ajisrawi/polarization-crpa/hardware/antenna/array_plate/render_bottom.png

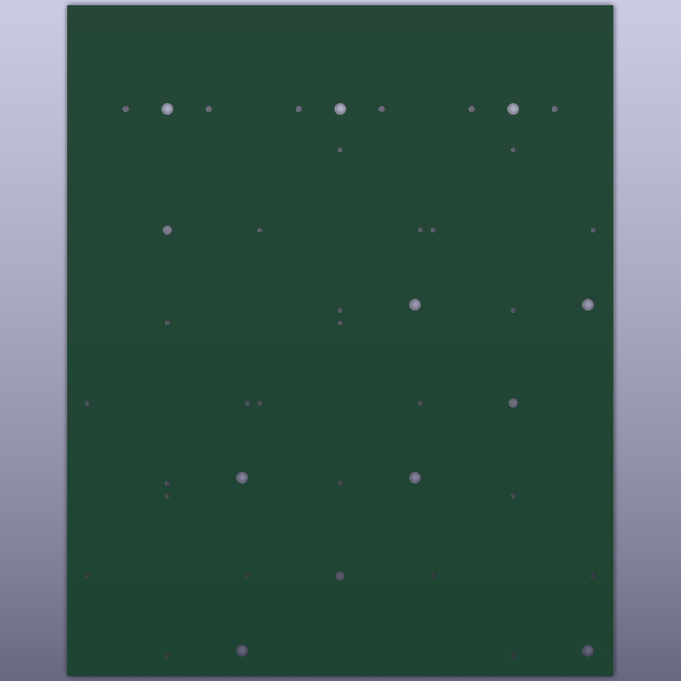
hardware/antenna/array_plate/render_bottom.png
