ajisrawi/polarization-crpa/hardware/antenna/array_plate/render_top.png

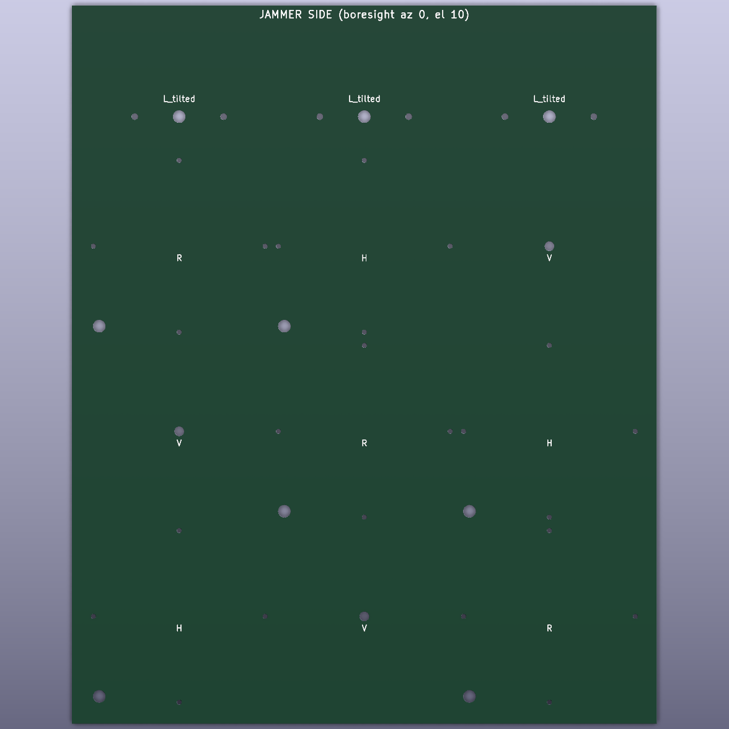
hardware/antenna/array_plate/render_top.png
