ajisrawi/polarization-crpa/hardware/antenna/feed_circular/render_bottom.png

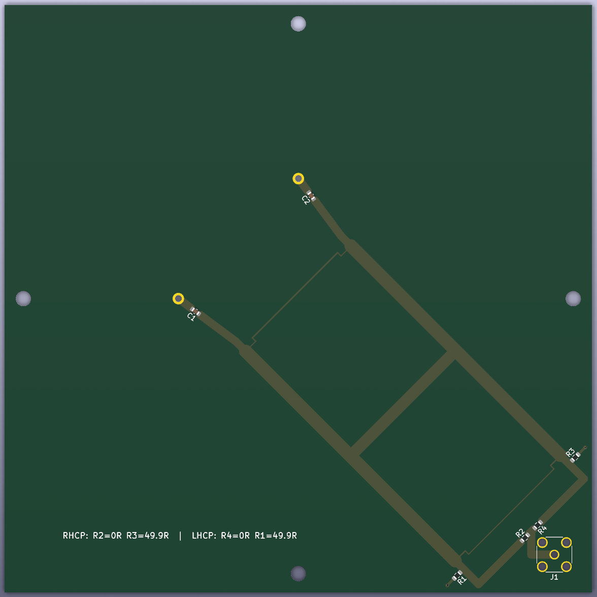
hardware/antenna/feed_circular/render_bottom.png
