ajisrawi/polarization-crpa/hardware/antenna/feed_circular/render_top.png

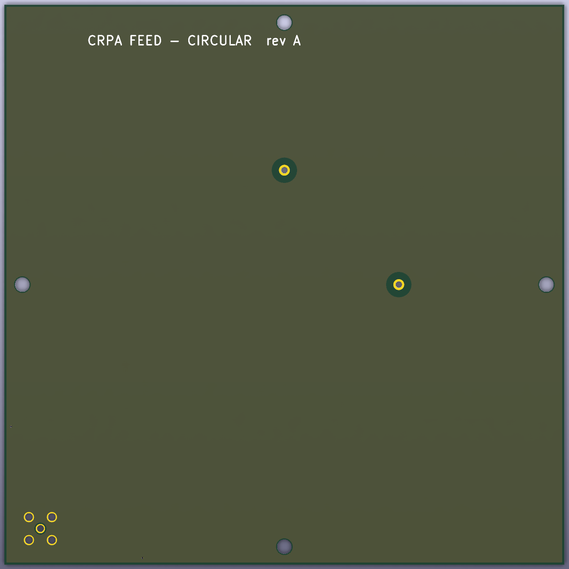
hardware/antenna/feed_circular/render_top.png
