ajisrawi/polarization-crpa/hardware/antenna/feed_linear_000/render_bottom.png

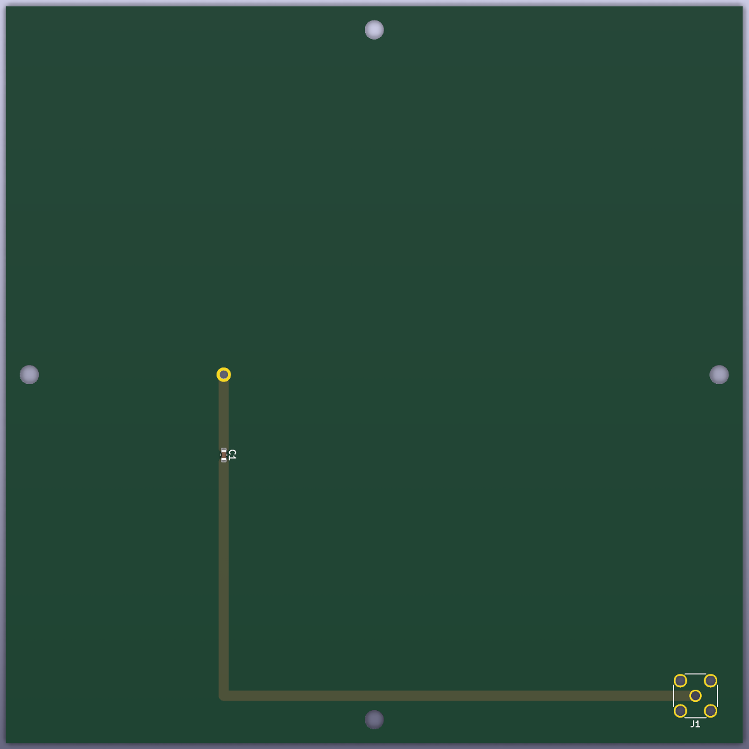
hardware/antenna/feed_linear_000/render_bottom.png
