ajisrawi/polarization-crpa/hardware/antenna/feed_linear_060/render_bottom.png

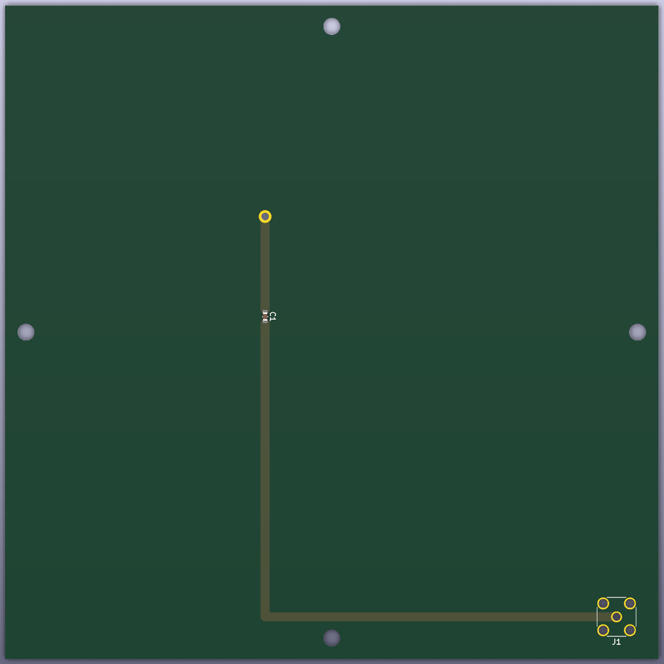
hardware/antenna/feed_linear_060/render_bottom.png
