ajisrawi/polarization-crpa/hardware/antenna/feed_linear_120/render_bottom.png

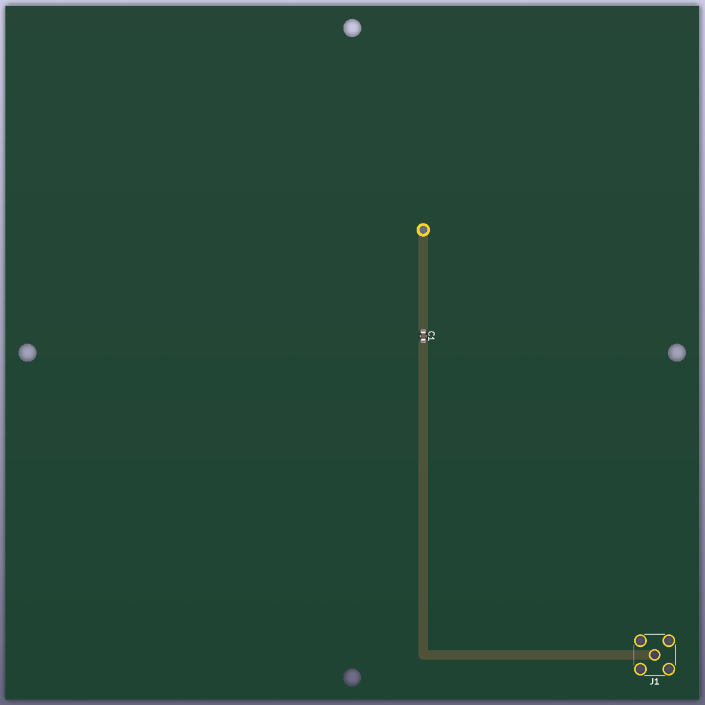
hardware/antenna/feed_linear_120/render_bottom.png
