ajisrawi/polarization-crpa/hardware/antenna/hybrid_response.png

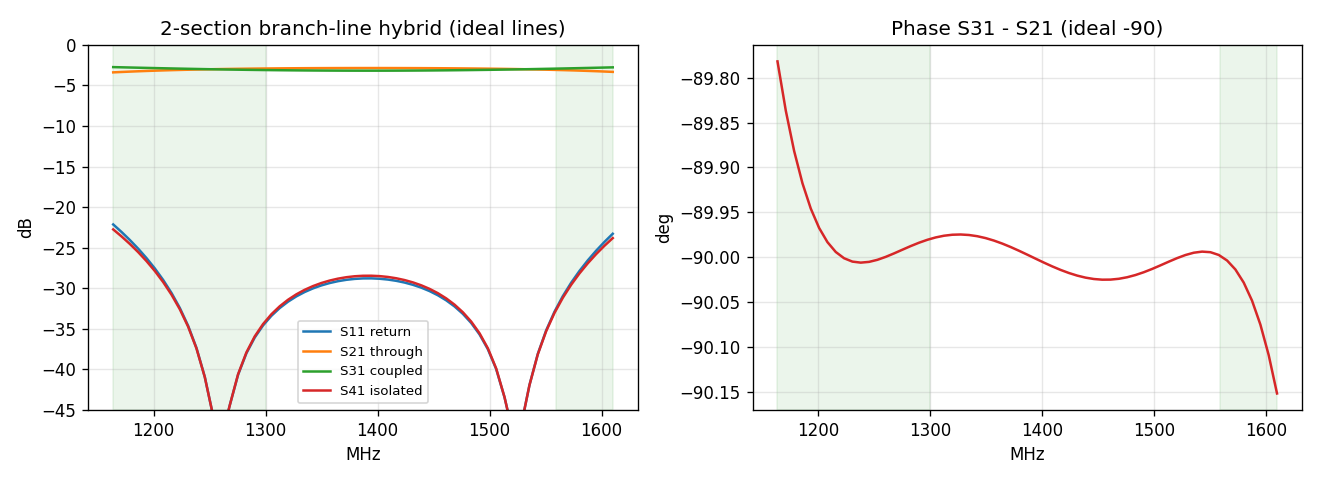
hardware/antenna/hybrid_response.png
