ajisrawi/polarization-crpa/hardware/antenna/patch_lower/render_bottom.png

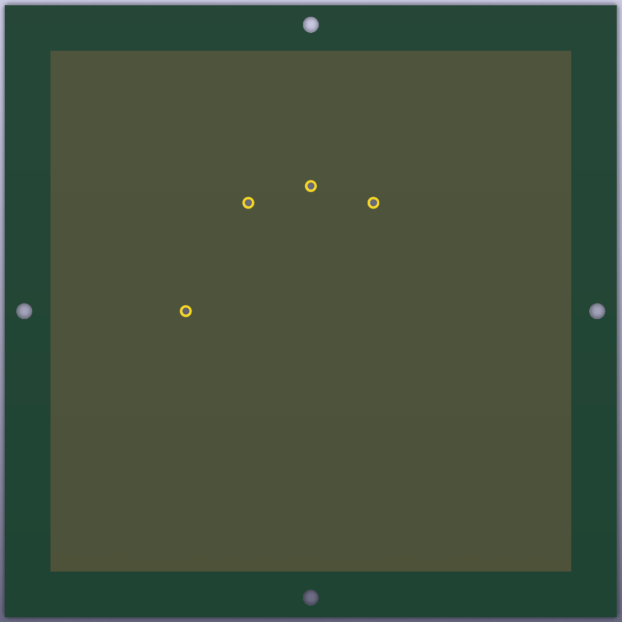
hardware/antenna/patch_lower/render_bottom.png
