ajisrawi/polarization-crpa/hardware/antenna/patch_lower/render_top.png

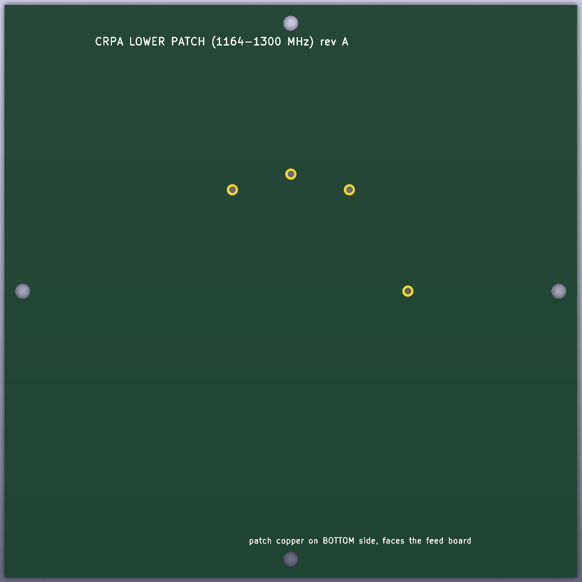
hardware/antenna/patch_lower/render_top.png
