ajisrawi/polarization-crpa/hardware/antenna/patch_upper/render_bottom.png

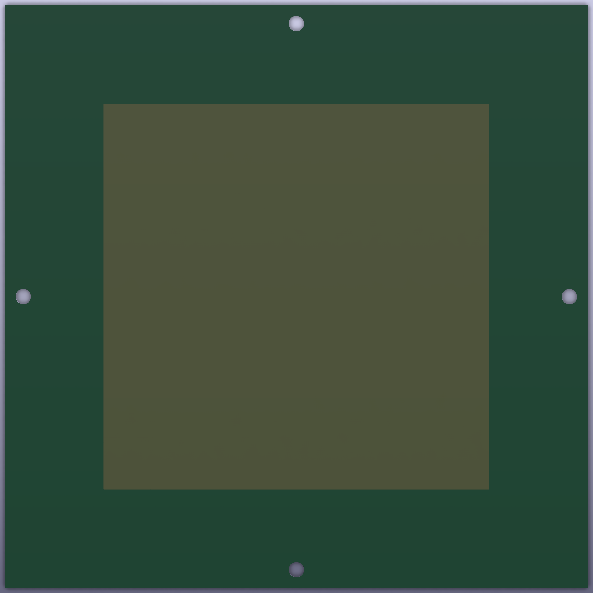
hardware/antenna/patch_upper/render_bottom.png
