ajisrawi/polarization-crpa/hardware/antenna/render3d/array_iso.png

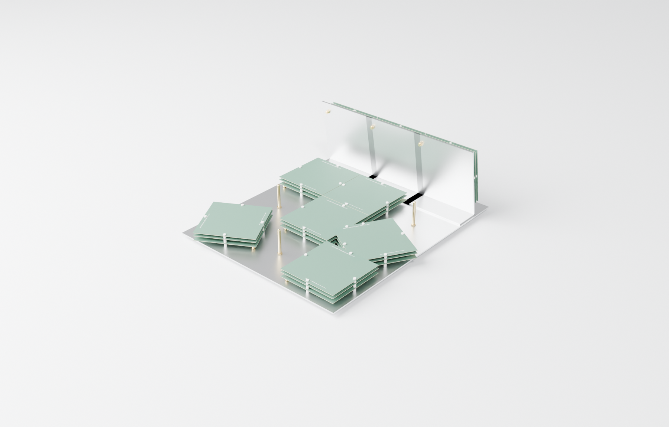
hardware/antenna/render3d/array_iso.png
