ajisrawi/polarization-crpa/hardware/antenna/render3d/array_jammer_side.png

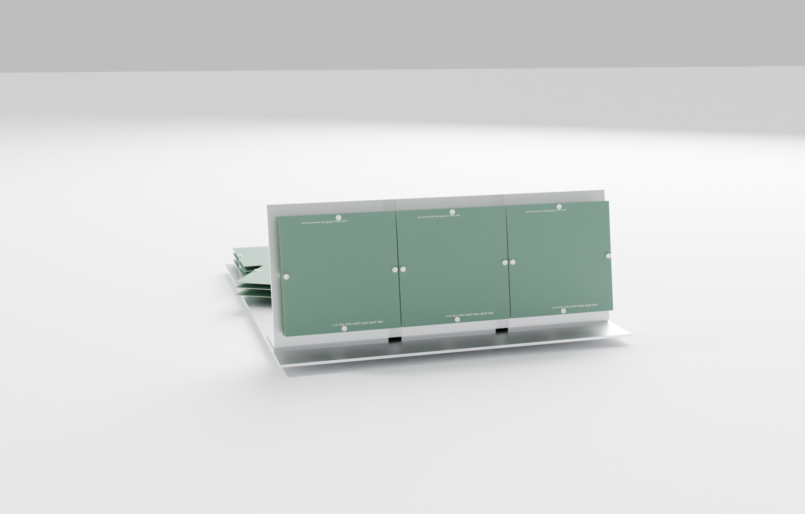
hardware/antenna/render3d/array_jammer_side.png
