ajisrawi/polarization-crpa/hardware/antenna/render3d/array_top.png

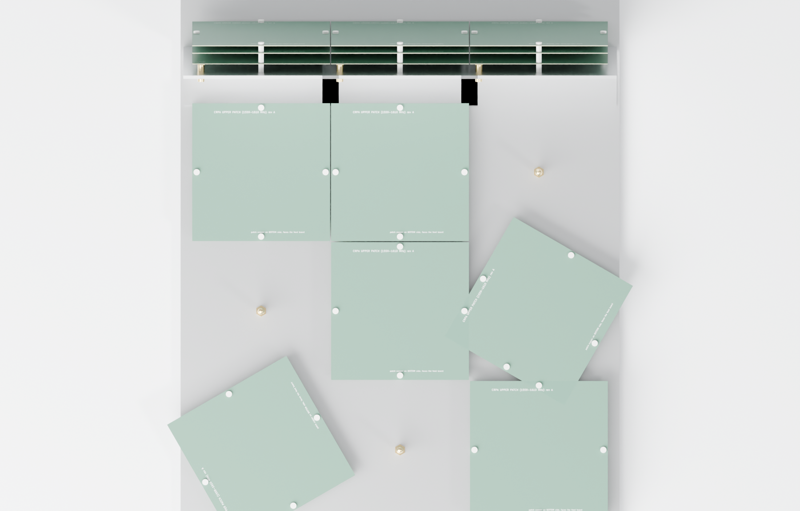
hardware/antenna/render3d/array_top.png
