ajisrawi/polarization-crpa/hardware/antenna_tmm/feed_circular/render_bottom.png

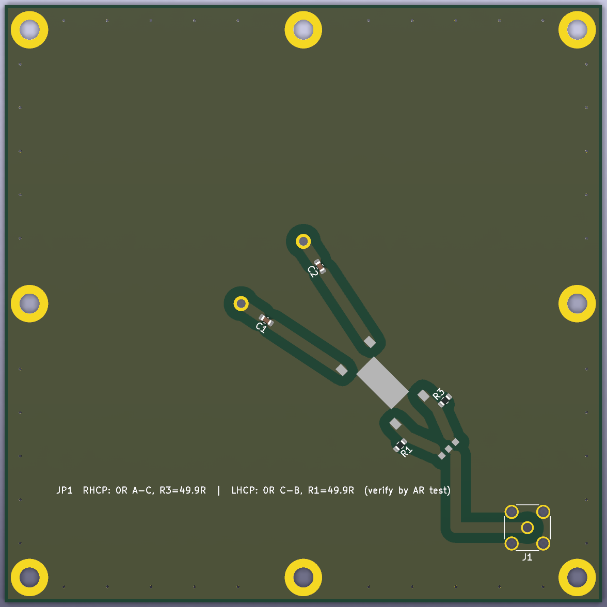
hardware/antenna_tmm/feed_circular/render_bottom.png
