ajisrawi/polarization-crpa/hardware/antenna_tmm/feed_circular/render_top.png

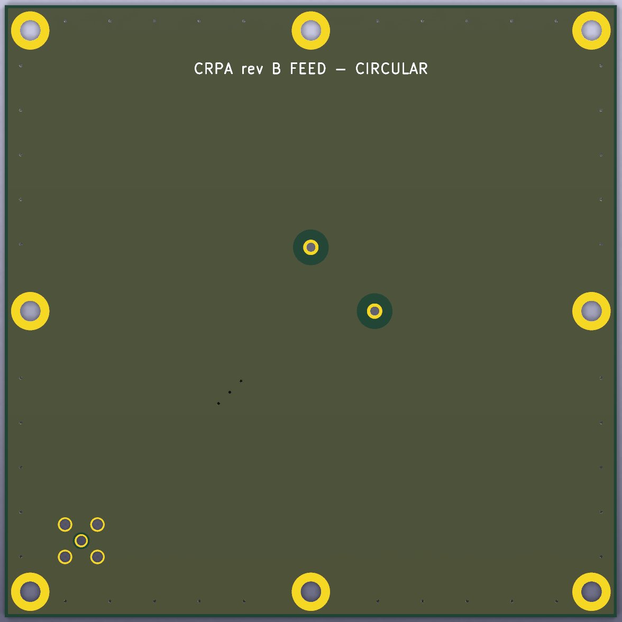
hardware/antenna_tmm/feed_circular/render_top.png
