ajisrawi/polarization-crpa/hardware/antenna_tmm/feed_linear_000/render_bottom.png

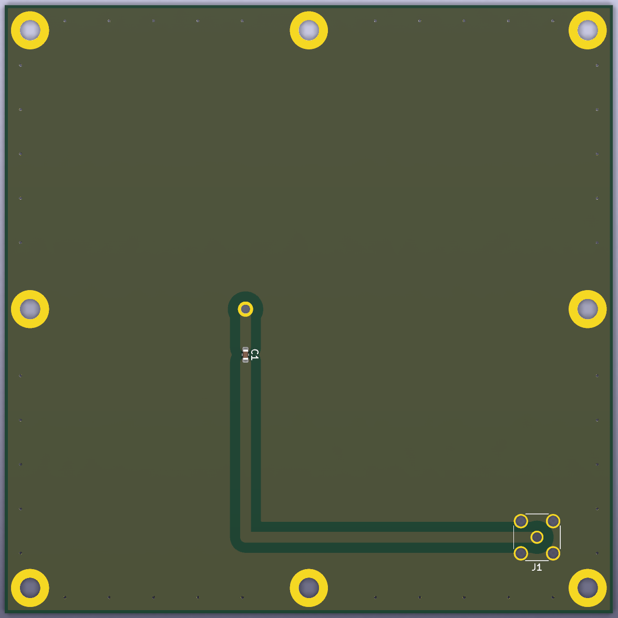
hardware/antenna_tmm/feed_linear_000/render_bottom.png
