ajisrawi/polarization-crpa/hardware/antenna_tmm/feed_linear_060/render_bottom.png

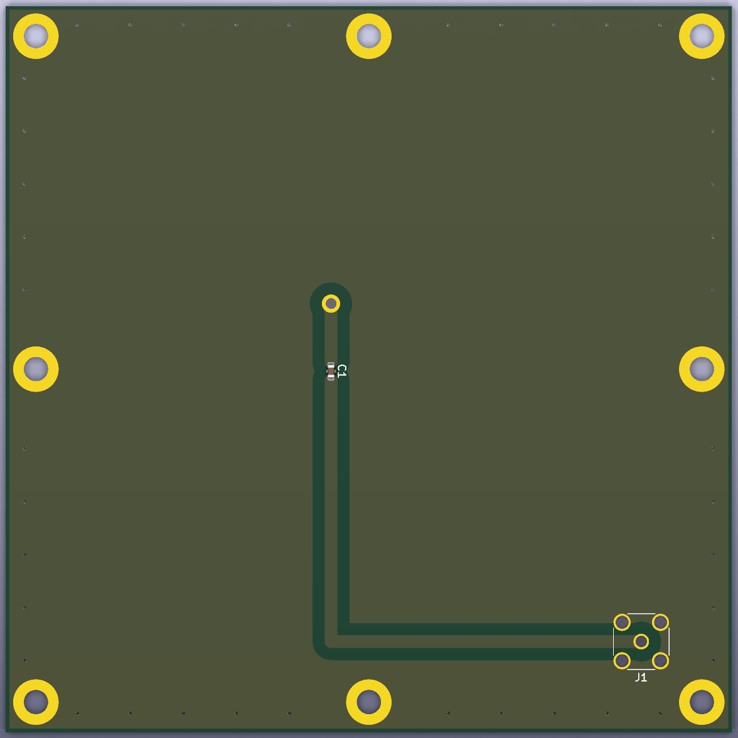
hardware/antenna_tmm/feed_linear_060/render_bottom.png
