ajisrawi/polarization-crpa/hardware/antenna_tmm/render3d/array_iso.png

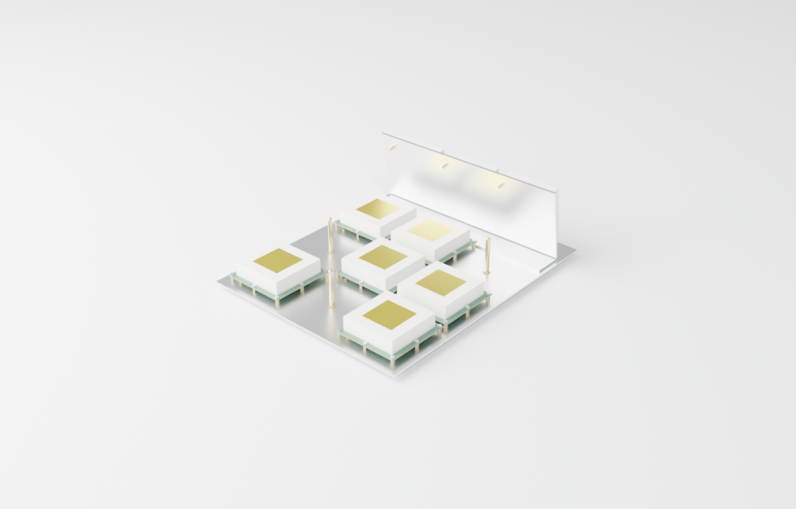
hardware/antenna_tmm/render3d/array_iso.png
