ajisrawi/polarization-crpa/hardware/antenna_tmm/render3d/array_jammer_side.png

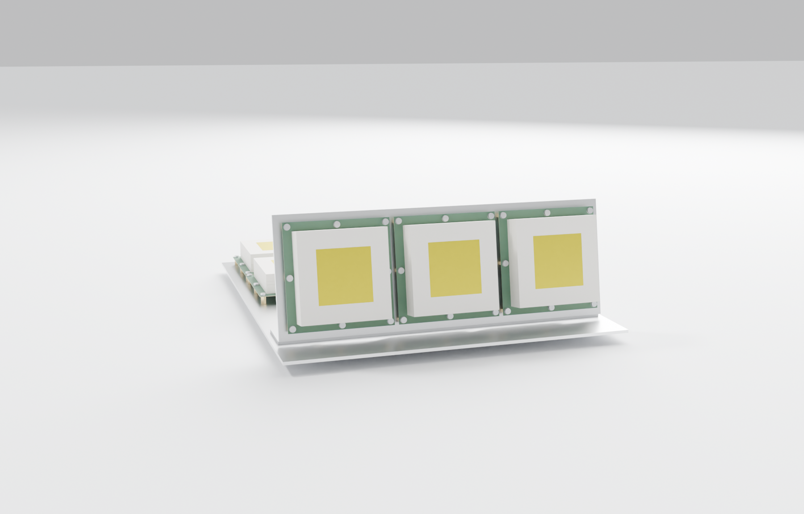
hardware/antenna_tmm/render3d/array_jammer_side.png
