ajisrawi/polarization-crpa/hardware/antenna_tmm/render3d/array_top.png

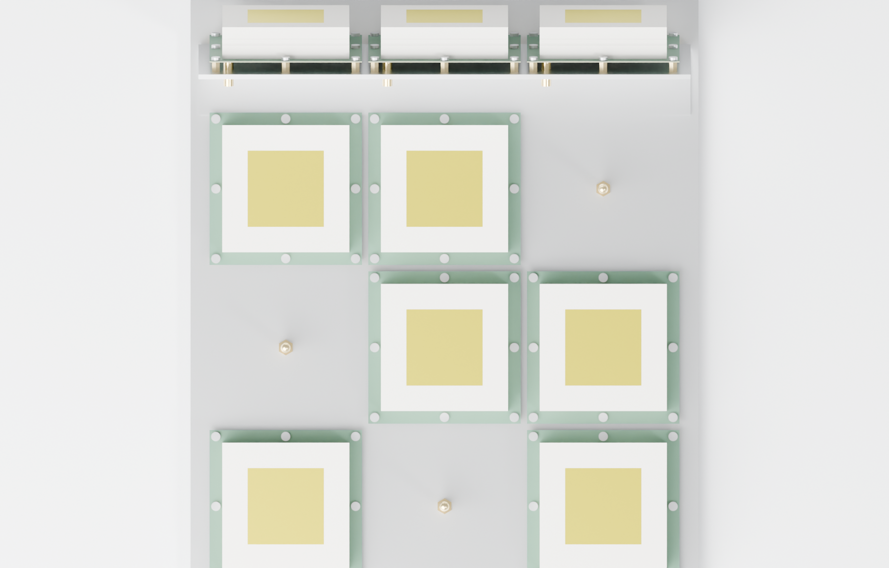
hardware/antenna_tmm/render3d/array_top.png
