ajisrawi/polarization-crpa/hardware/antenna_tmm/render3d/element_exploded.png

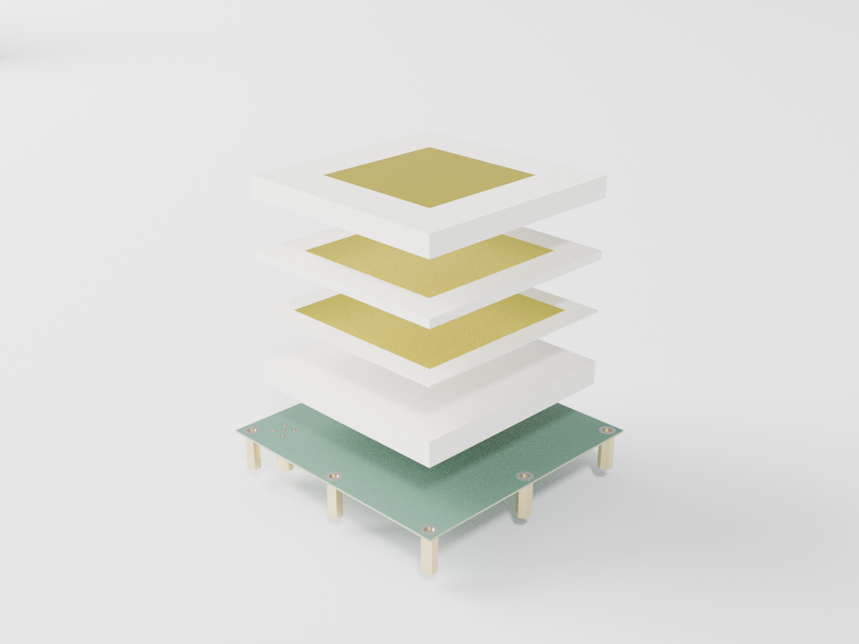
hardware/antenna_tmm/render3d/element_exploded.png
