ajisrawi/polarization-crpa/hardware/antenna_tmm/slab_A1_circ/render_bottom.png

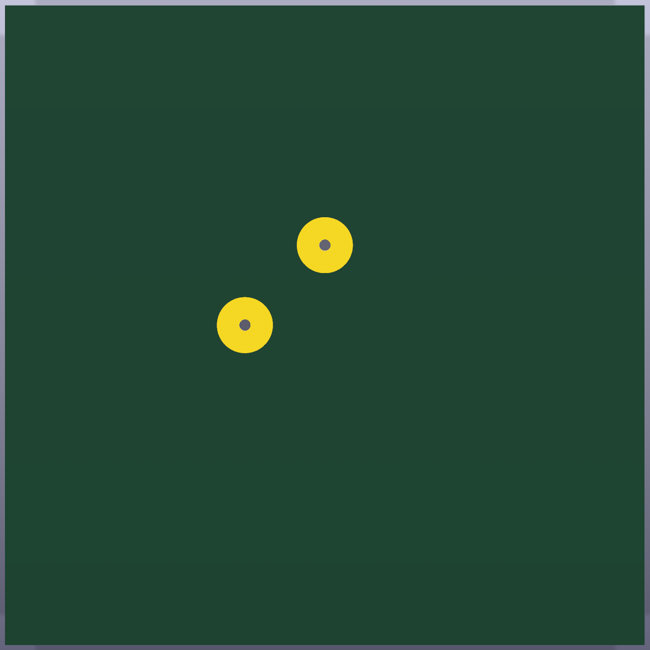
hardware/antenna_tmm/slab_A1_circ/render_bottom.png
