ajisrawi/polarization-crpa/hardware/antenna_tmm/slab_A1_circ/render_top.png

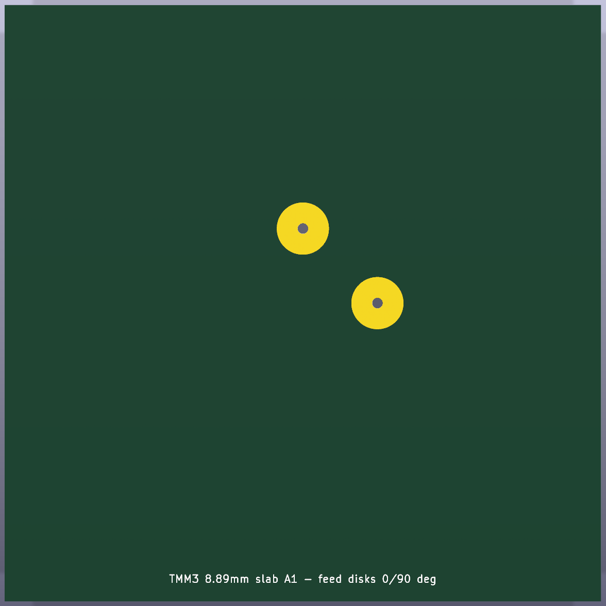
hardware/antenna_tmm/slab_A1_circ/render_top.png
