ajisrawi/polarization-crpa/hardware/antenna_tmm/slab_A1_lin120/render_top.png

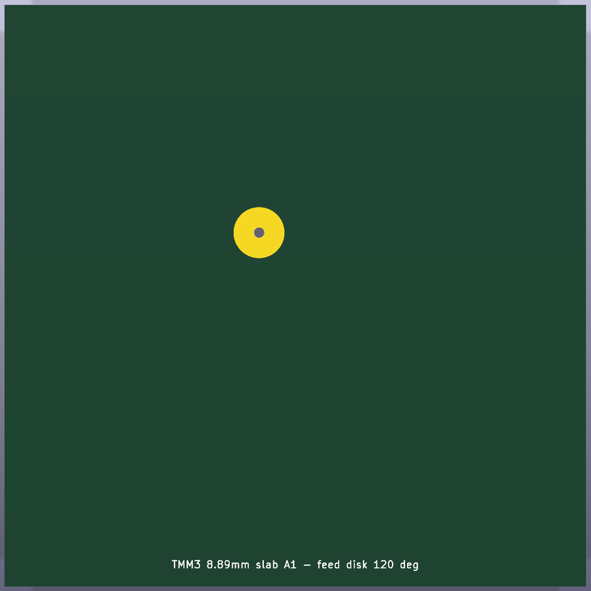
hardware/antenna_tmm/slab_A1_lin120/render_top.png
