ajisrawi/polarization-crpa/hardware/antenna_tmm/slab_A2/render_top.png

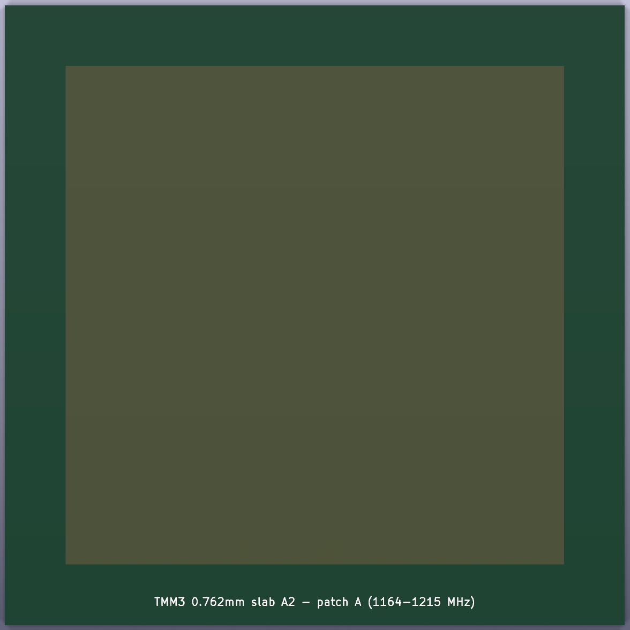
hardware/antenna_tmm/slab_A2/render_top.png
