ajisrawi/polarization-crpa/hardware/antenna_tmm/slab_B/render_top.png

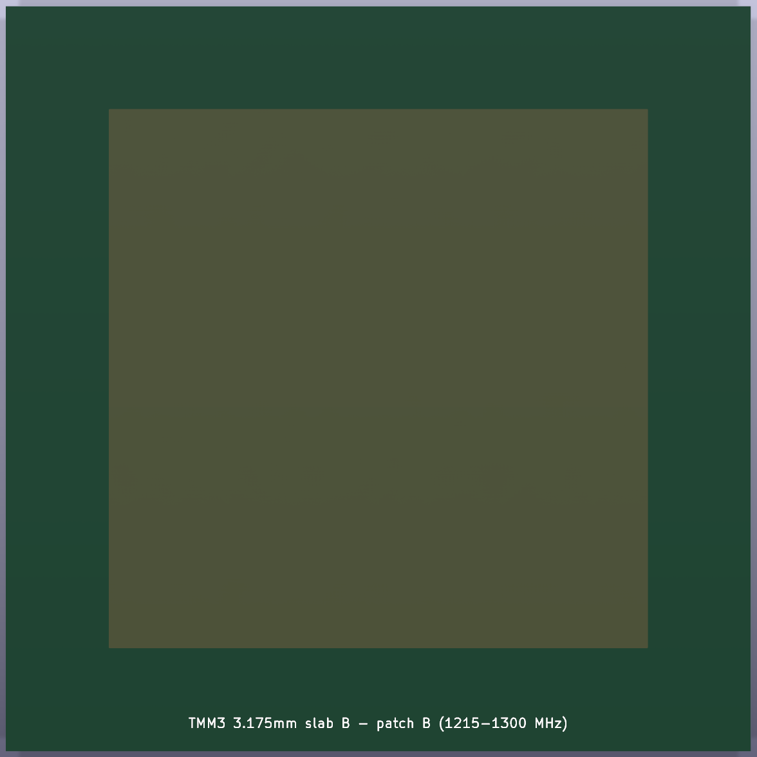
hardware/antenna_tmm/slab_B/render_top.png
