ajisrawi/polarization-crpa/hardware/antenna_tmm/slab_C/render_top.png

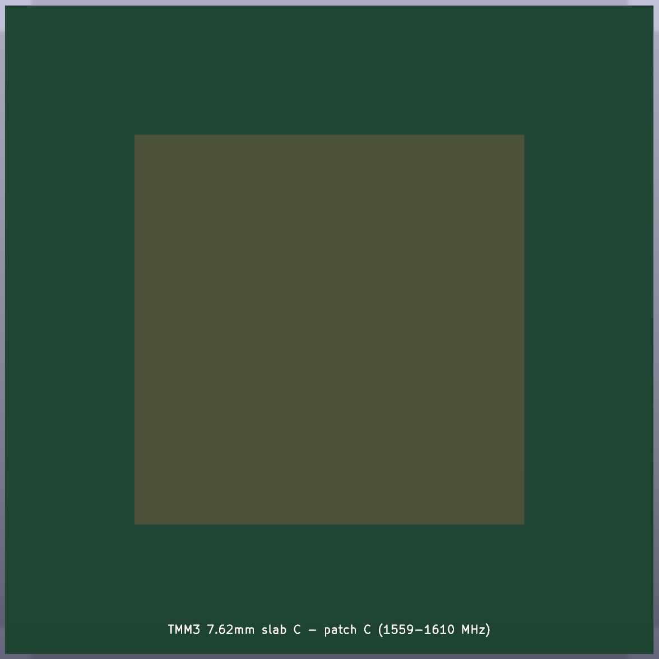
hardware/antenna_tmm/slab_C/render_top.png
