ajisrawi/polarization-crpa/hardware/dsp_gnss/dsp_gnss_preview.png

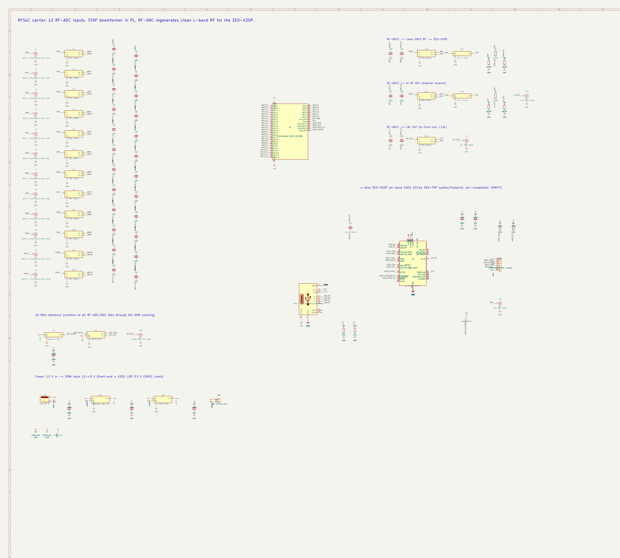
hardware/dsp_gnss/dsp_gnss_preview.png
