ajisrawi/polarization-crpa/hardware/rf_frontend/rf_frontend_preview.png

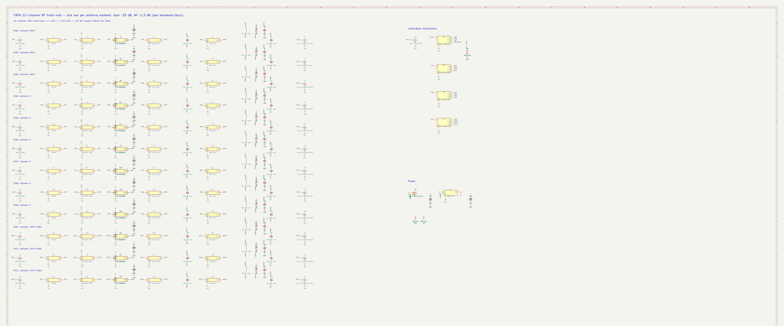
hardware/rf_frontend/rf_frontend_preview.png
