ajisrawi/polarization-crpa/hardware/antenna/array_plate/array_plate.dxf

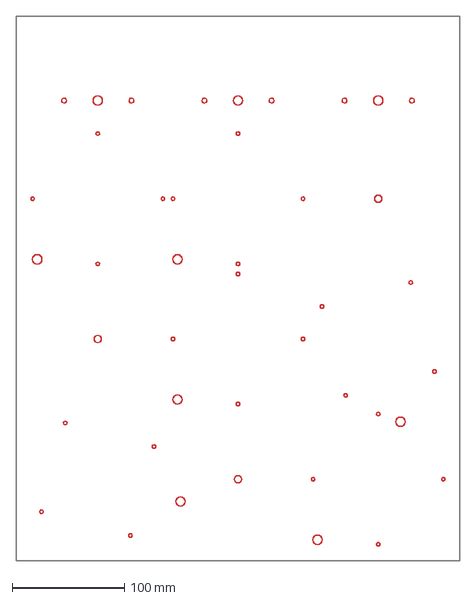
[picture p33: CAD file, 2026-10-11]
hardware/antenna/array_plate/array_plate.dxf
395.0 x 485.0 mm
