ajisrawi/polarization-crpa/hardware/antenna_tmm/array_plate/array_plate.dxf

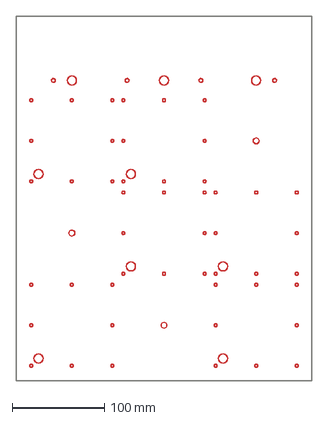
[picture p34: CAD file, 2026-10-11]
hardware/antenna_tmm/array_plate/array_plate.dxf
320.0 x 395.0 mm
