ajisrawi/polarization-crpa/hardware/em/results/air4_c3.png

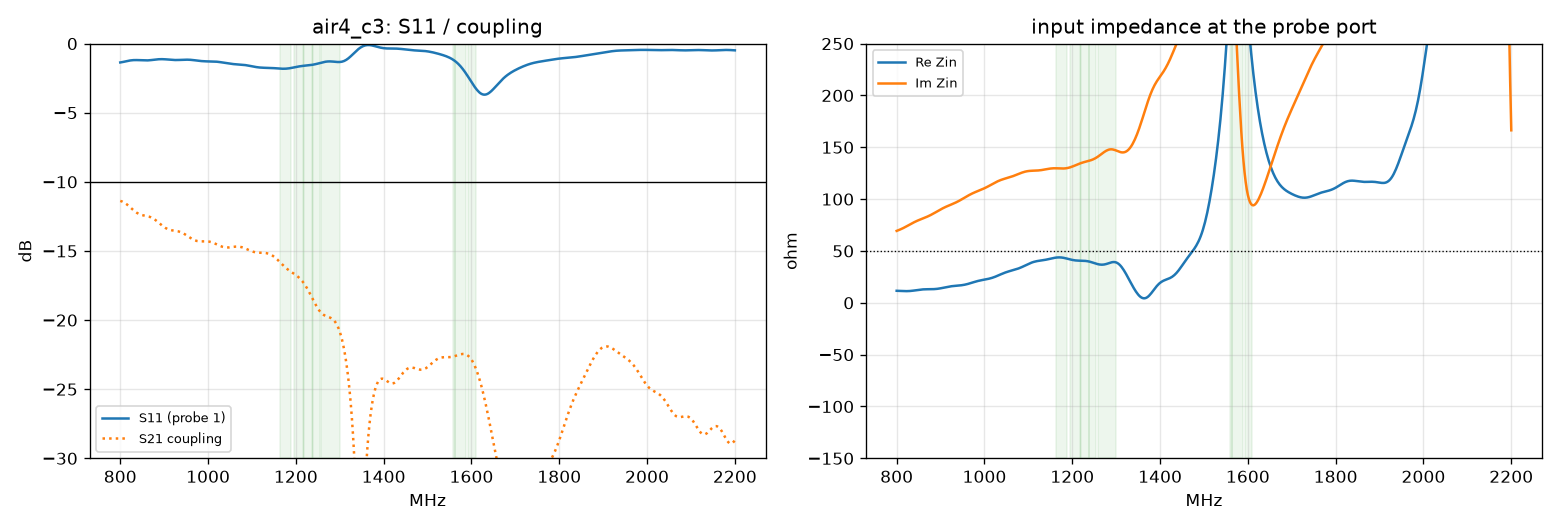
hardware/em/results/air4_c3.png
