ajisrawi/polarization-crpa/hardware/em/results/air4_c4.png

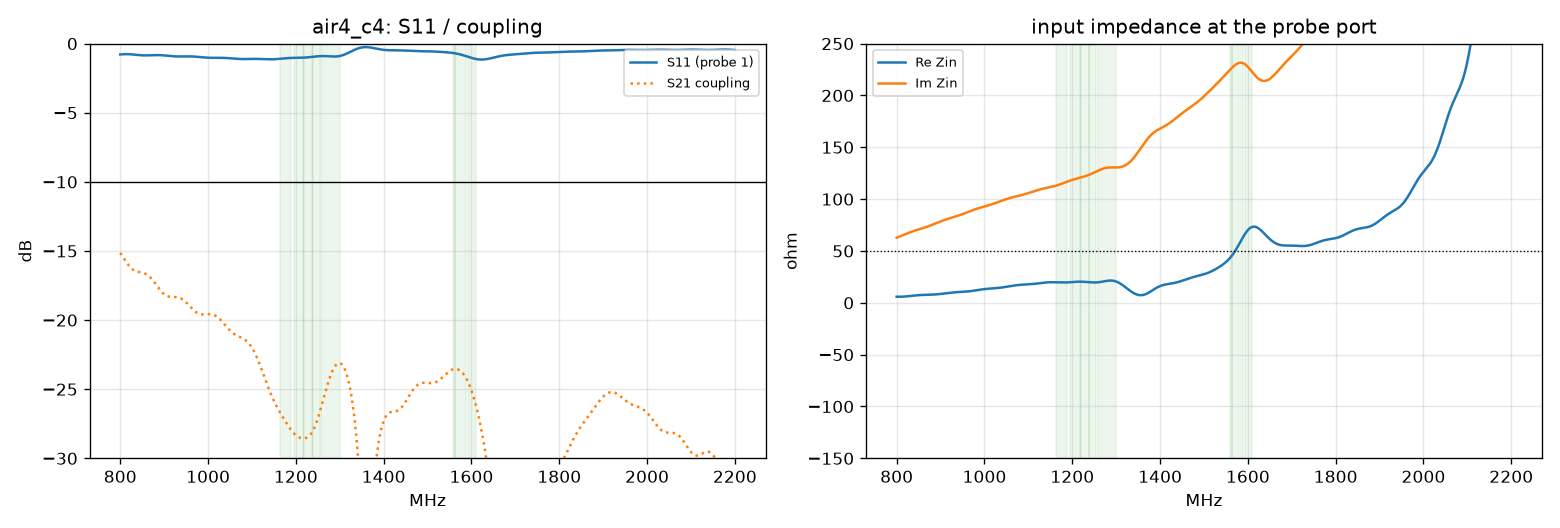
hardware/em/results/air4_c4.png
