ajisrawi/polarization-crpa/hardware/em/results/air4_c5.png

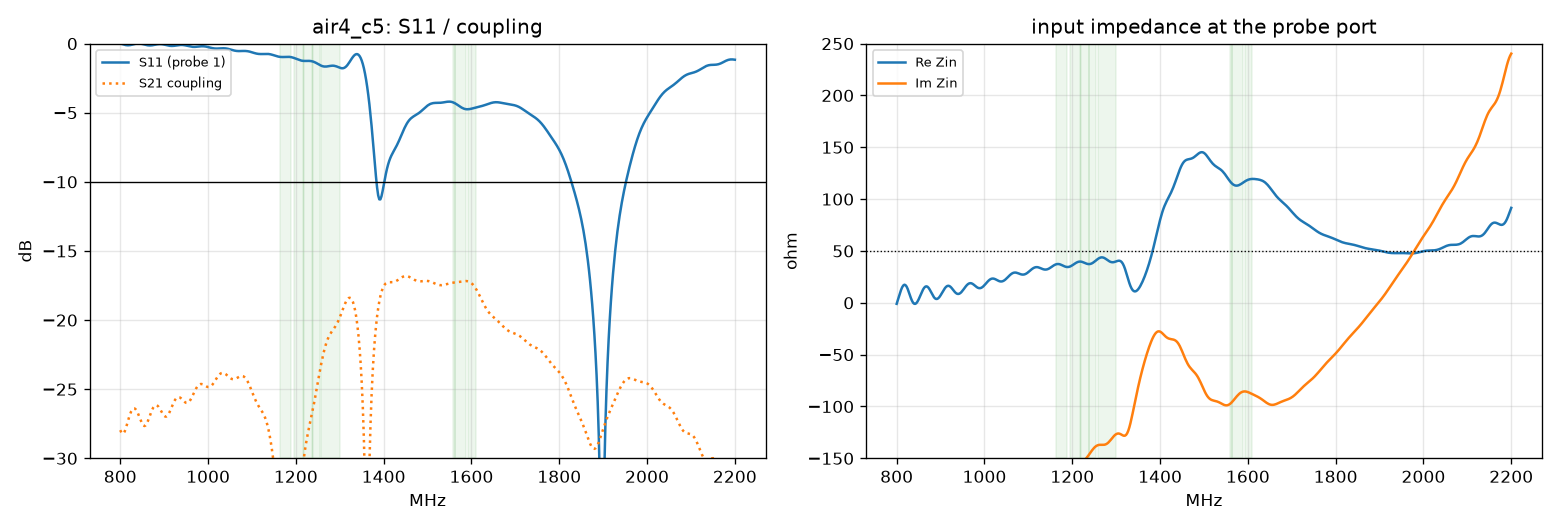
hardware/em/results/air4_c5.png
