ajisrawi/polarization-crpa/hardware/em/results/air4_c5_full.png

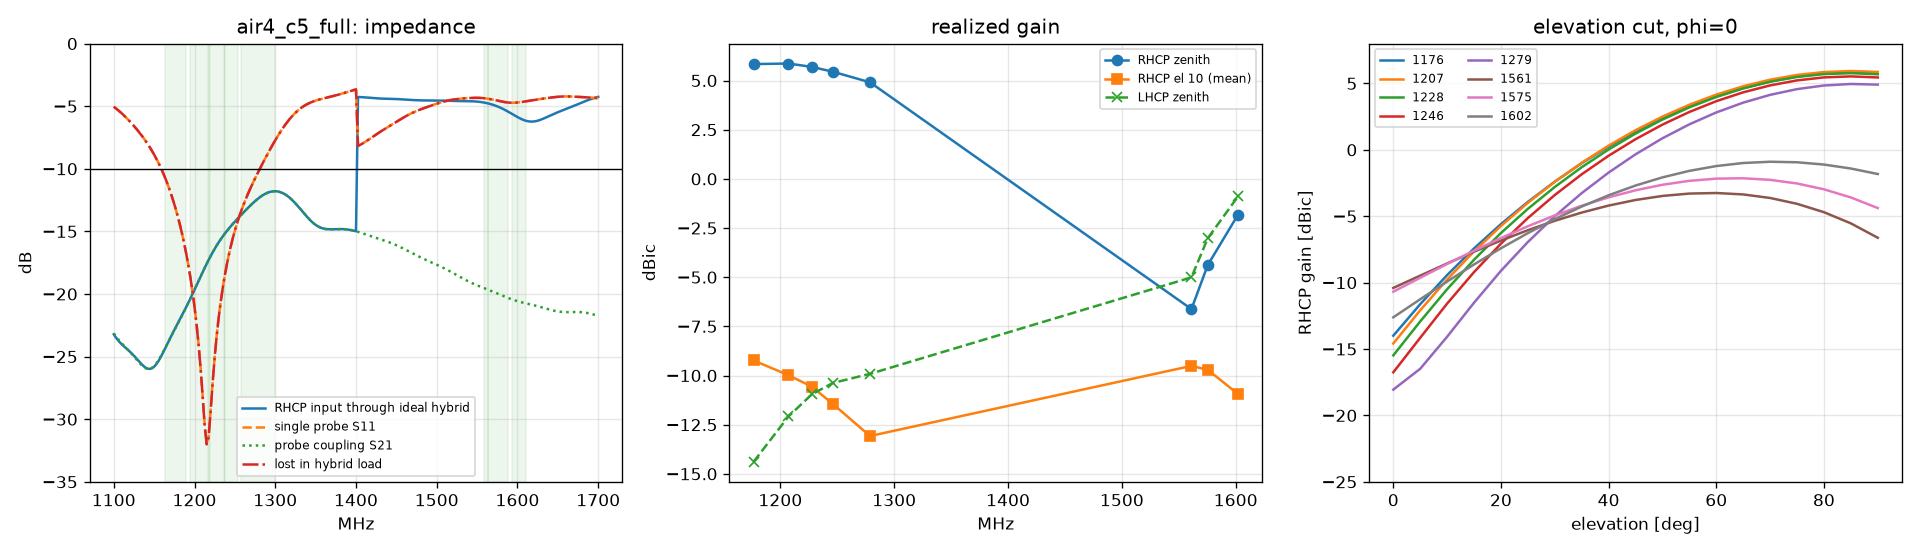
hardware/em/results/air4_c5_full.png
