ajisrawi/polarization-crpa/hardware/em/results/air4_c6.png

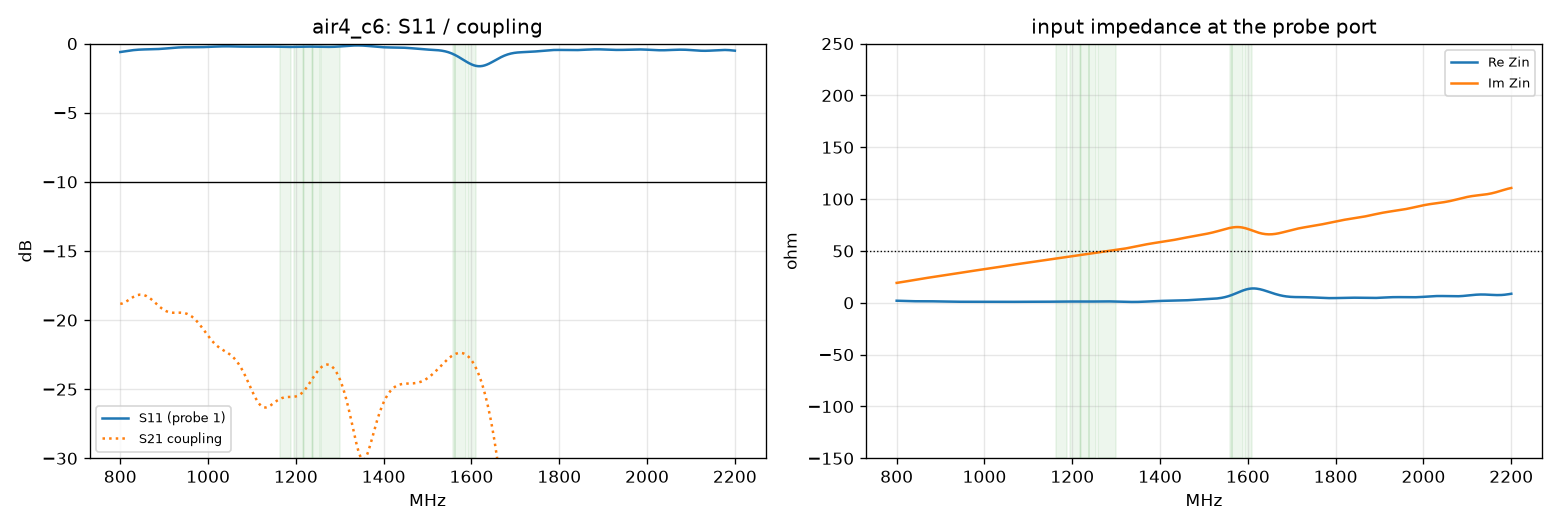
hardware/em/results/air4_c6.png
