ajisrawi/polarization-crpa/hardware/em/results/air4_c9_full.png

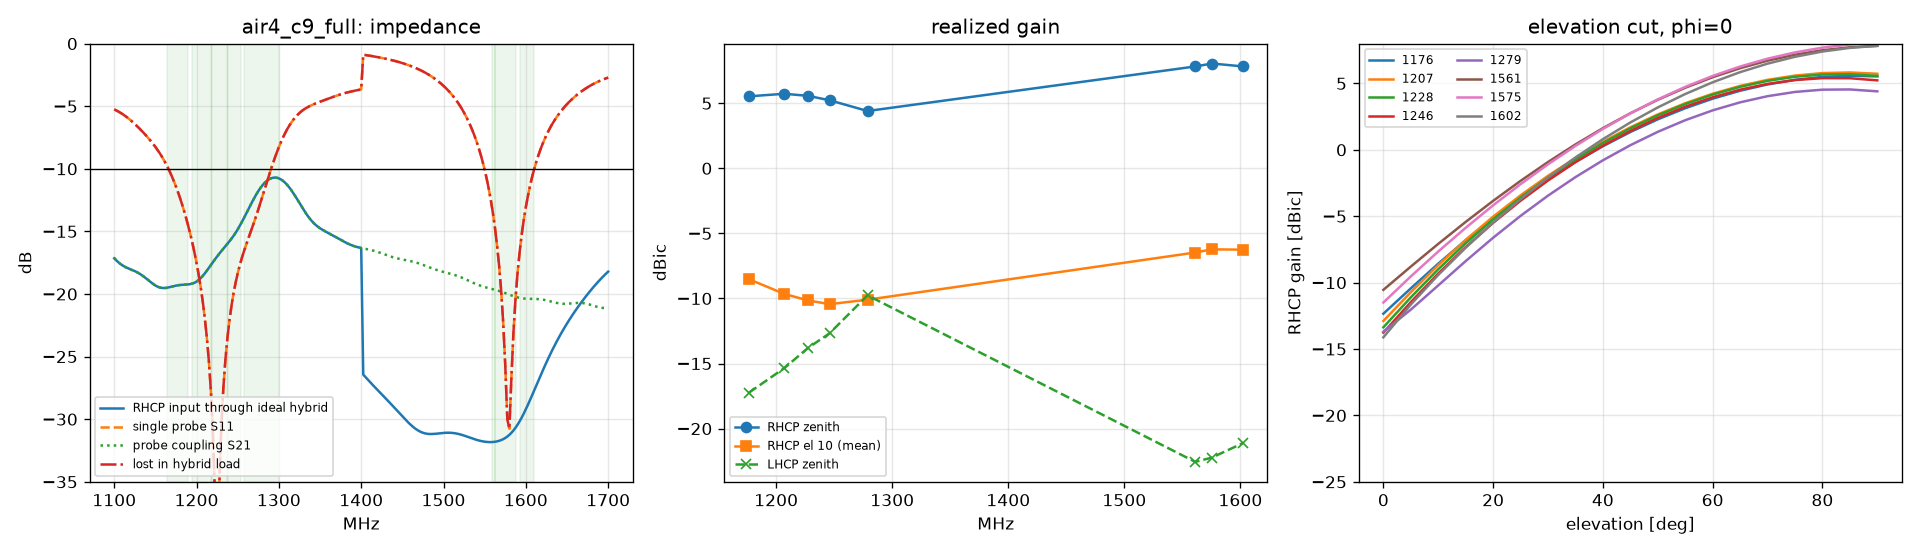
hardware/em/results/air4_c9_full.png
