ajisrawi/polarization-crpa/hardware/em/results/air4_c9_full_feed_network.png

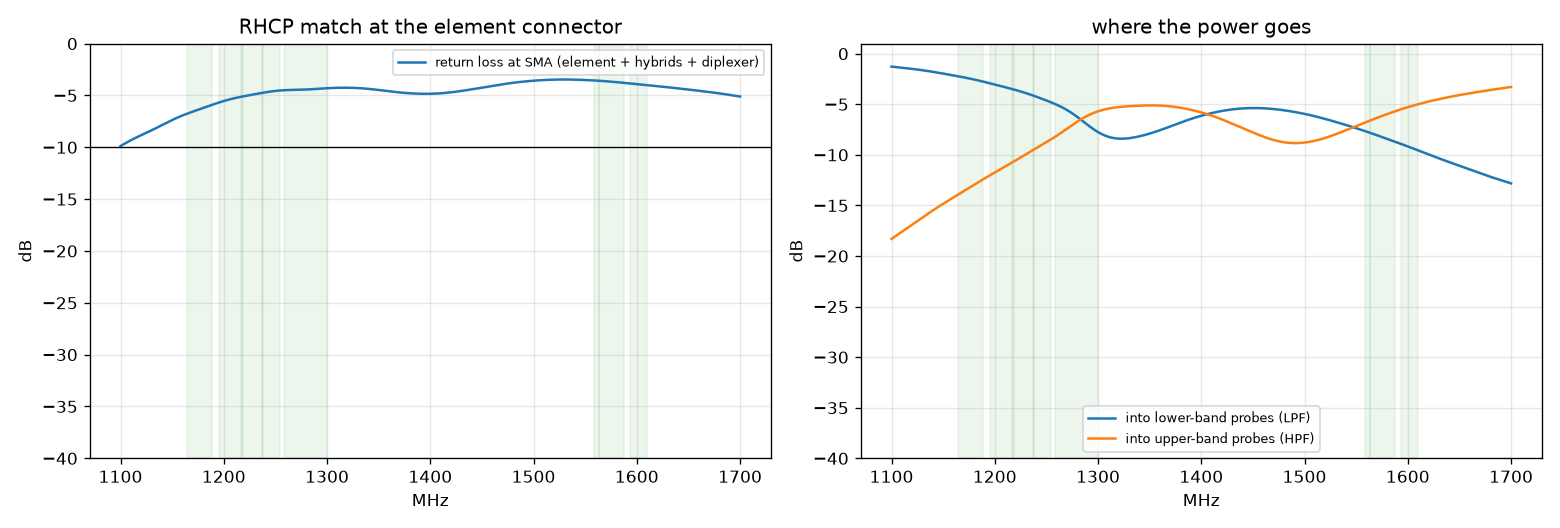
hardware/em/results/air4_c9_full_feed_network.png
