ajisrawi/polarization-crpa/hardware/em/results/baseline.png

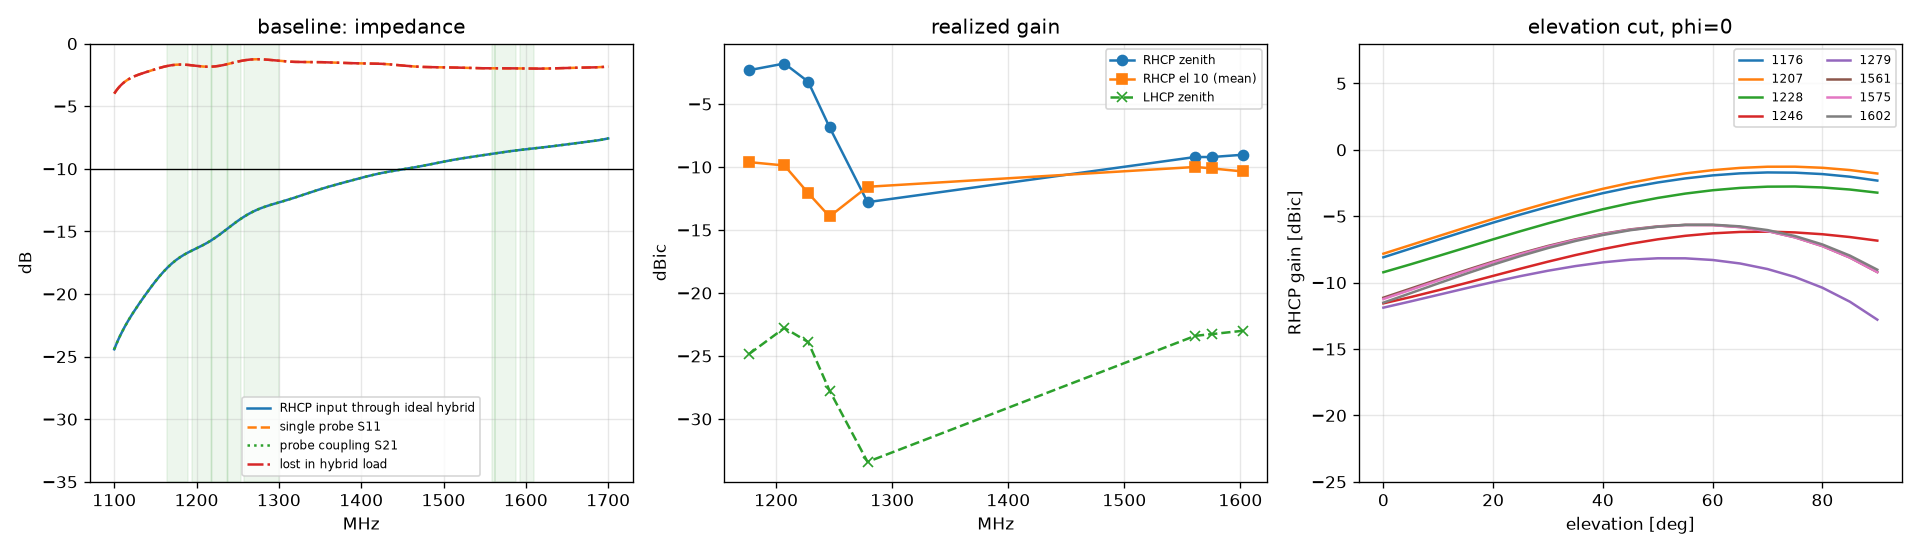
hardware/em/results/baseline.png
