ajisrawi/polarization-crpa/results/exp1_tilt_sweep.png

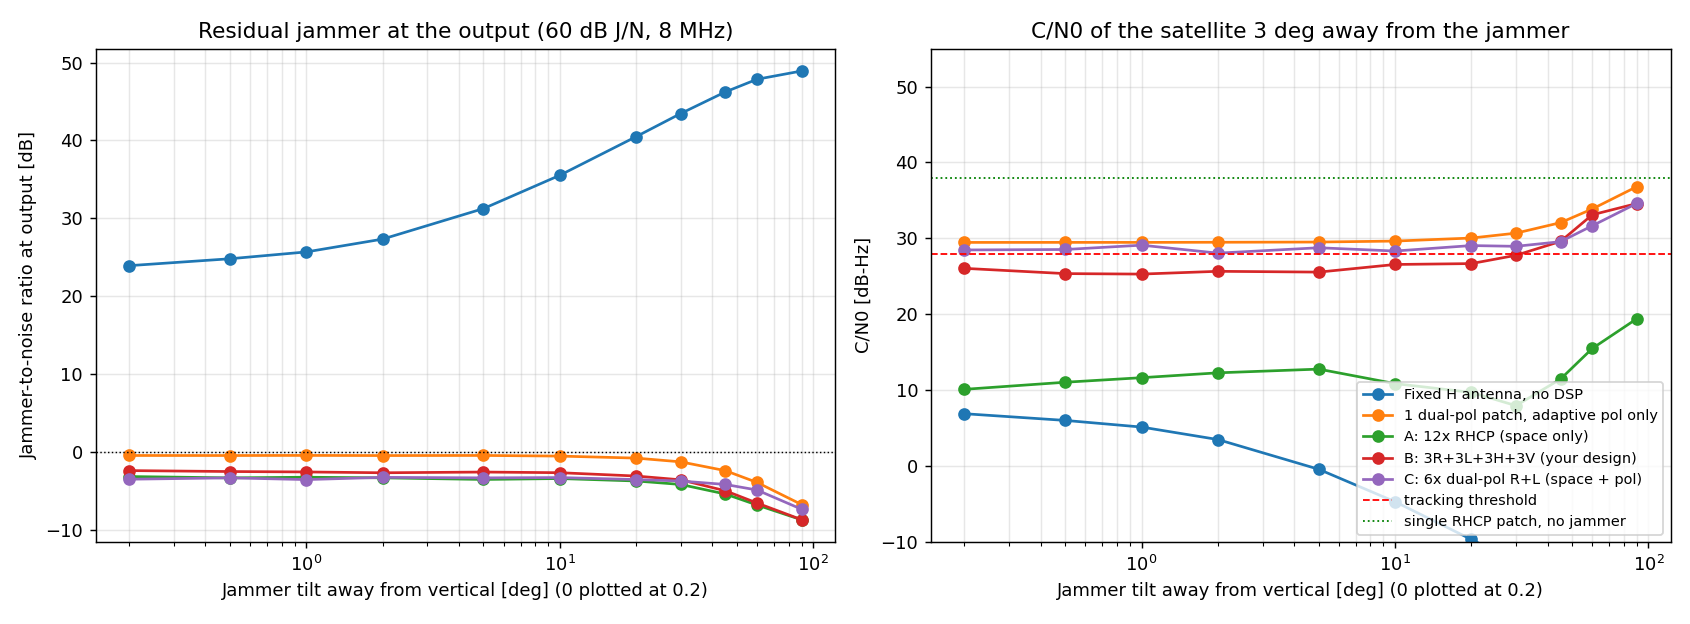
results/exp1_tilt_sweep.png
