ajisrawi/polarization-crpa/results/exp2_cn0_per_satellite.png

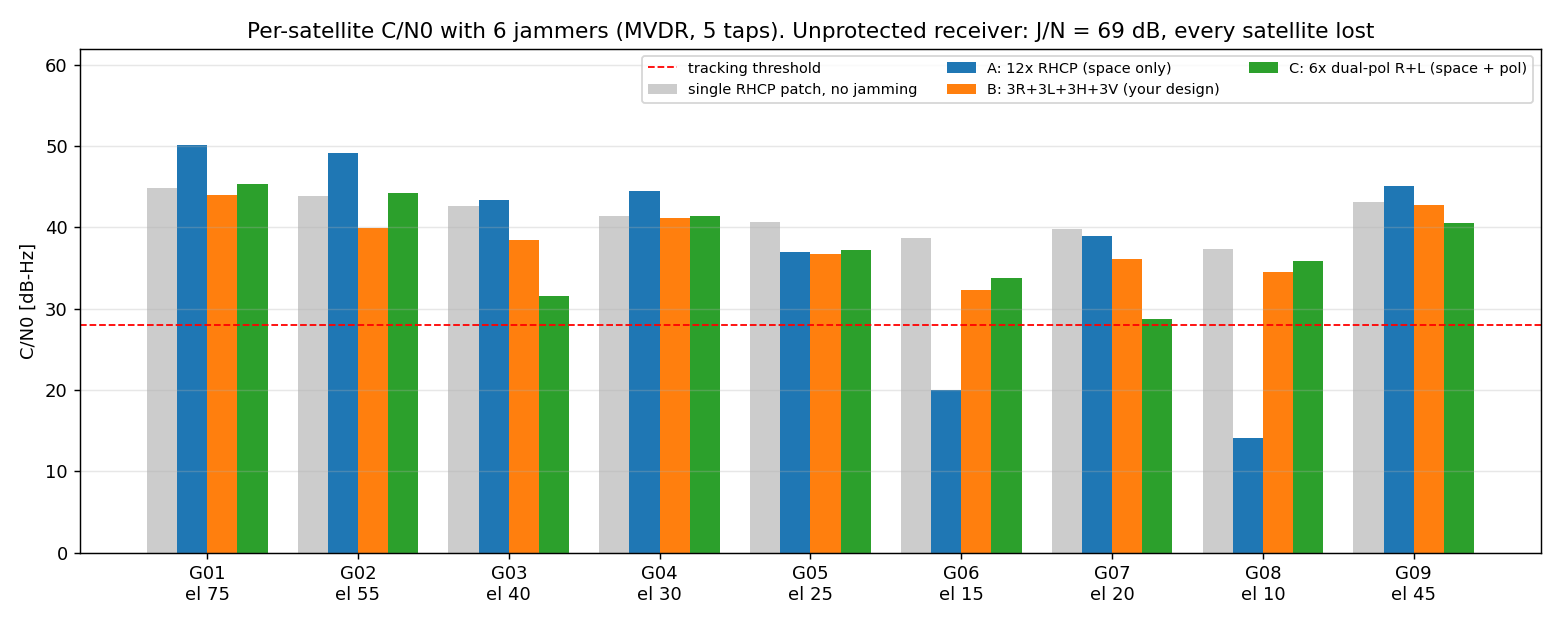
results/exp2_cn0_per_satellite.png
