ajisrawi/polarization-crpa/results/exp2_sky_maps.png

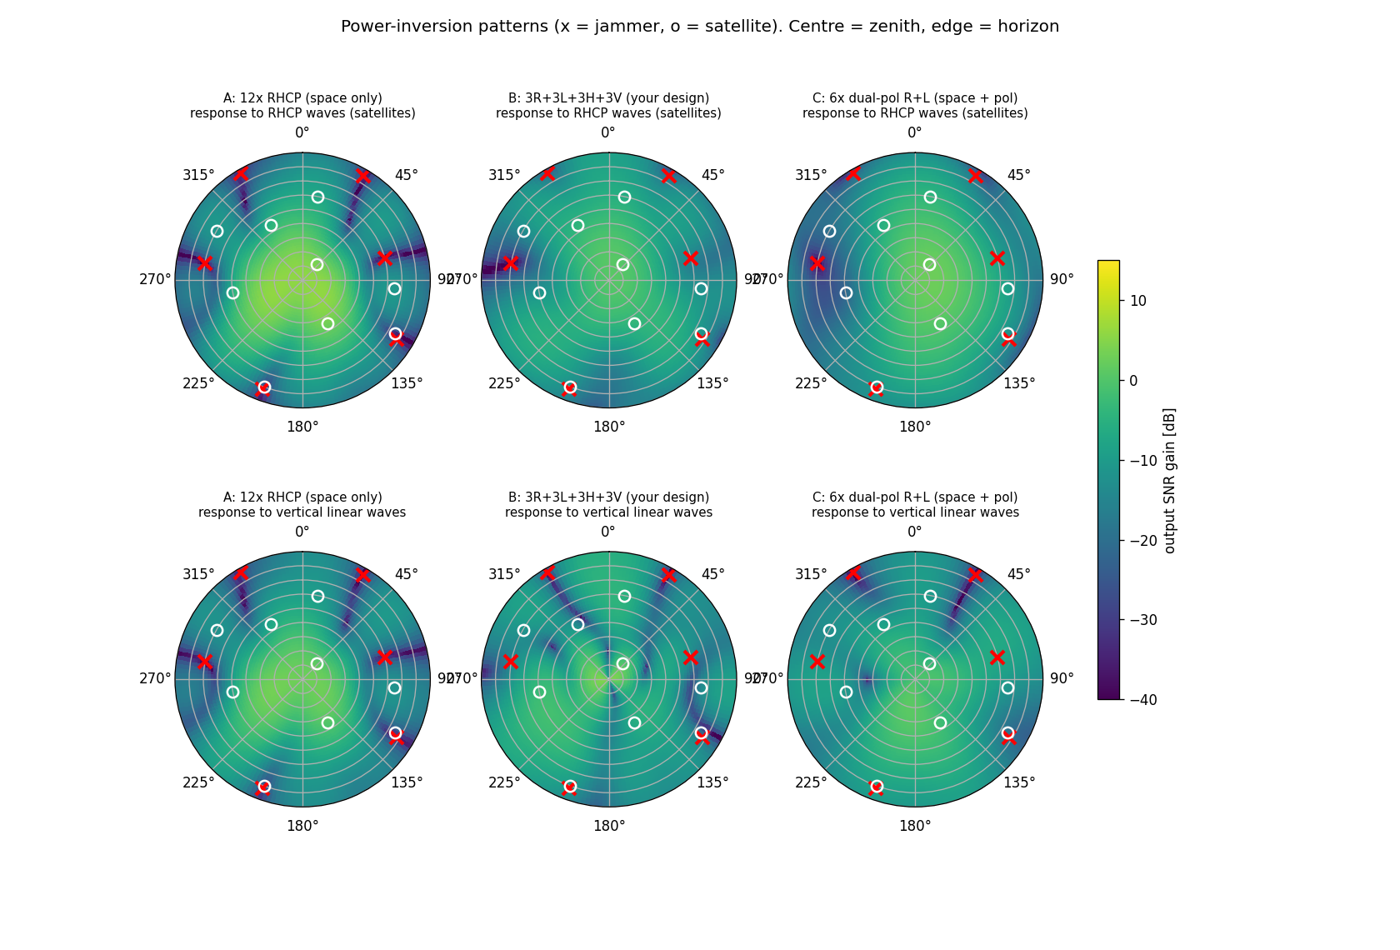
results/exp2_sky_maps.png
