ajisrawi/polarization-crpa/results/exp3_jammer_count.png

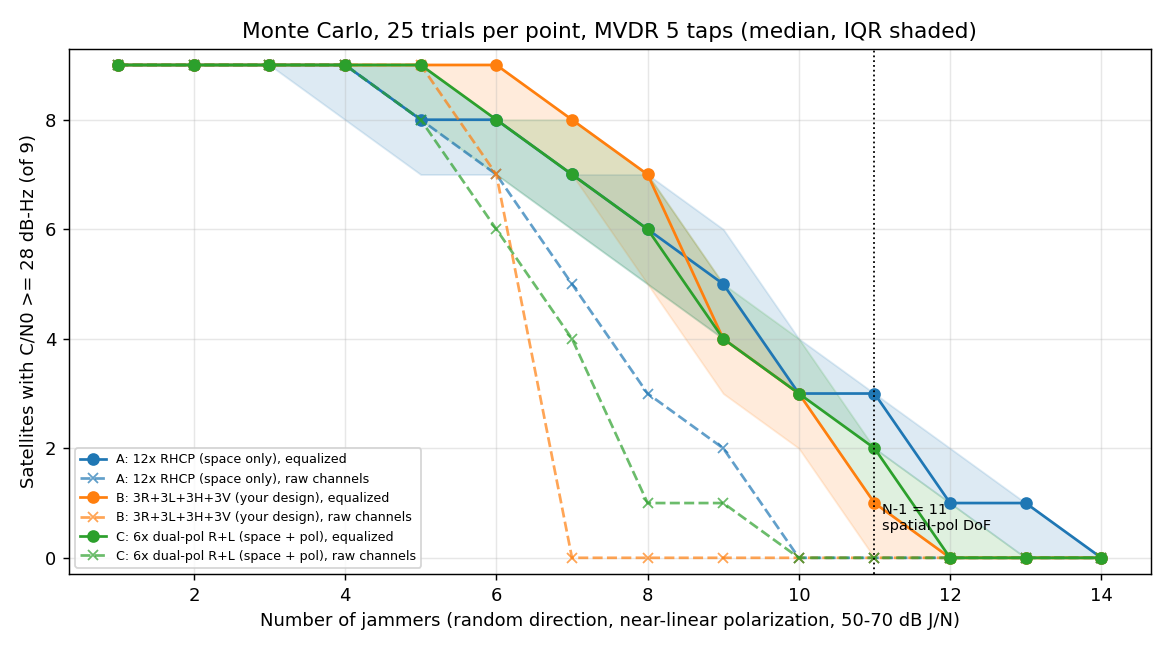
results/exp3_jammer_count.png
