ajisrawi/polarization-crpa/results/rhcp_jammer_power_sweep.png

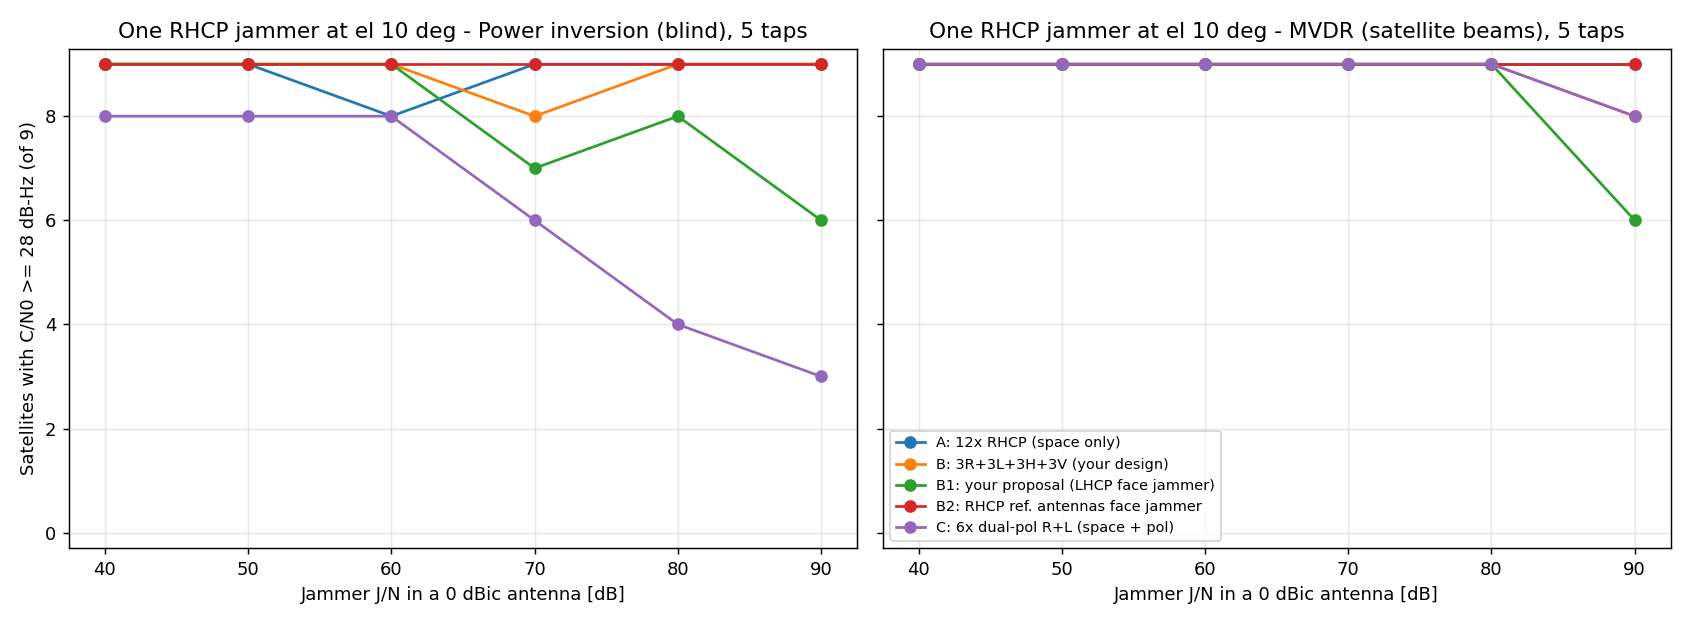
results/rhcp_jammer_power_sweep.png
