ajisrawi/polarization-crpa/hardware/dsp_gnss/dsp_gnss.pdf

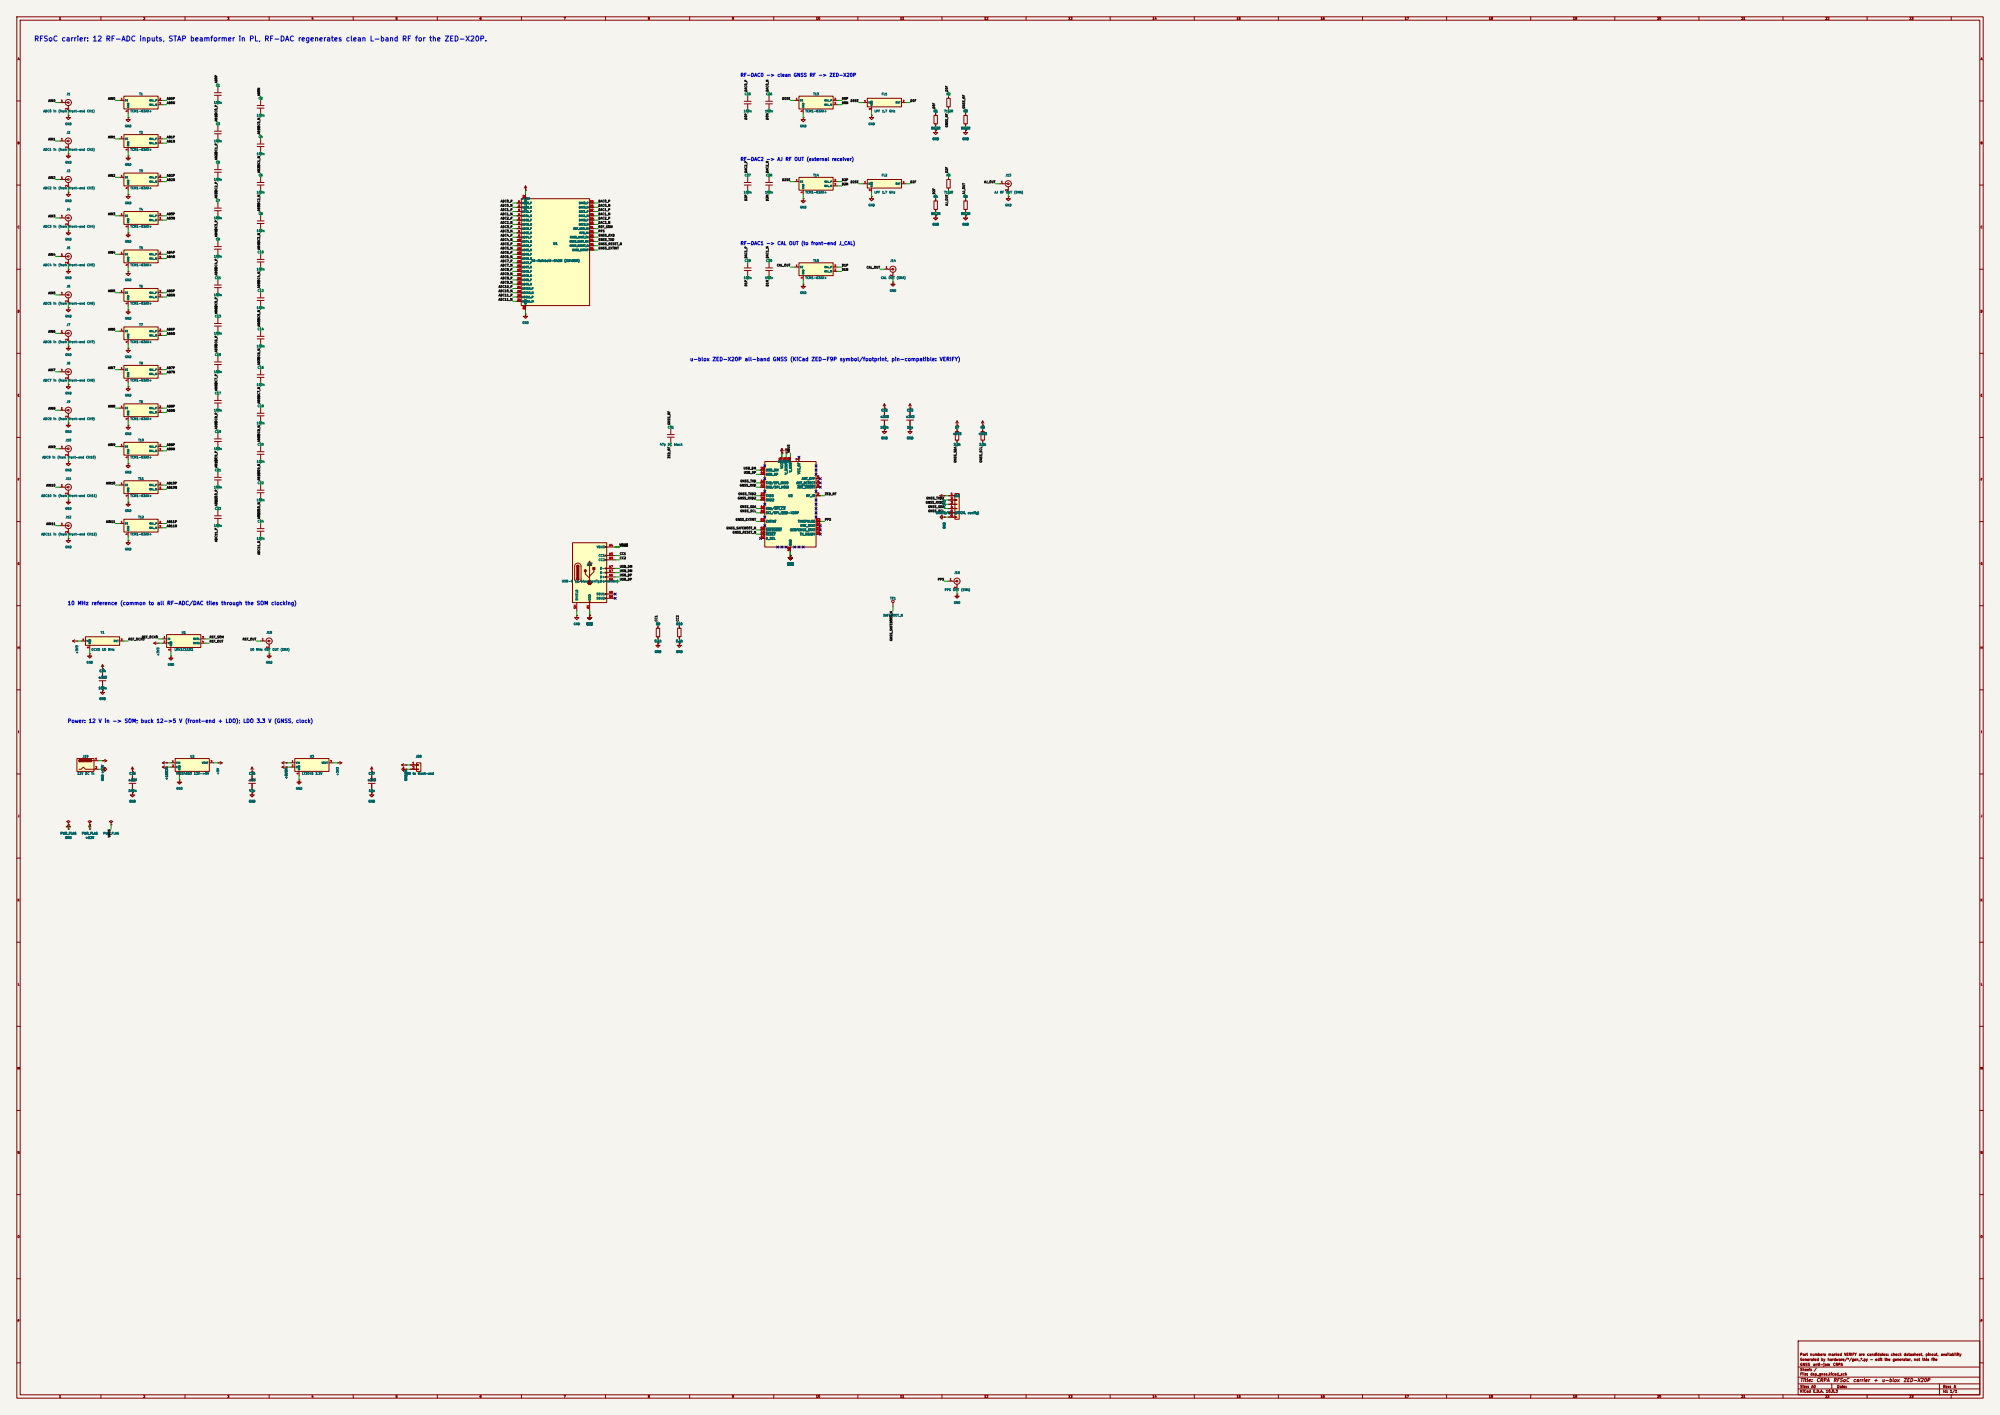
[picture p48: page 1]

RFSoC carrier: 12 RF-ADC inputs, STAP beamformer in PL, RF-DAC regenerates clean L-band RF for the ZED-X20P.

RF-DAC0 -> clean GNSS RF -> ZED-X20P

RF-DAC2 -> AJ RF OUT (external receiver)

AJ RF OUT (SMA) GND

J14 CAL OUT (SMA) GND

u-blox ZED-X20P all-band GNSS (KiCad ZED-F9P symbol/footprint, pin-compatible: VERIFY)

J16 PPS OUT (SMA) GND

10 MHz reference (common to all RF-ADC/DAC tiles through the SOM clocking)

Power: 12 V in -> SOM; buck 12->5 V (front-end + LDO); LDO 3.3 V (GNSS, clock)

J20 +5V to front-end +5V GND

Part numbers marked VERIFY are candidates: check datasheet, pinout, availability
Generated by hardware/*/gen_*.py - edit the generator, not this file
GNSS anti-jam CRPA
Sheet: /
File: dsp_gnss.kicad_sch
Title: CRPA RFSoC carrier + u-blox ZED-X20P

Size: A0 | Rev: A
KiCad E.D.A. 10.0.3 | Id: 1/1
