ajisrawi/polarization-crpa/hardware/rf_frontend/rf_frontend.pdf

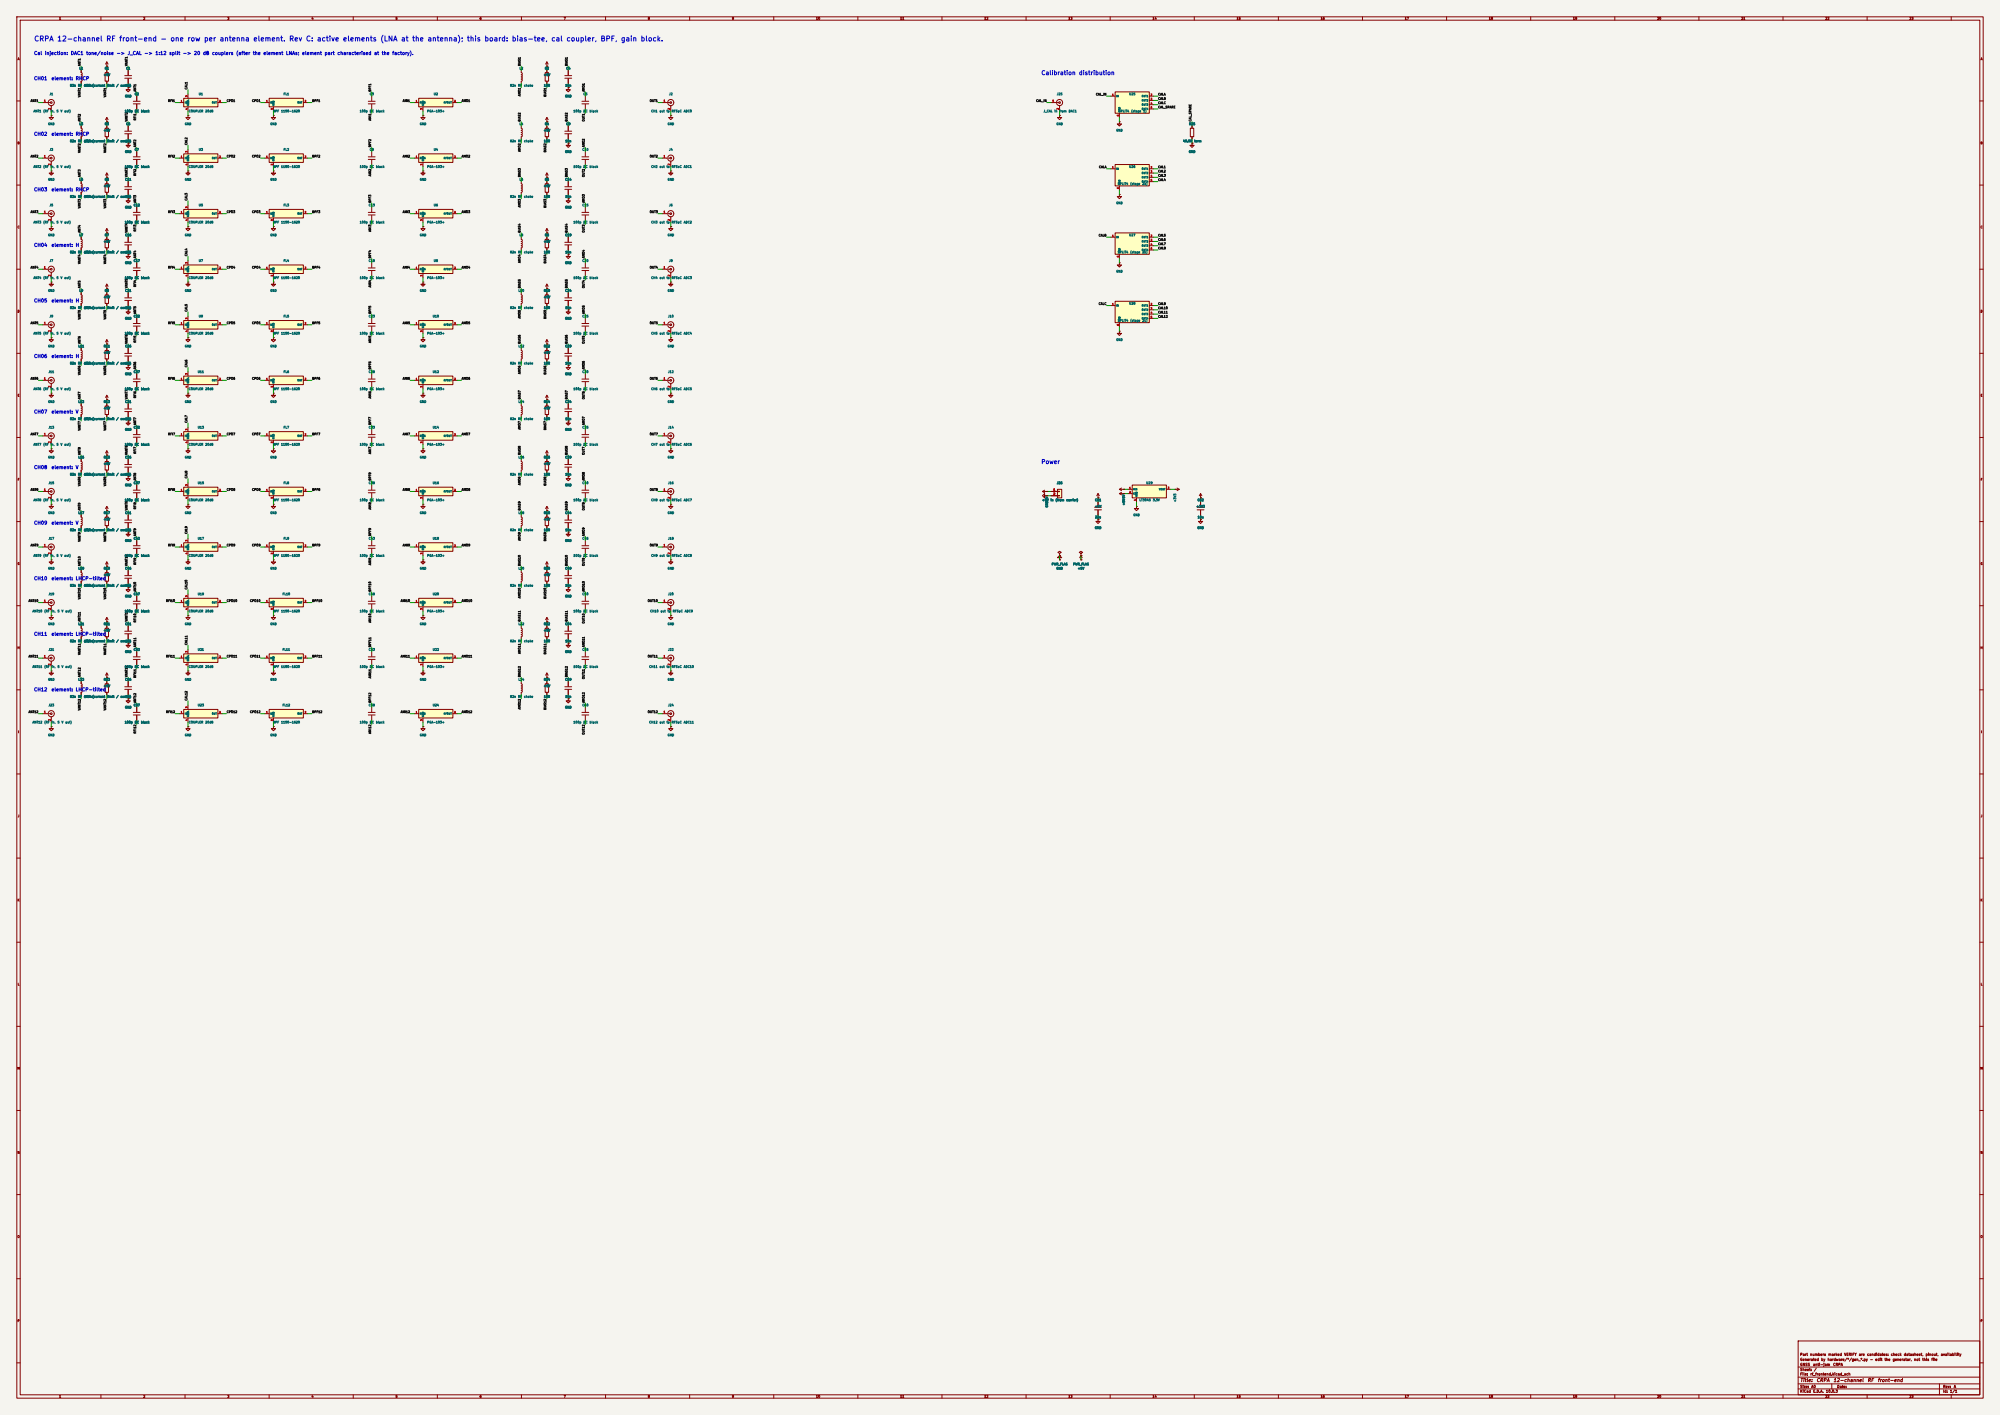
[picture p49: page 1]

CRPA 12-channel RF front-end - one row per antenna element. Rev C: active elements (LNA at the antenna); this board: bias-tee, cal coupler, BPF, gain block.

Cal injection: DAC1 tone/noise -> J_CAL -> 1:12 split -> 20 dB couplers (after the element LNAs; element part characterised at the factory).

Part numbers marked VERIFY are candidates: check datasheet, pinout, availability
Generated by hardware/*/gen_*.py - edit the generator, not this file
GNSS anti-jam CRPA
Sheet: /
File: rf_frontend.kicad_sch
Title: CRPA 12-channel RF front-end

Size: A0 | Rev: A
KiCad E.D.A. 10.0.3 | Id: 1/1
