ajisrawi/polarization-crpa/hardware/antenna/feed_linear_120/feed_linear_120.kicad_pcb

## KiCad design hardware/antenna/feed_linear_120/feed_linear_120.kicad_pcb (2026-10-11)

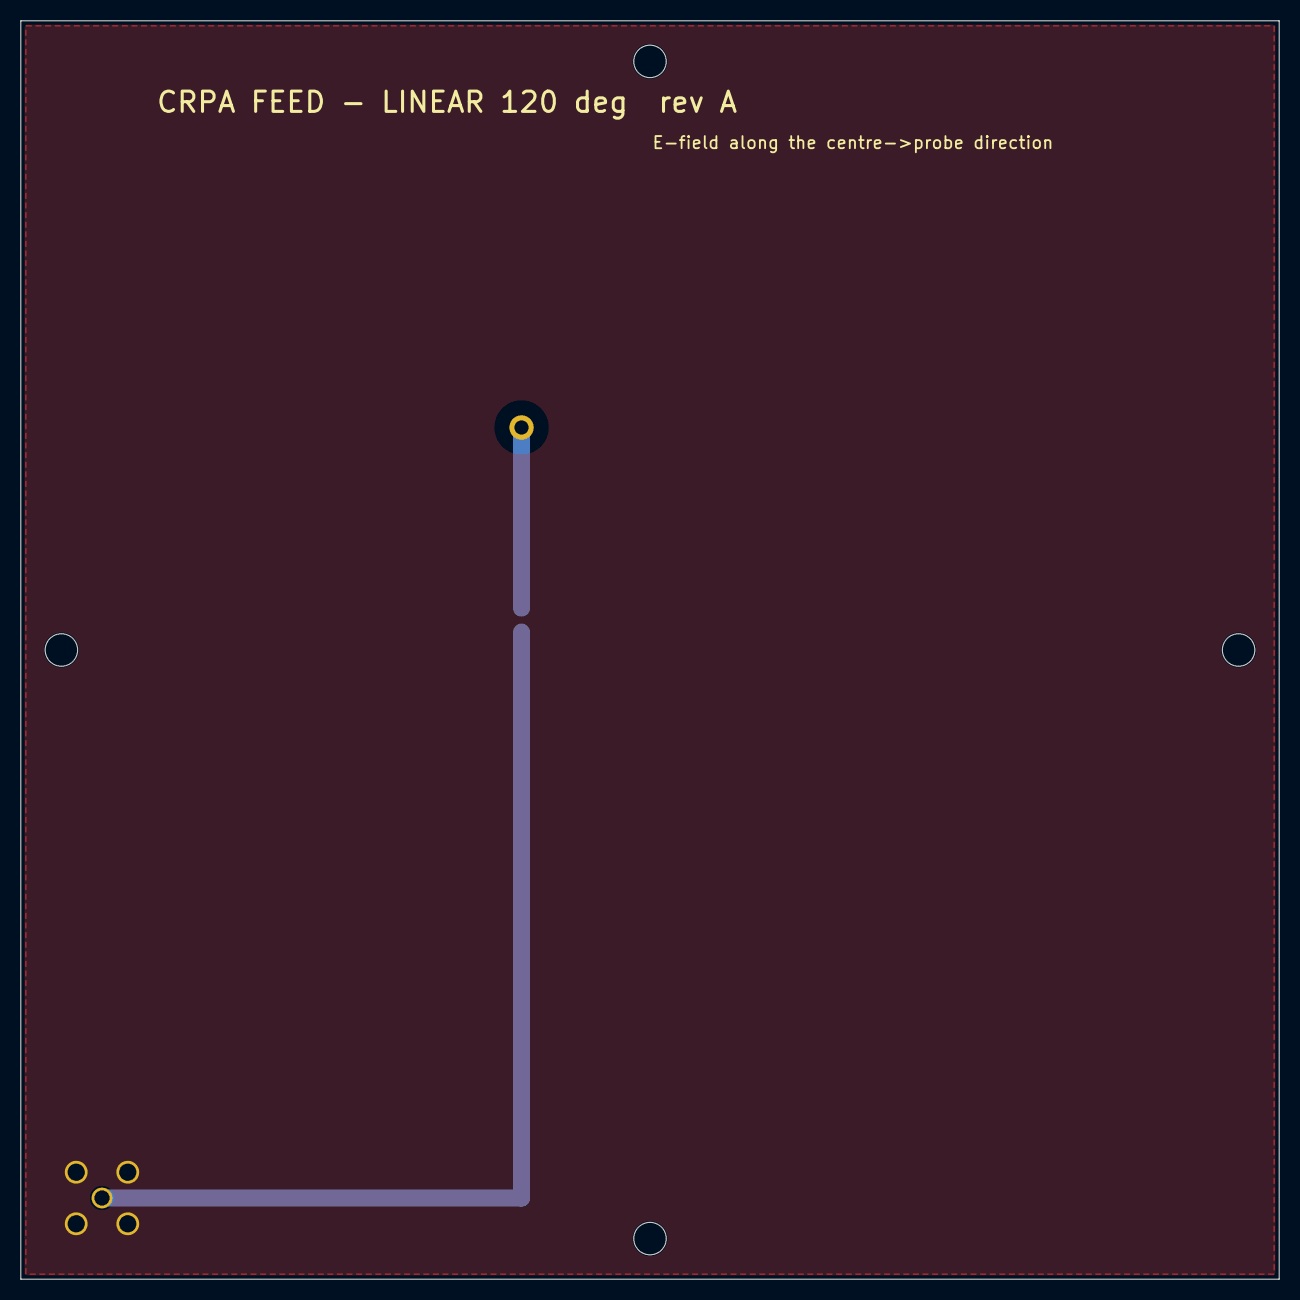
[picture p50: board feed_linear_120.kicad_pcb from above]

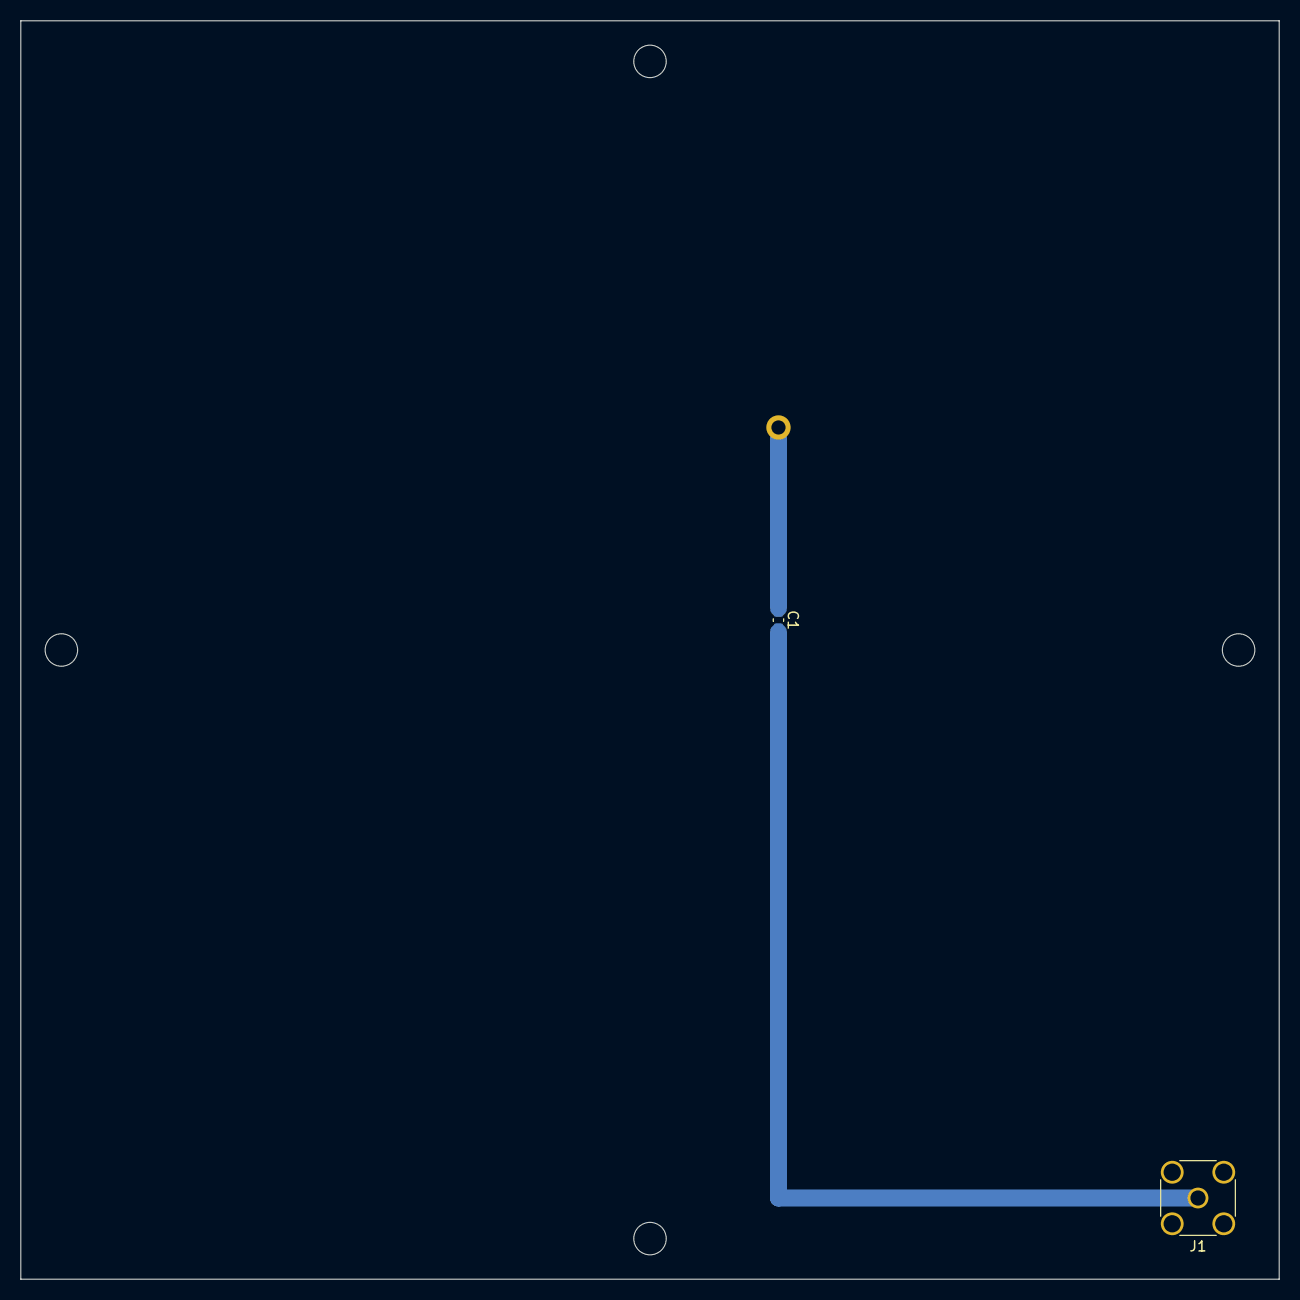
[picture p51: board feed_linear_120.kicad_pcb from below]

Board: 2 copper layers, 124.0 x 124.0 mm, 7 parts (2 on the bottom side), 2 nets.

Parts:
C1: 0R / ~2.2pF probe tune; C_0603_1608Metric
H1, H2, H3, H4: M3 nylon standoff; MountingHole_3.2mm_M3
J1: SMA vertical (Amphenol 132134); SMA_Amphenol_132134_Vertical
P1: probe

Connections:
PROBE: C1.1, P1.1
RF_OUT: C1.2, J1.1
