ajisrawi/polarization-crpa/hardware/antenna/feed_circular/feed_circular.kicad_pcb

## KiCad design hardware/antenna/feed_circular/feed_circular.kicad_pcb (2026-10-11)

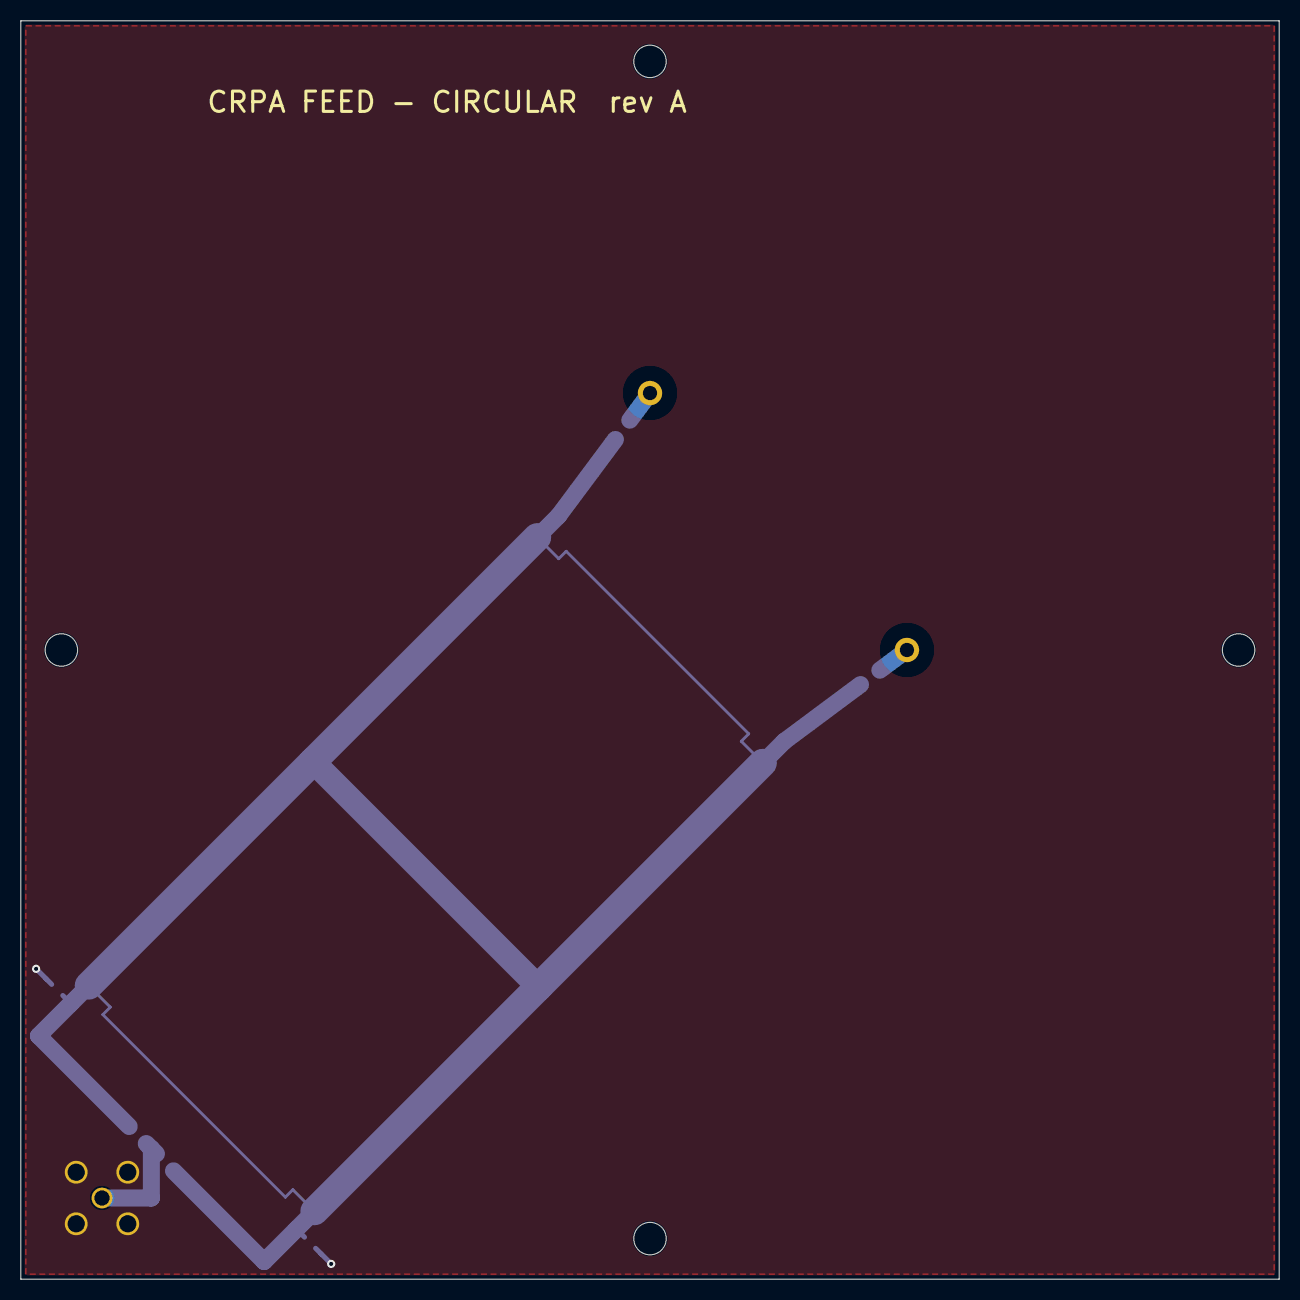
[picture p52: board hardware/antenna/feed_circular/feed_circular.kicad_pcb from above]

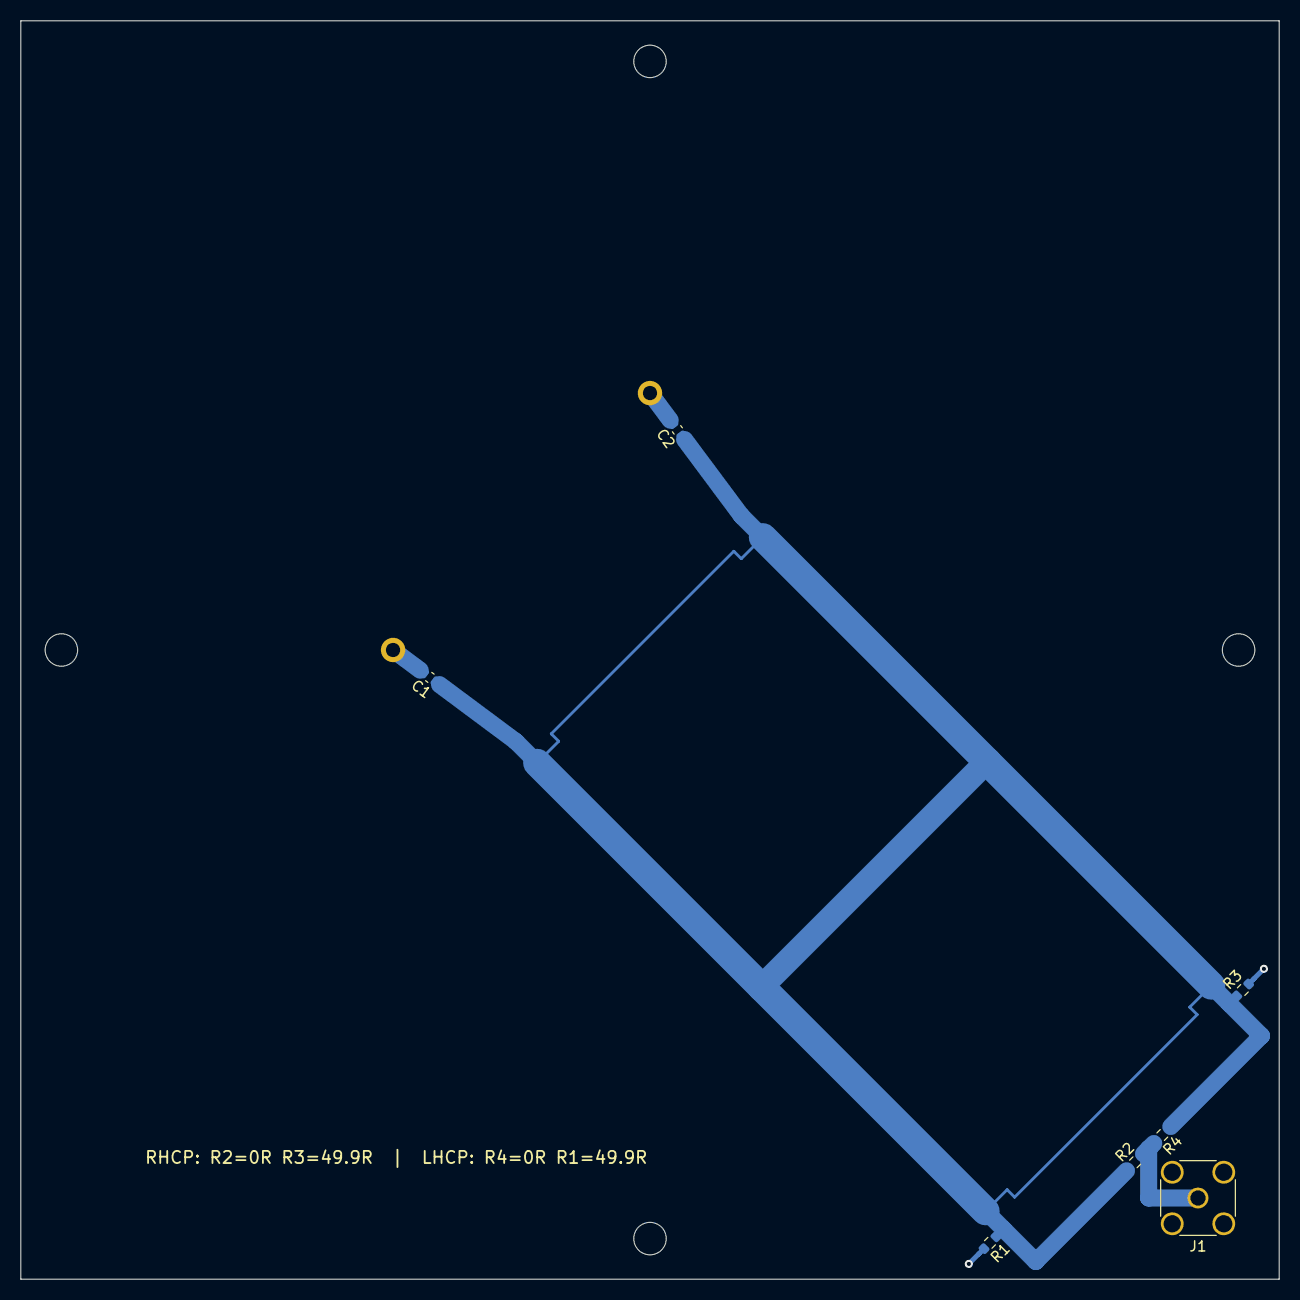
[picture p53: board hardware/antenna/feed_circular/feed_circular.kicad_pcb from below]

Board: 2 copper layers, 124.0 x 124.0 mm, 13 parts (7 on the bottom side), 5 nets.

Parts:
C1, C2: 0R / ~2.2pF probe tune; C_0603_1608Metric
H1, H2, H3, H4: M3 nylon standoff; MountingHole_3.2mm_M3
J1: SMA vertical (Amphenol 132134); SMA_Amphenol_132134_Vertical
P1, P2: probe
R1: 49.9R if RHCP not used, else DNP; R_0603_1608Metric
R2: 0R for RHCP, else DNP; R_0603_1608Metric
R3: 49.9R if LHCP not used, else DNP; R_0603_1608Metric
R4: 0R for LHCP, else DNP; R_0603_1608Metric

Connections:
GND: J1.2, R1.2, R3.2
HYB_T: C1.1, C2.1, R1.1, R2.1, R3.1, R4.1
PROBE_X: C1.2, P1.1
PROBE_Y: C2.2, P2.1
RF_OUT: J1.1, R2.2, R4.2
