ajisrawi/polarization-crpa/hardware/antenna_tmm/feed_circular/feed_circular.kicad_pcb

## KiCad design hardware/antenna_tmm/feed_circular/feed_circular.kicad_pcb (2026-10-11)

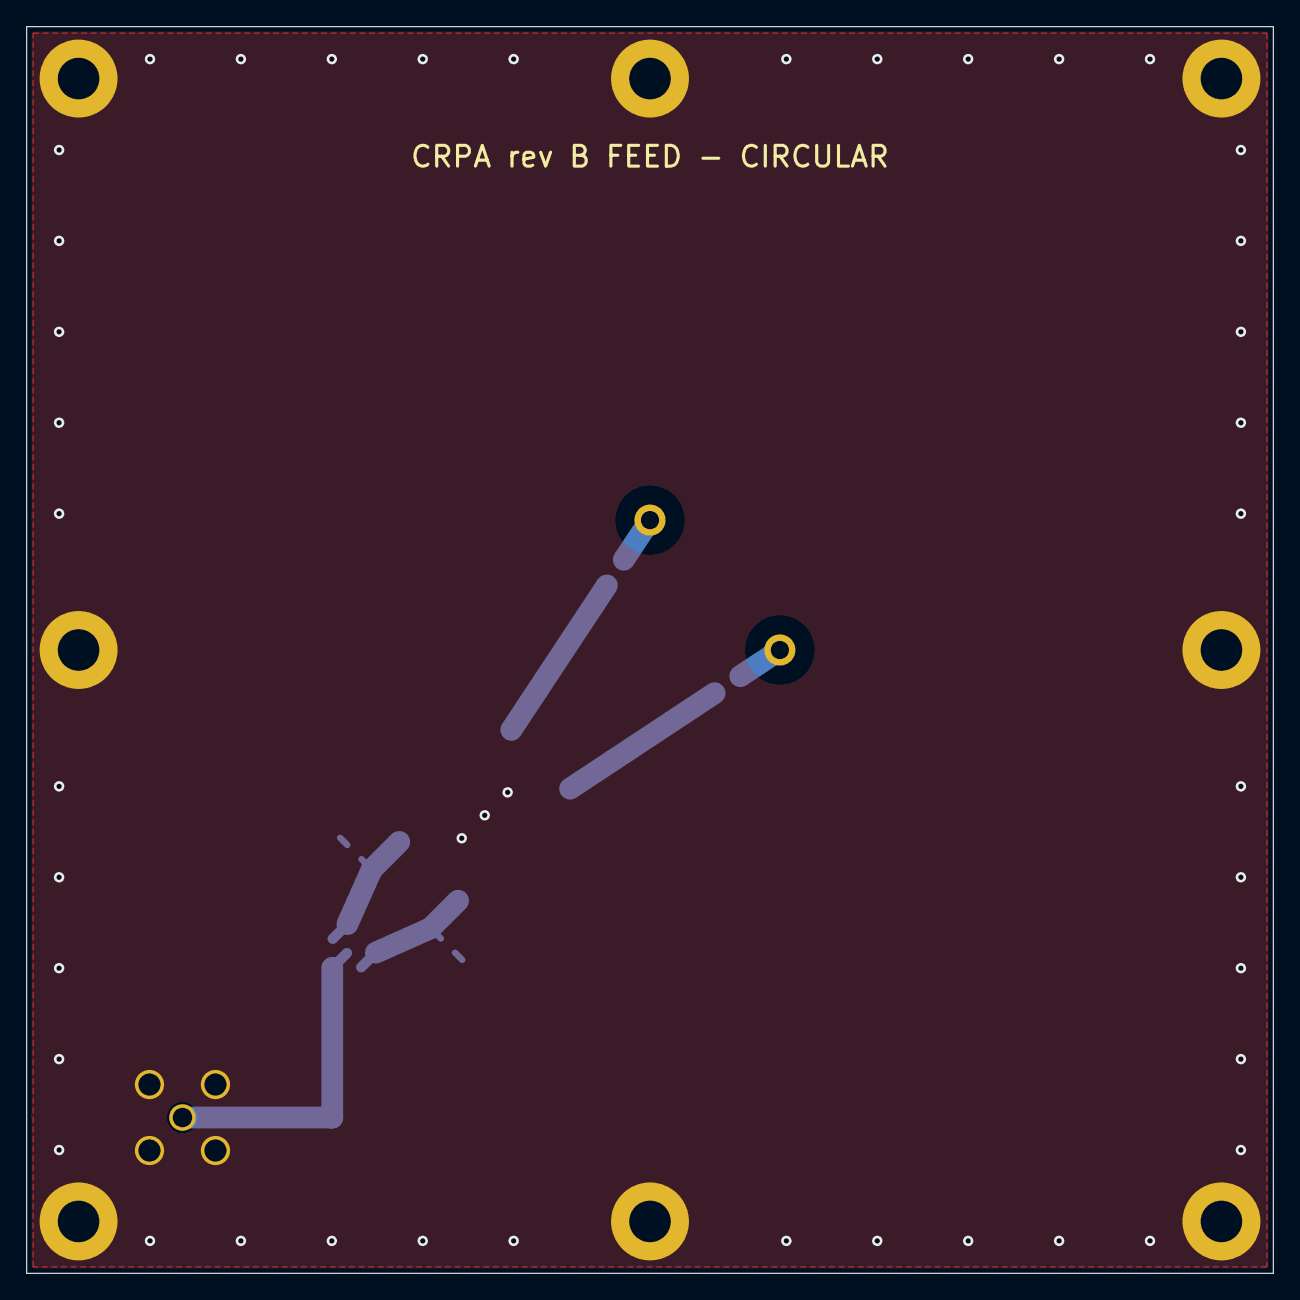
[picture p54: board hardware/antenna_tmm/feed_circular/feed_circular.kicad_pcb from above]

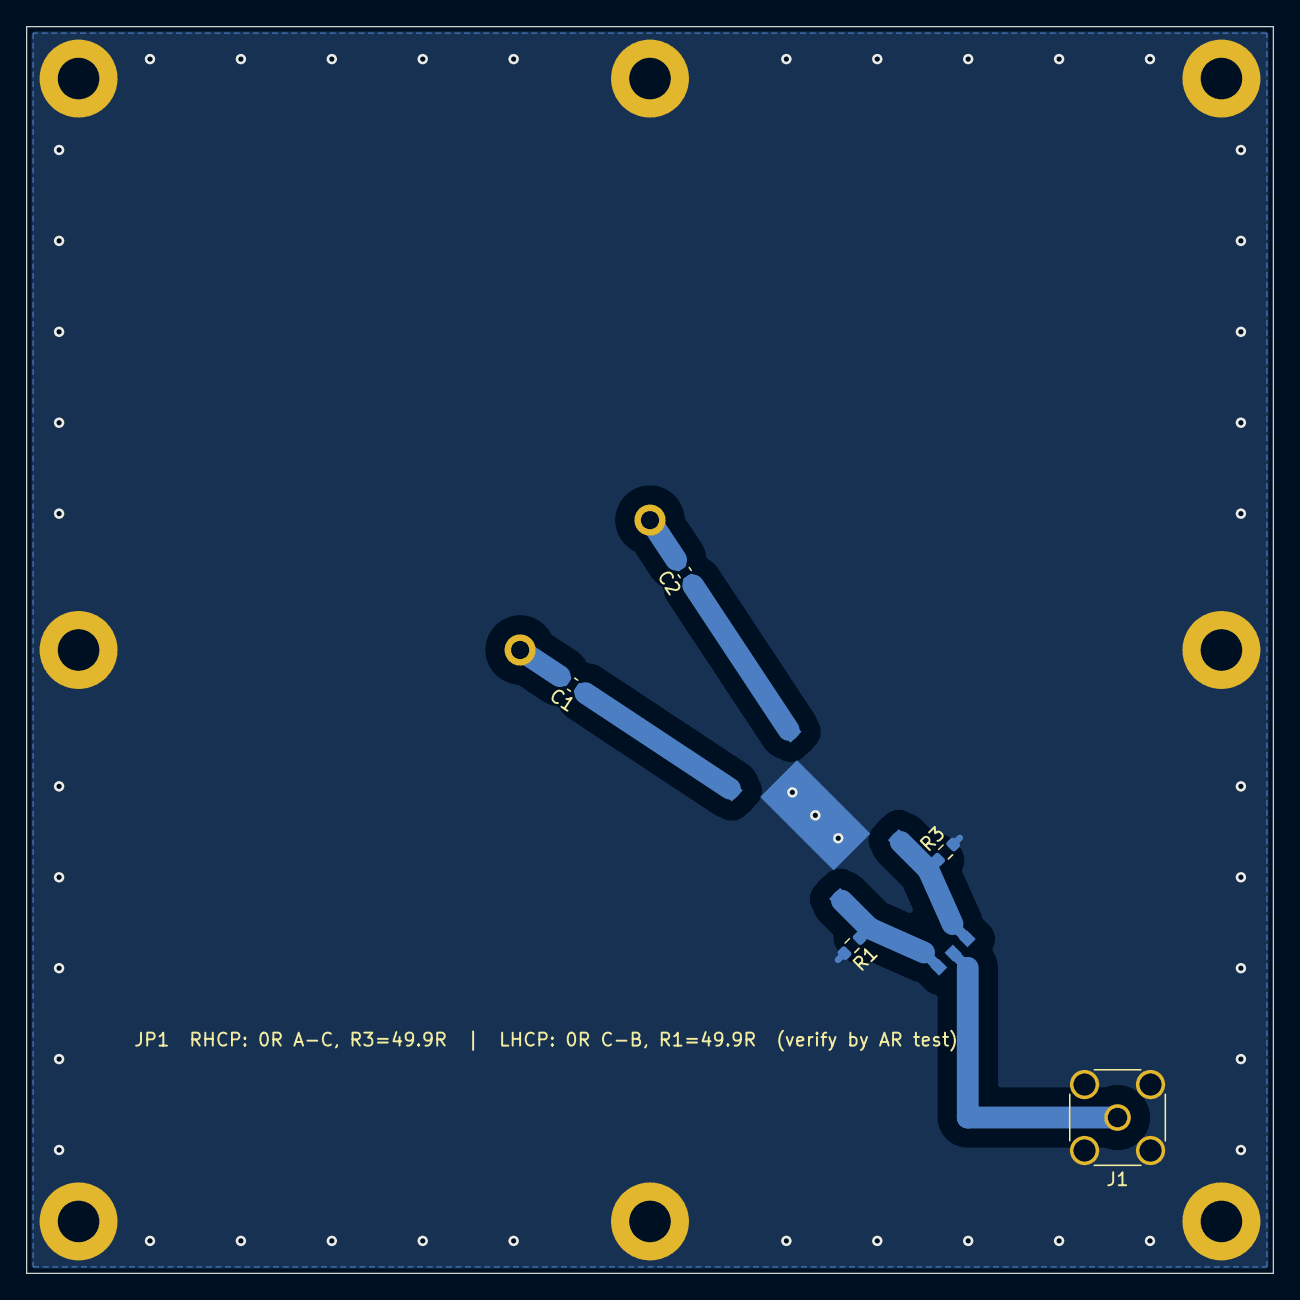
[picture p55: board hardware/antenna_tmm/feed_circular/feed_circular.kicad_pcb from below]

Board: 2 copper layers, 96.0 x 96.0 mm, 17 parts (7 on the bottom side), 8 nets.

Parts:
C1, C2: 0R (disk feed) / tune; C_0603_1608Metric
H1, H2, H3, H4, H5, H6, H7, H8: M3 plated hole for brass standoff to plate
J1: SMA vertical (Amphenol 132134); SMA_Amphenol_132134_Vertical
JP1: polarization select: 0R on A-C or C-B
P1, P2: probe
R1: 49.9R if RHCP not used, else DNP; R_0603_1608Metric
R3: 49.9R if LHCP not used, else DNP; R_0603_1608Metric
U1: Q3XG-1500R 90deg hybrid - LAND PATTERN PLACEHOLDE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

Connections:
GND: H1.1, H2.1, H3.1, H4.1, H5.1, H6.1, H7.1, H8.1, J1.2, R1.2, R3.2, U1.5
HYB1: JP1.B, R1.1, U1.1
HYB2: C1.1, U1.2
HYB3: C2.1, U1.3
HYB4: JP1.A, R3.1, U1.4
PROBE_P1: C1.2, P1.1
PROBE_P2: C2.2, P2.1
RF_OUT: J1.1, JP1.C
