ajisrawi/polarization-crpa/hardware/dsp_gnss/dsp_gnss.kicad_sch

## KiCad design hardware/dsp_gnss/dsp_gnss.kicad_sch (2026-10-11)

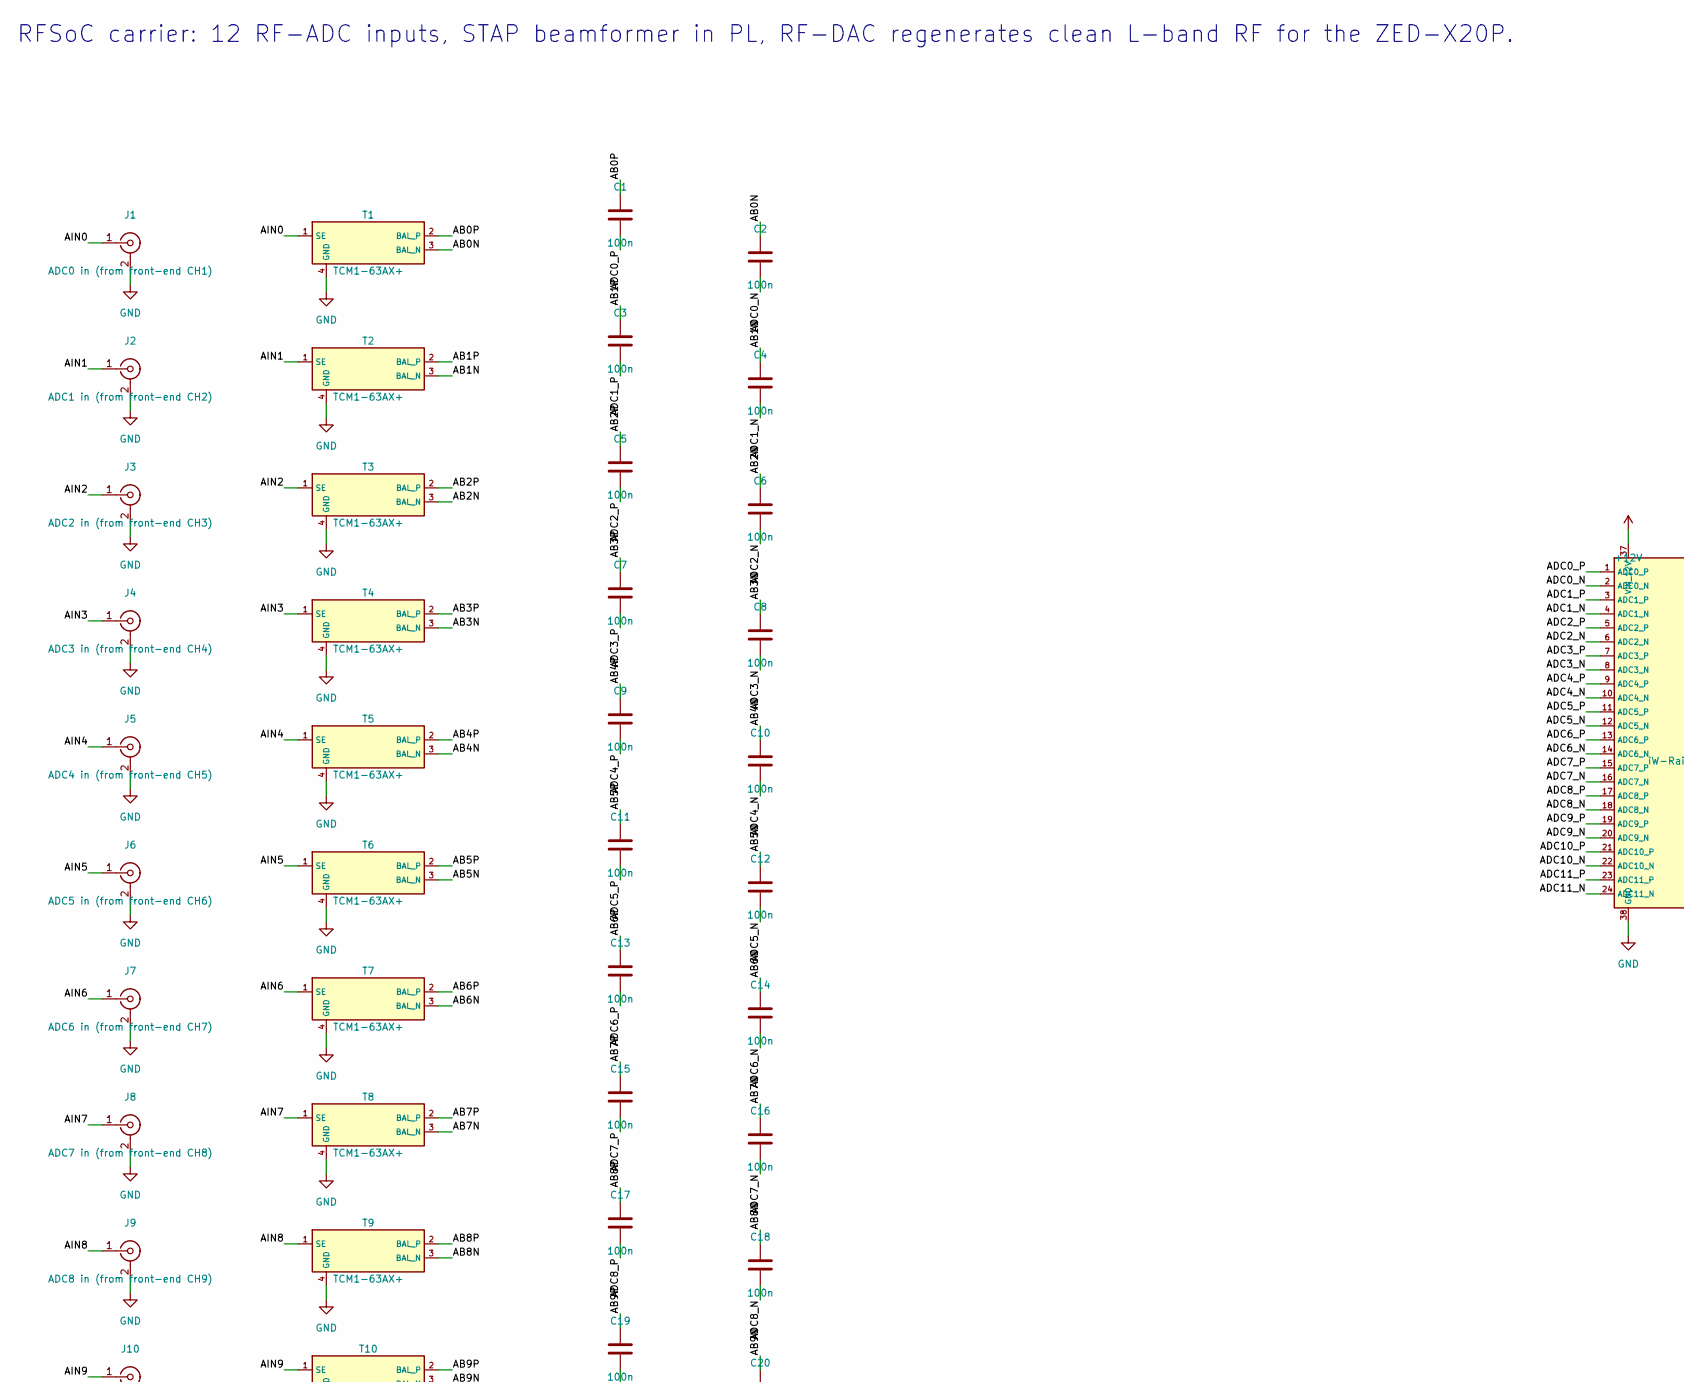
[picture p56: schematic dsp_gnss.kicad_sch, part in row 1, column 1]

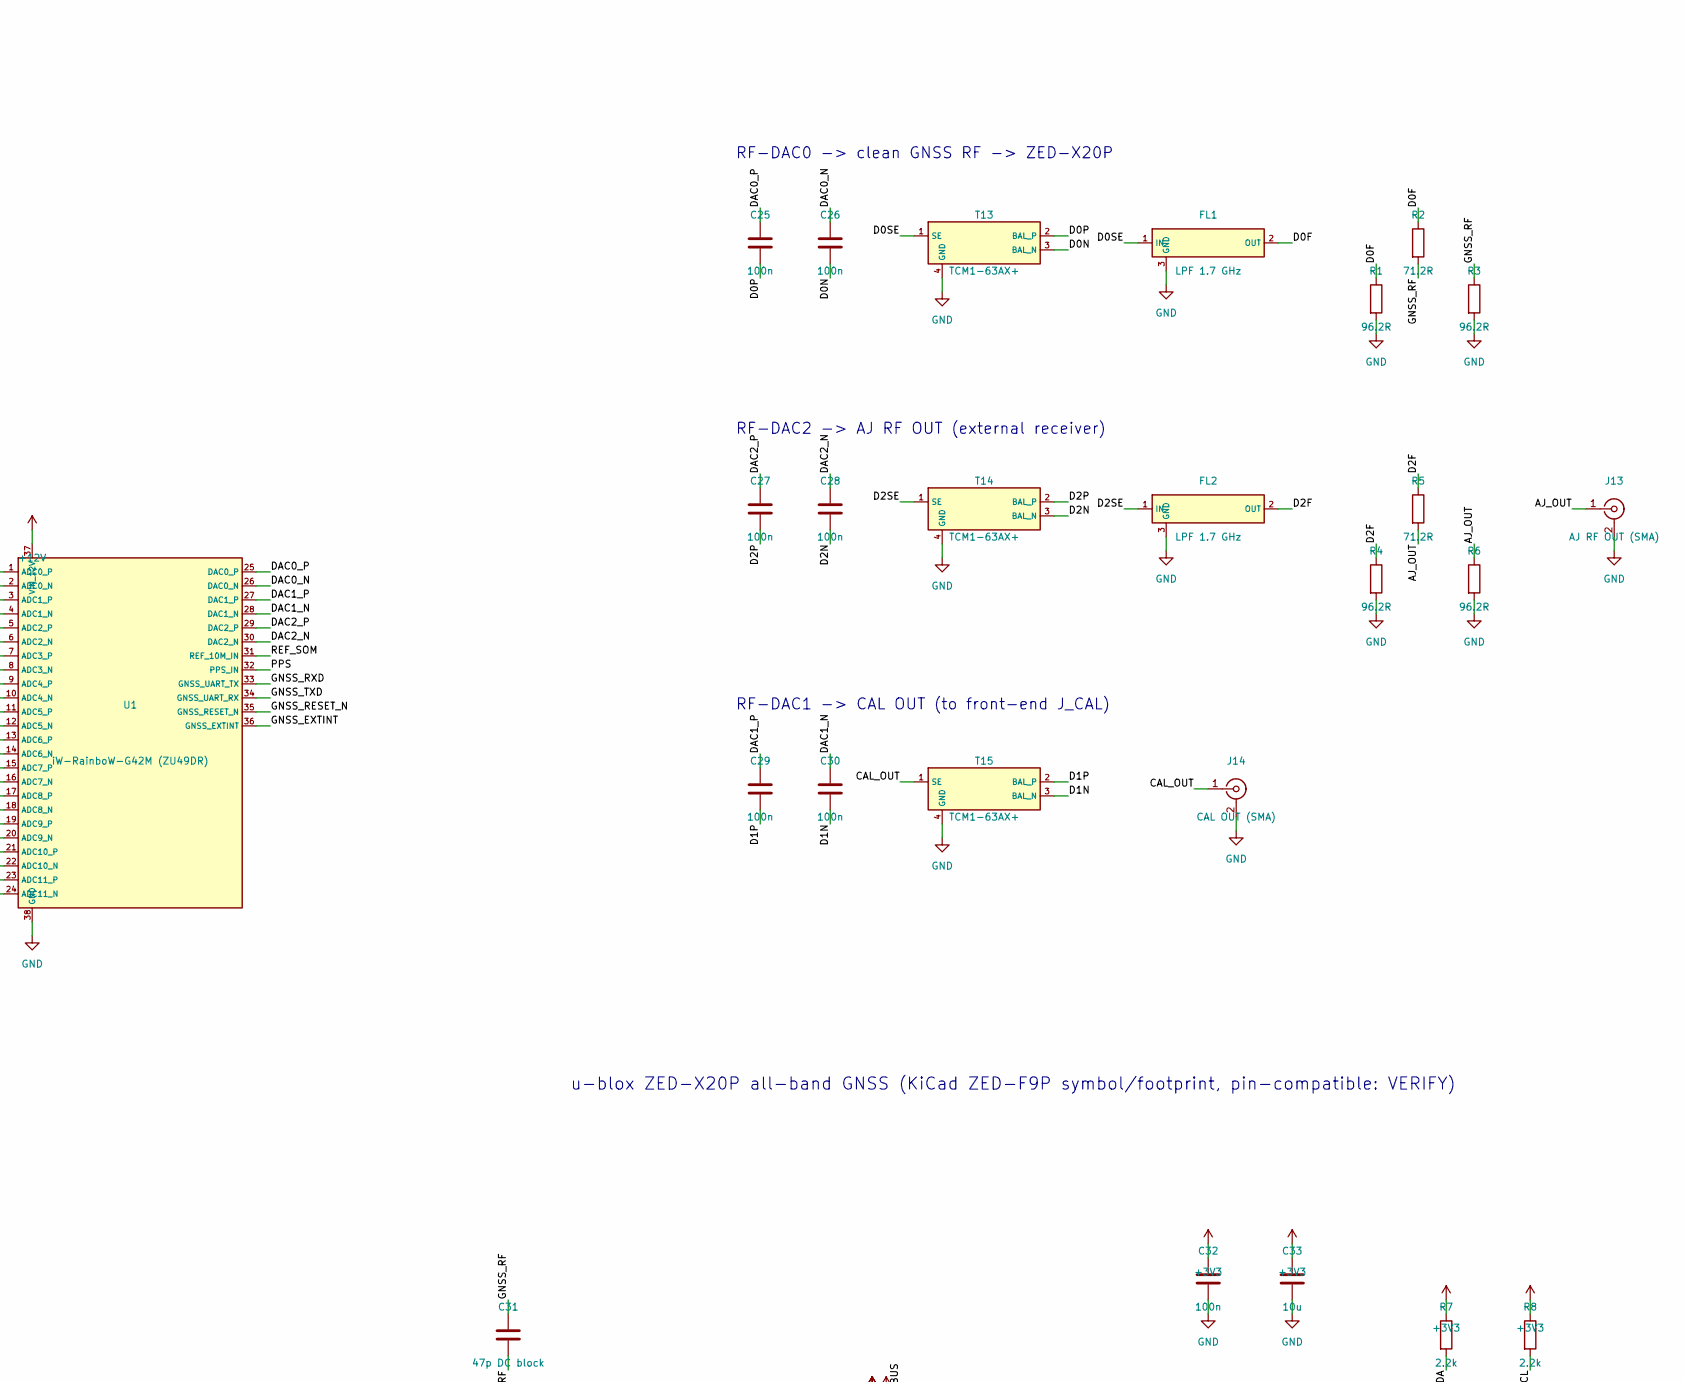
[picture p57: schematic dsp_gnss.kicad_sch, part in row 1, column 2]

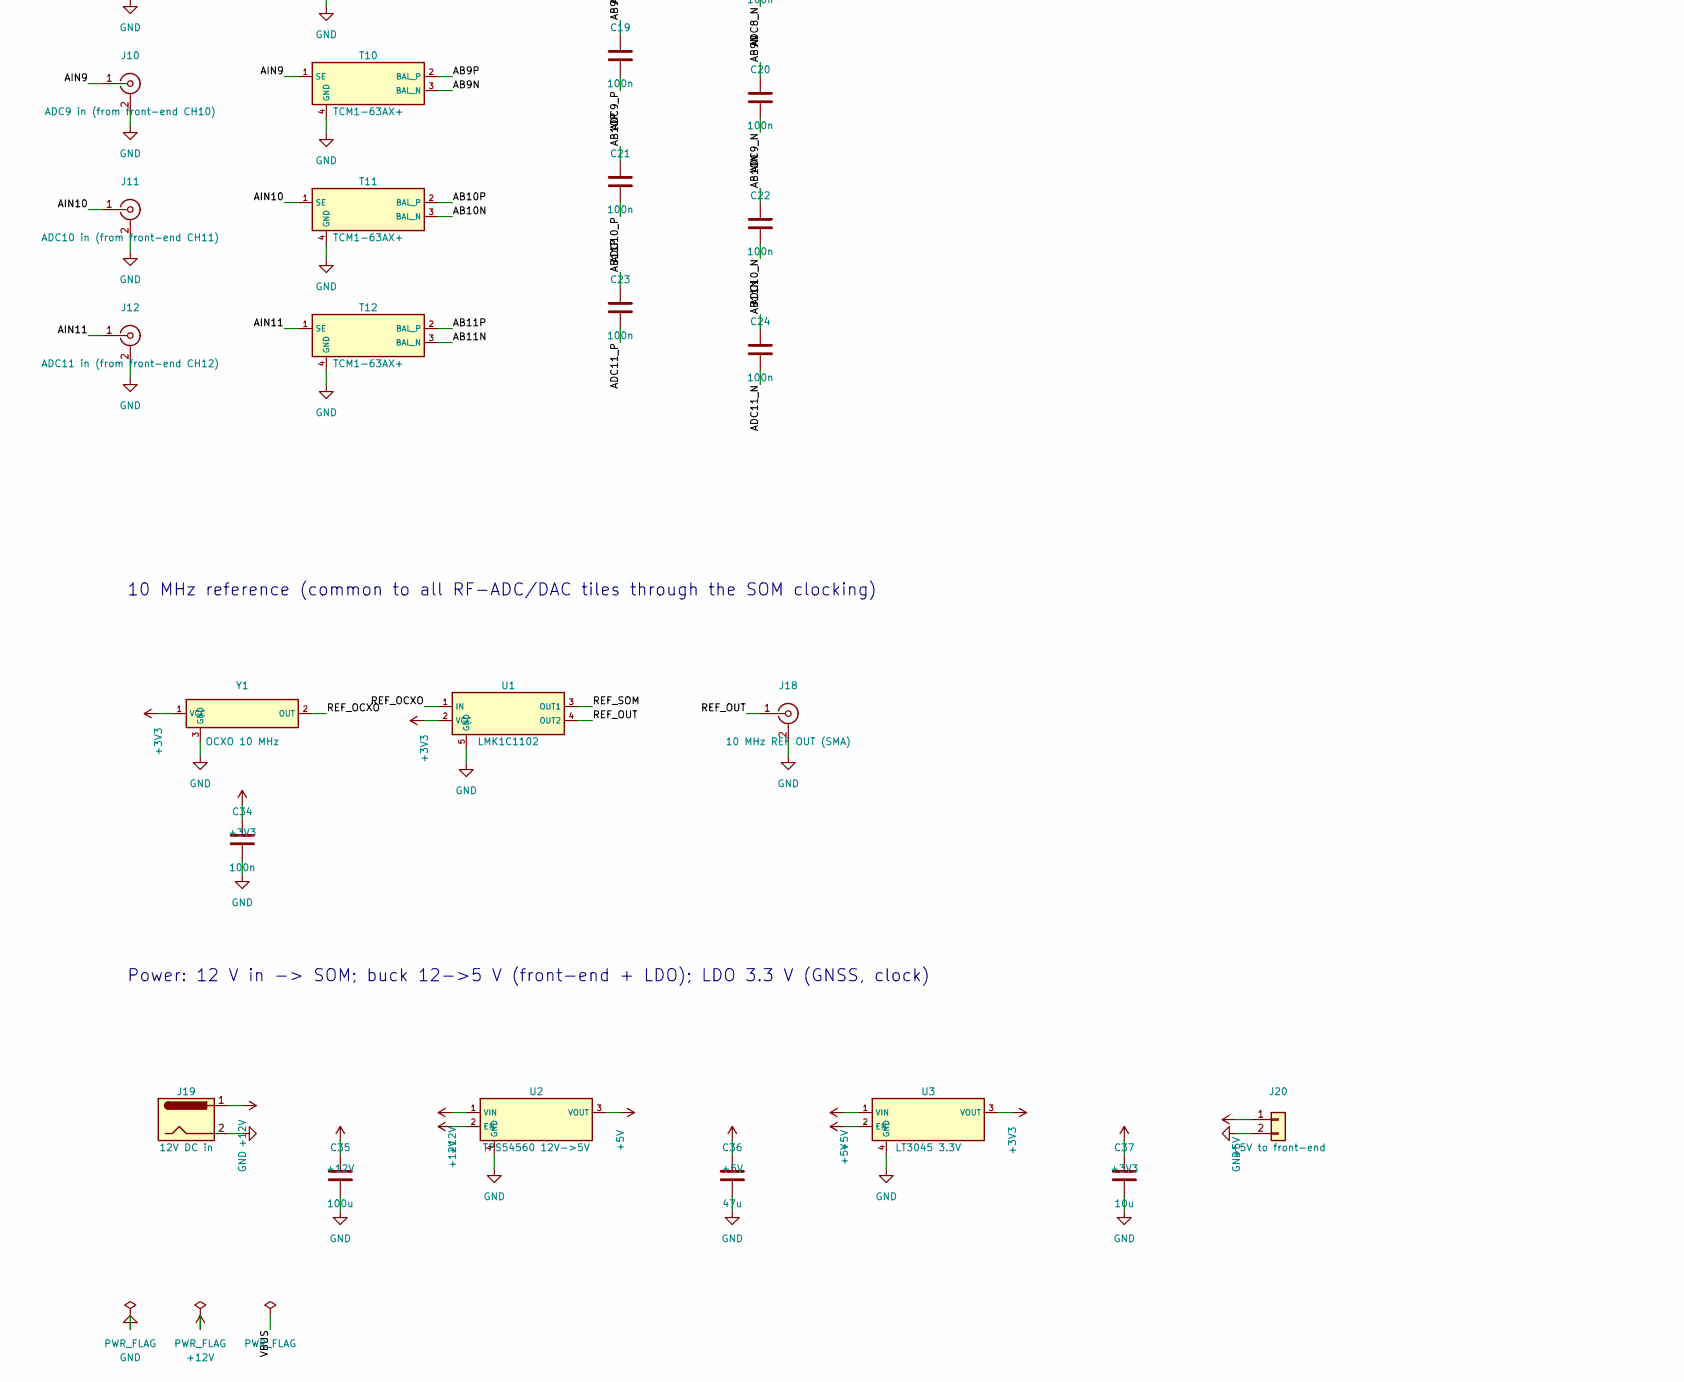
[picture p58: schematic dsp_gnss.kicad_sch, part in row 2, column 1]

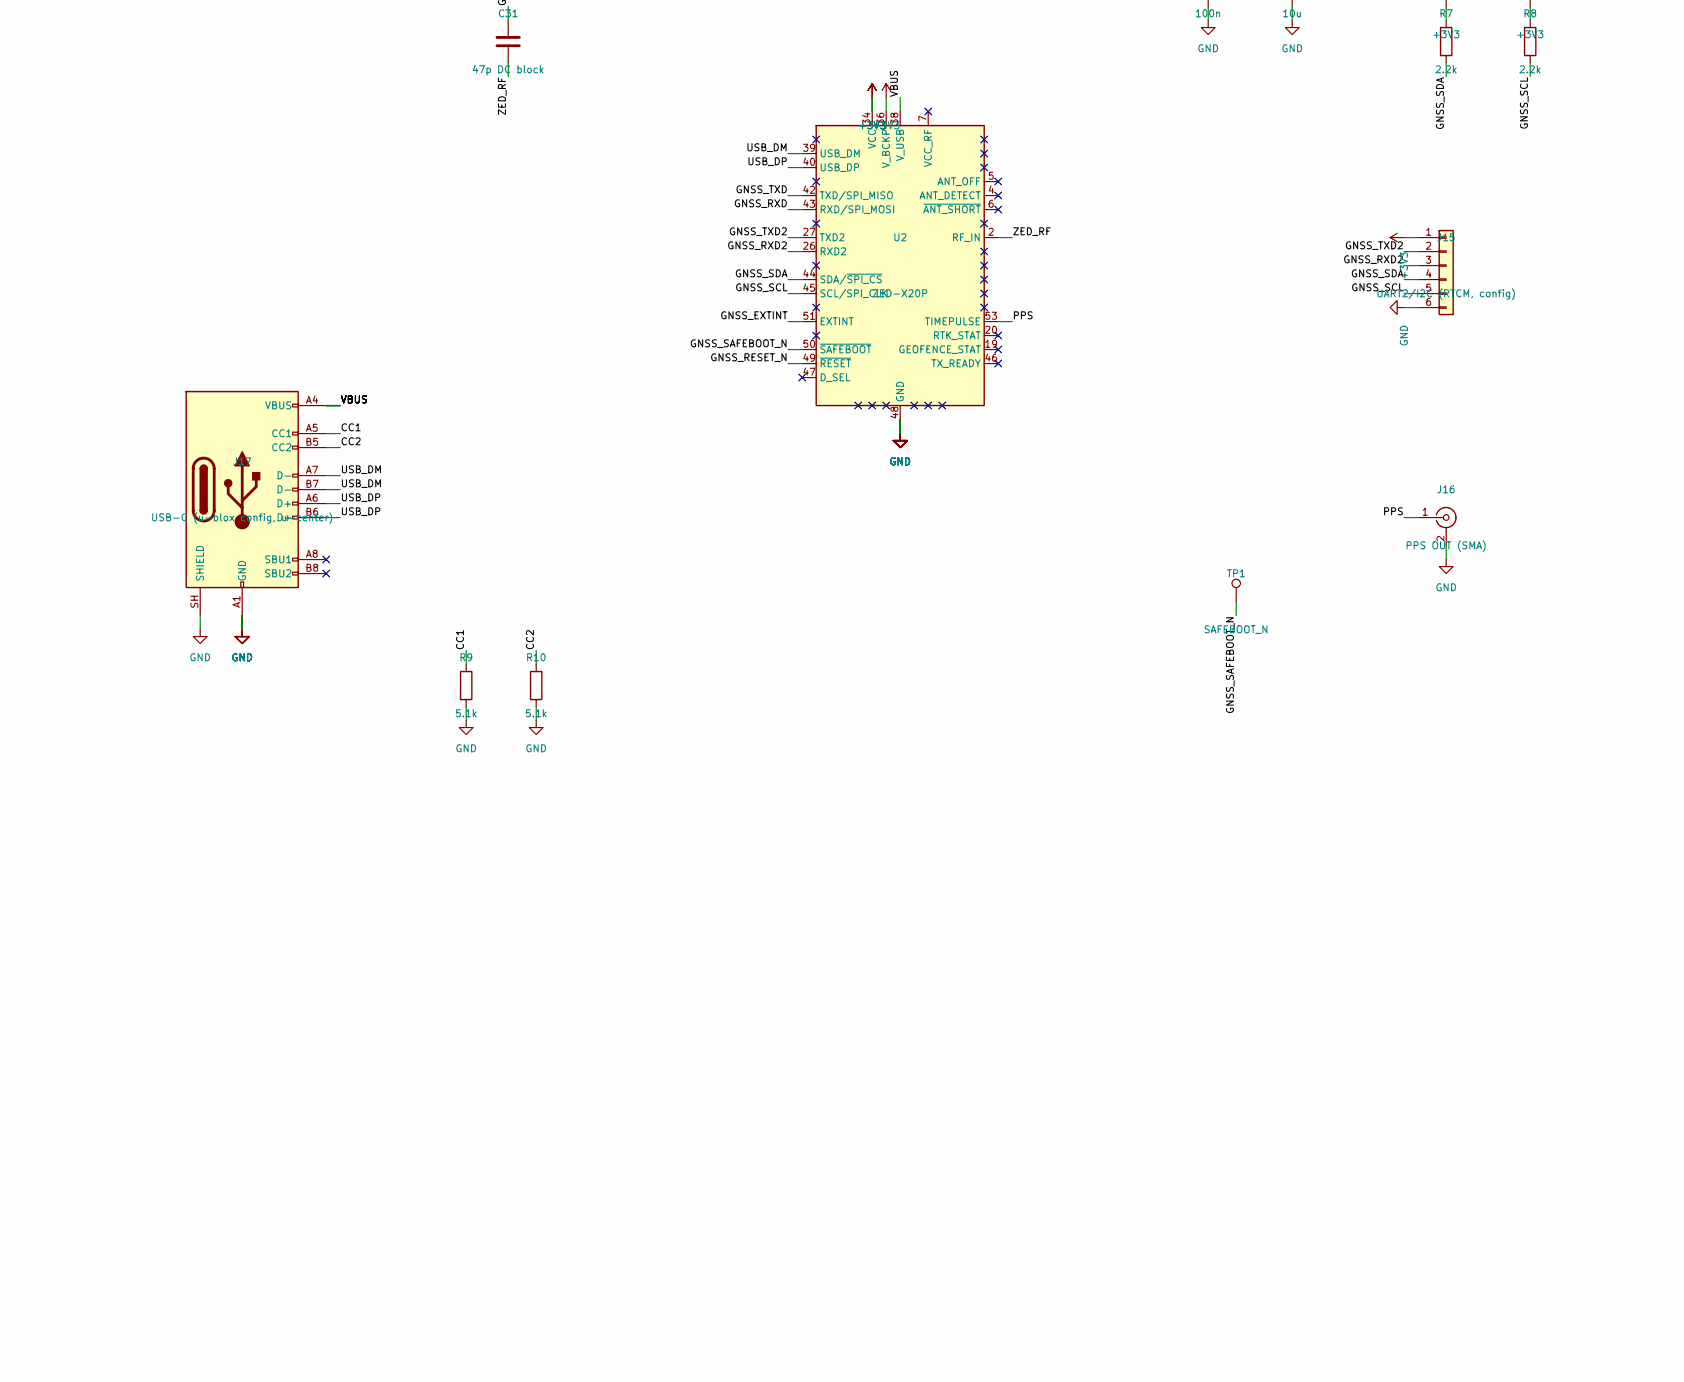
[picture p59: schematic dsp_gnss.kicad_sch, part in row 2, column 2]

Parts:
C1, C2, C3, C4, C5, C6, C7, C8, C9, C10, C11, C12, C13, C14, C15, C16, C17, C18, C19, C20, C21, C22, C23, C24, C25, C26, C27, C28, C29, C30, C32, C34: 100n
C31: 47p DC block
C33, C37: 10u
C35: 100u
C36: 47u
FL1, FL2: LPF 1.7 GHz
J1: ADC0 in (from front-end CH1)
J2: ADC1 in (from front-end CH2)
J3: ADC2 in (from front-end CH3)
J4: ADC3 in (from front-end CH4)
J5: ADC4 in (from front-end CH5)
J6: ADC5 in (from front-end CH6)
J7: ADC6 in (from front-end CH7)
J8: ADC7 in (from front-end CH8)
J9: ADC8 in (from front-end CH9)
J10: ADC9 in (from front-end CH10)
J11: ADC10 in (from front-end CH11)
J12: ADC11 in (from front-end CH12)
J13: AJ RF OUT (SMA)
J14: CAL OUT (SMA)
J15: UART2/I2C (RTCM, config)
J16: PPS OUT (SMA)
J17: USB-C (u-blox config, u-center)
J18: 10 MHz REF OUT (SMA)
J19: 12V DC in
J20: +5V to front-end
R1, R3, R4, R6: 96.2R
R2, R5: 71.2R
R7, R8: 2.2k
R9, R10: 5.1k
T1, T2, T3, T4, T5, T6, T7, T8, T9, T10, T11, T12, T13, T14, T15: TCM1-63AX+
TP1: SAFEBOOT_N
U1: iW-RainboW-G42M (ZU49DR)
U2: ZED-X20P; ublox_ZED
U3: LT3045 3.3V
Y1: OCXO 10 MHz

Connections:
+3V3: C32.1, C33.1, C34.1, C37.1, J15.1, R7.1, R8.1, U1.2 (VCC), U2.33 (VCC), U2.34 (VCC), U2.36 (V_BCKP), U3.3 (VOUT), Y1.1 (VCC)
+5V: C36.1, J20.1, U2.3 (VOUT), U3.1 (VIN), U3.2 (EN)
+12V: C35.1, J19.1, U1.37 (VIN_12V), U2.1 (VIN), U2.2 (EN)
AB0N: C2.1, T1.3 (BAL_N)
AB0P: C1.1, T1.2 (BAL_P)
AB1N: C4.1, T2.3 (BAL_N)
AB1P: C3.1, T2.2 (BAL_P)
AB2N: C6.1, T3.3 (BAL_N)
AB2P: C5.1, T3.2 (BAL_P)
AB3N: C8.1, T4.3 (BAL_N)
AB3P: C7.1, T4.2 (BAL_P)
AB4N: C10.1, T5.3 (BAL_N)
AB4P: C9.1, T5.2 (BAL_P)
AB5N: C12.1, T6.3 (BAL_N)
AB5P: C11.1, T6.2 (BAL_P)
AB6N: C14.1, T7.3 (BAL_N)
AB6P: C13.1, T7.2 (BAL_P)
AB7N: C16.1, T8.3 (BAL_N)
AB7P: C15.1, T8.2 (BAL_P)
AB8N: C18.1, T9.3 (BAL_N)
AB8P: C17.1, T9.2 (BAL_P)
AB9N: C20.1, T10.3 (BAL_N)
AB9P: C19.1, T10.2 (BAL_P)
AB10N: C22.1, T11.3 (BAL_N)
AB10P: C21.1, T11.2 (BAL_P)
AB11N: C24.1, T12.3 (BAL_N)
AB11P: C23.1, T12.2 (BAL_P)
ADC0_N: C2.2, U1.2 (VCC)
ADC0_P: C1.2, U1.1 (IN)
ADC1_N: C4.2, U1.4 (OUT2)
ADC1_P: C3.2, U1.3 (OUT1)
ADC2_N: C6.2, U1.6 (ADC2_N)
ADC2_P: C5.2, U1.5 (GND)
ADC3_N: C8.2, U1.8 (ADC3_N)
ADC3_P: C7.2, U1.7 (ADC3_P)
ADC4_N: C10.2, U1.10 (ADC4_N)
ADC4_P: C9.2, U1.9 (ADC4_P)
ADC5_N: C12.2, U1.12 (ADC5_N)
ADC5_P: C11.2, U1.11 (ADC5_P)
ADC6_N: C14.2, U1.14 (ADC6_N)
ADC6_P: C13.2, U1.13 (ADC6_P)
ADC7_N: C16.2, U1.16 (ADC7_N)
ADC7_P: C15.2, U1.15 (ADC7_P)
ADC8_N: C18.2, U1.18 (ADC8_N)
ADC8_P: C17.2, U1.17 (ADC8_P)
ADC9_N: C20.2, U1.20 (ADC9_N)
ADC9_P: C19.2, U1.19 (ADC9_P)
ADC10_N: C22.2, U1.22 (ADC10_N)
ADC10_P: C21.2, U1.21 (ADC10_P)
ADC11_N: C24.2, U1.24 (ADC11_N)
ADC11_P: C23.2, U1.23 (ADC11_P)
AIN0: J1.1 (In), T1.1 (SE)
AIN1: J2.1 (In), T2.1 (SE)
AIN2: J3.1 (In), T3.1 (SE)
AIN3: J4.1 (In), T4.1 (SE)
AIN4: J5.1 (In), T5.1 (SE)
AIN5: J6.1 (In), T6.1 (SE)
AIN6: J7.1 (In), T7.1 (SE)
AIN7: J8.1 (In), T8.1 (SE)
AIN8: J9.1 (In), T9.1 (SE)
AIN9: J10.1 (In), T10.1 (SE)
AIN10: J11.1 (In), T11.1 (SE)
AIN11: J12.1 (In), T12.1 (SE)
AJ_OUT: J13.1 (In), R5.2, R6.1
CAL_OUT: J14.1 (In), T15.1 (SE)
CC1: J17.A5 (CC1), R9.1
CC2: J17.B5 (CC2), R10.1
D0F: FL1.2 (OUT), R1.1, R2.1
D0N: C26.2, T13.3 (BAL_N)
D0P: C25.2, T13.2 (BAL_P)
D0SE: FL1.1 (IN), T13.1 (SE)
D1N: C30.2, T15.3 (BAL_N)
D1P: C29.2, T15.2 (BAL_P)
D2F: FL2.2 (OUT), R4.1, R5.1
D2N: C28.2, T14.3 (BAL_N)
D2P: C27.2, T14.2 (BAL_P)
D2SE: FL2.1 (IN), T14.1 (SE)
DAC0_N: C26.1, U1.26 (DAC0_N)
DAC0_P: C25.1, U1.25 (DAC0_P)
DAC1_N: C30.1, U1.28 (DAC1_N)
DAC1_P: C29.1, U1.27 (DAC1_P)
DAC2_N: C28.1, U1.30 (DAC2_N)
DAC2_P: C27.1, U1.29 (DAC2_P)
GND: C32.2, C33.2, C34.2, C35.2, C36.2, C37.2, FL1.3 (GND), FL2.3 (GND), J1.2 (Ext), J2.2 (Ext), J3.2 (Ext), J4.2 (Ext), J5.2 (Ext), J6.2 (Ext), J7.2 (Ext), J8.2 (Ext), J9.2 (Ext), J10.2 (Ext), J11.2 (Ext), J12.2 (Ext), J13.2 (Ext), J14.2 (Ext), J15.6, J16.2 (Ext), J17.A1 (GND), J17.A12 (GND), J17.B1 (GND), J17.B12 (GND), J17.SH (SHIELD), J18.2 (Ext), J19.2, J20.2, R1.2, R3.2, R4.2, R6.2, R9.2, R10.2, T1.4 (GND), T2.4 (GND), T3.4 (GND), T4.4 (GND), T5.4 (GND), T6.4 (GND), T7.4 (GND), T8.4 (GND), T9.4 (GND), T10.4 (GND), T11.4 (GND), T12.4 (GND), T13.4 (GND), T14.4 (GND), T15.4 (GND), U1.5 (GND), U1.38 (GND), U2.1 (VIN), U2.3 (VOUT), U2.4 (GND), U2.12 (GND), U2.14 (GND), U2.32 (GND), U2.37 (GND), U2.41 (GND), U2.48 (GND), U2.55 (GND), U3.4 (GND), Y1.3 (GND)
GNSS_EXTINT: U1.36 (GNSS_EXTINT), U2.51 (EXTINT)
GNSS_RESET_N: U1.35 (GNSS_RESET_N), U2.49 (~RESET)
GNSS_RF: C31.1, R2.2, R3.1
GNSS_RXD: U1.33 (GNSS_UART_TX), U2.43 (RXD/SPI_MOSI)
GNSS_RXD2: J15.3, U2.26 (RXD2)
GNSS_SAFEBOOT_N: TP1.1, U2.50 (~SAFEBOOT)
GNSS_SCL: J15.5, R8.2, U2.45 (SCL/SPI_CLK)
GNSS_SDA: J15.4, R7.2, U2.44 (SDA/~SPI_CS)
GNSS_TXD: U1.34 (GNSS_UART_RX), U2.42 (TXD/SPI_MISO)
GNSS_TXD2: J15.2, U2.27 (TXD2)
PPS: J16.1 (In), U1.32 (PPS_IN), U2.53 (TIMEPULSE)
REF_OCXO: U1.1 (IN), Y1.2 (OUT)
REF_OUT: J18.1 (In), U1.4 (OUT2)
REF_SOM: U1.3 (OUT1), U1.31 (REF_10M_IN)
USB_DM: J17.A7 (D-), J17.B7 (D-), U2.39 (USB_DM)
USB_DP: J17.A6 (D+), J17.B6 (D+), U2.40 (USB_DP)
VBUS: J17.A4 (VBUS), J17.A9 (VBUS), J17.B4 (VBUS), J17.B9 (VBUS), U2.38 (V_USB)
ZED_RF: C31.2, U2.2 (EN)

Notes on the sheet:
RFSoC carrier: 12 RF-ADC inputs, STAP beamformer in PL, RF-DAC regenerates clean L-band RF for the ZED-X20P.
RF-DAC0 -> clean GNSS RF -> ZED-X20P
RF-DAC2 -> AJ RF OUT (external receiver)
RF-DAC1 -> CAL OUT (to front-end J_CAL)
u-blox ZED-X20P all-band GNSS (KiCad ZED-F9P symbol/footprint, pin-compatible: VERIFY)
10 MHz reference (common to all RF-ADC/DAC tiles through the SOM clocking)
Power: 12 V in -> SOM; buck 12->5 V (front-end + LDO); LDO 3.3 V (GNSS, clock)
