ajisrawi/polarization-crpa/hardware/element_revC/element_revC.kicad_sch

## KiCad design hardware/element_revC/element_revC.kicad_sch (2026-10-11)

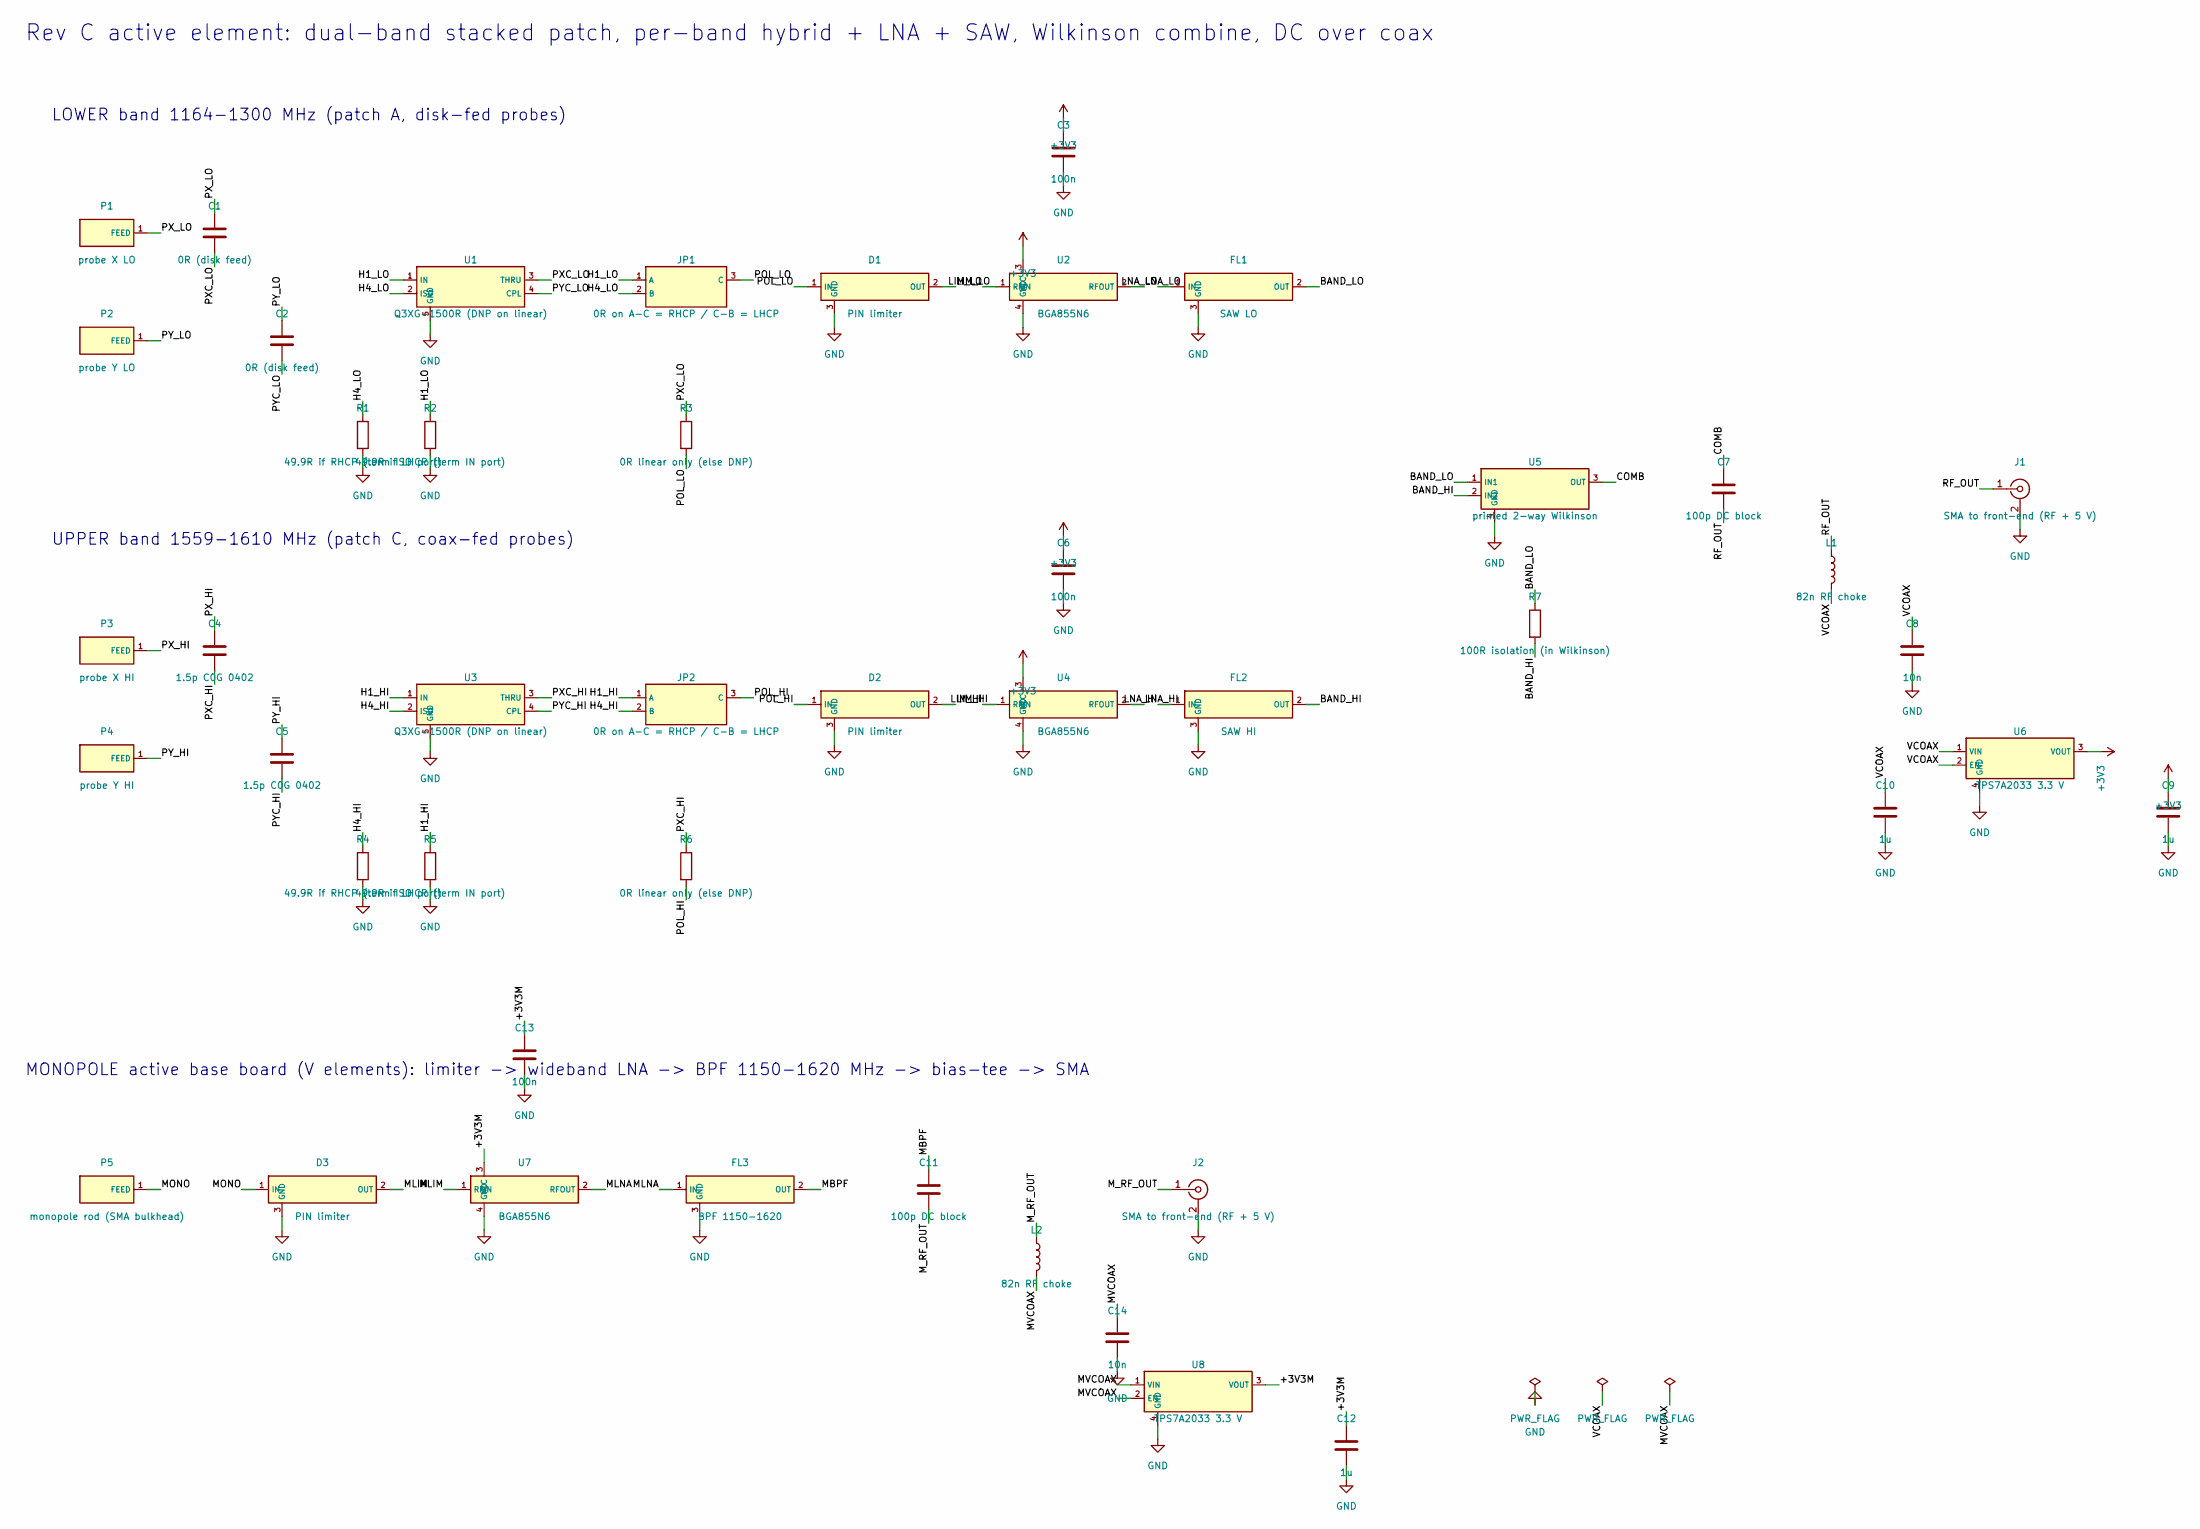
[picture p60: schematic element_revC.kicad_sch]

Parts:
C1, C2: 0R (disk feed)
C3, C6, C13: 100n
C4, C5: 1.5p C0G 0402
C7, C11: 100p DC block
C8, C14: 10n
C9, C10, C12: 1u
D1, D2, D3: PIN limiter
FL1: SAW LO
FL2: SAW HI
FL3: BPF 1150-1620
J1, J2: SMA to front-end (RF + 5 V)
JP1, JP2: 0R on A-C = RHCP / C-B = LHCP
L1, L2: 82n RF choke
P1: probe X LO
P2: probe Y LO
P3: probe X HI
P4: probe Y HI
P5: monopole rod (SMA bulkhead)
R1, R4: 49.9R if RHCP (term ISO port)
R2, R5: 49.9R if LHCP (term IN port)
R3, R6: 0R linear only (else DNP)
R7: 100R isolation (in Wilkinson)
U1, U3: Q3XG-1500R (DNP on linear)
U2, U4, U7: BGA855N6
U5: printed 2-way Wilkinson
U6, U8: TPS7A2033 3.3 V

Connections:
+3V3: C3.1, C6.1, C9.1, U2.3 (VCC), U4.3 (VCC), U6.3 (VOUT)
+3V3M: C12.1, C13.1, U7.3 (VCC), U8.3 (VOUT)
BAND_HI: FL2.2 (OUT), R7.2, U5.2 (IN2)
BAND_LO: FL1.2 (OUT), R7.1, U5.1 (IN1)
COMB: C7.1, U5.3 (OUT)
GND: C3.2, C6.2, C8.2, C9.2, C10.2, C12.2, C13.2, C14.2, D1.3 (GND), D2.3 (GND), D3.3 (GND), FL1.3 (GND), FL2.3 (GND), FL3.3 (GND), J1.2 (Ext), J2.2 (Ext), R1.2, R2.2, R4.2, R5.2, U1.5 (GND), U2.4 (GND), U3.5 (GND), U4.4 (GND), U5.4 (GND), U6.4 (GND), U7.4 (GND), U8.4 (GND)
H1_HI: JP2.1 (A), R5.1, U3.1 (IN)
H1_LO: JP1.1 (A), R2.1, U1.1 (IN)
H4_HI: JP2.2 (B), R4.1, U3.2 (ISO)
H4_LO: JP1.2 (B), R1.1, U1.2 (ISO)
LIM_HI: D2.2 (OUT), U4.1 (RFIN)
LIM_LO: D1.2 (OUT), U2.1 (RFIN)
LNA_HI: FL2.1 (IN), U4.2 (RFOUT)
LNA_LO: FL1.1 (IN), U2.2 (RFOUT)
MBPF: C11.1, FL3.2 (OUT)
MLIM: D3.2 (OUT), U7.1 (RFIN)
MLNA: FL3.1 (IN), U7.2 (RFOUT)
MONO: D3.1 (IN), P5.1
MVCOAX: C14.1, L2.2, U8.1 (VIN), U8.2 (EN)
M_RF_OUT: C11.2, J2.1 (In), L2.1
POL_HI: D2.1 (IN), JP2.3 (C), R6.2
POL_LO: D1.1 (IN), JP1.3 (C), R3.2
PXC_HI: C4.2, R6.1, U3.3 (THRU)
PXC_LO: C1.2, R3.1, U1.3 (THRU)
PX_HI: C4.1, P3.1
PX_LO: C1.1, P1.1
PYC_HI: C5.2, U3.4 (CPL)
PYC_LO: C2.2, U1.4 (CPL)
PY_HI: C5.1, P4.1
PY_LO: C2.1, P2.1
RF_OUT: C7.2, J1.1 (In), L1.1
VCOAX: C8.1, C10.1, L1.2, U6.1 (VIN), U6.2 (EN)

Notes on the sheet:
Rev C active element: dual-band stacked patch, per-band hybrid + LNA + SAW, Wilkinson combine, DC over coax
LOWER band 1164-1300 MHz (patch A, disk-fed probes)
UPPER band 1559-1610 MHz (patch C, coax-fed probes)
MONOPOLE active base board (V elements): limiter -> wideband LNA -> BPF 1150-1620 MHz -> bias-tee -> SMA
