ajisrawi/polarization-crpa/hardware/rf_frontend/rf_frontend.kicad_sch

## KiCad design hardware/rf_frontend/rf_frontend.kicad_sch (2026-10-11)

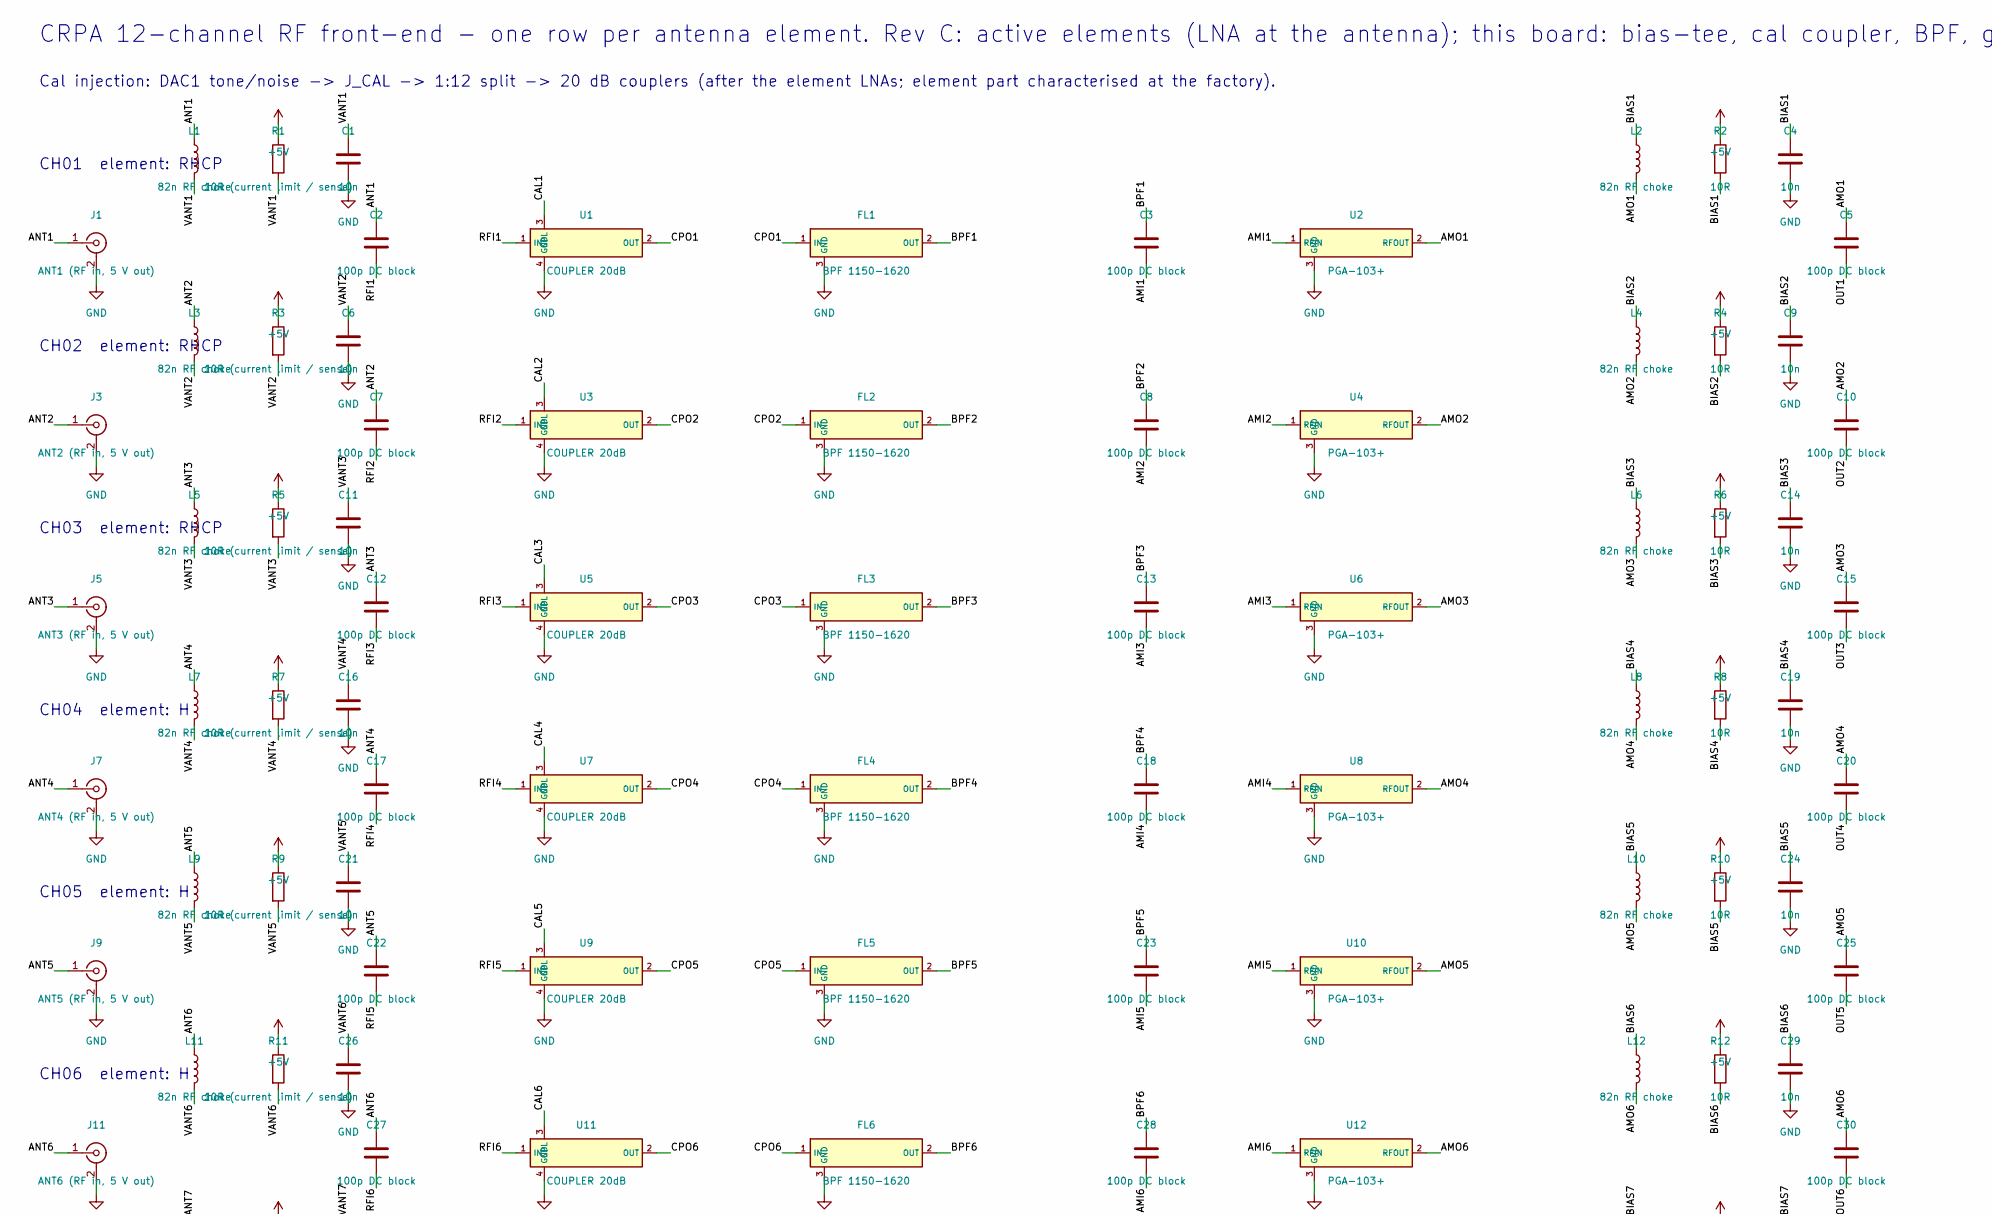
[picture p61: schematic rf_frontend.kicad_sch, part in row 1, column 1]

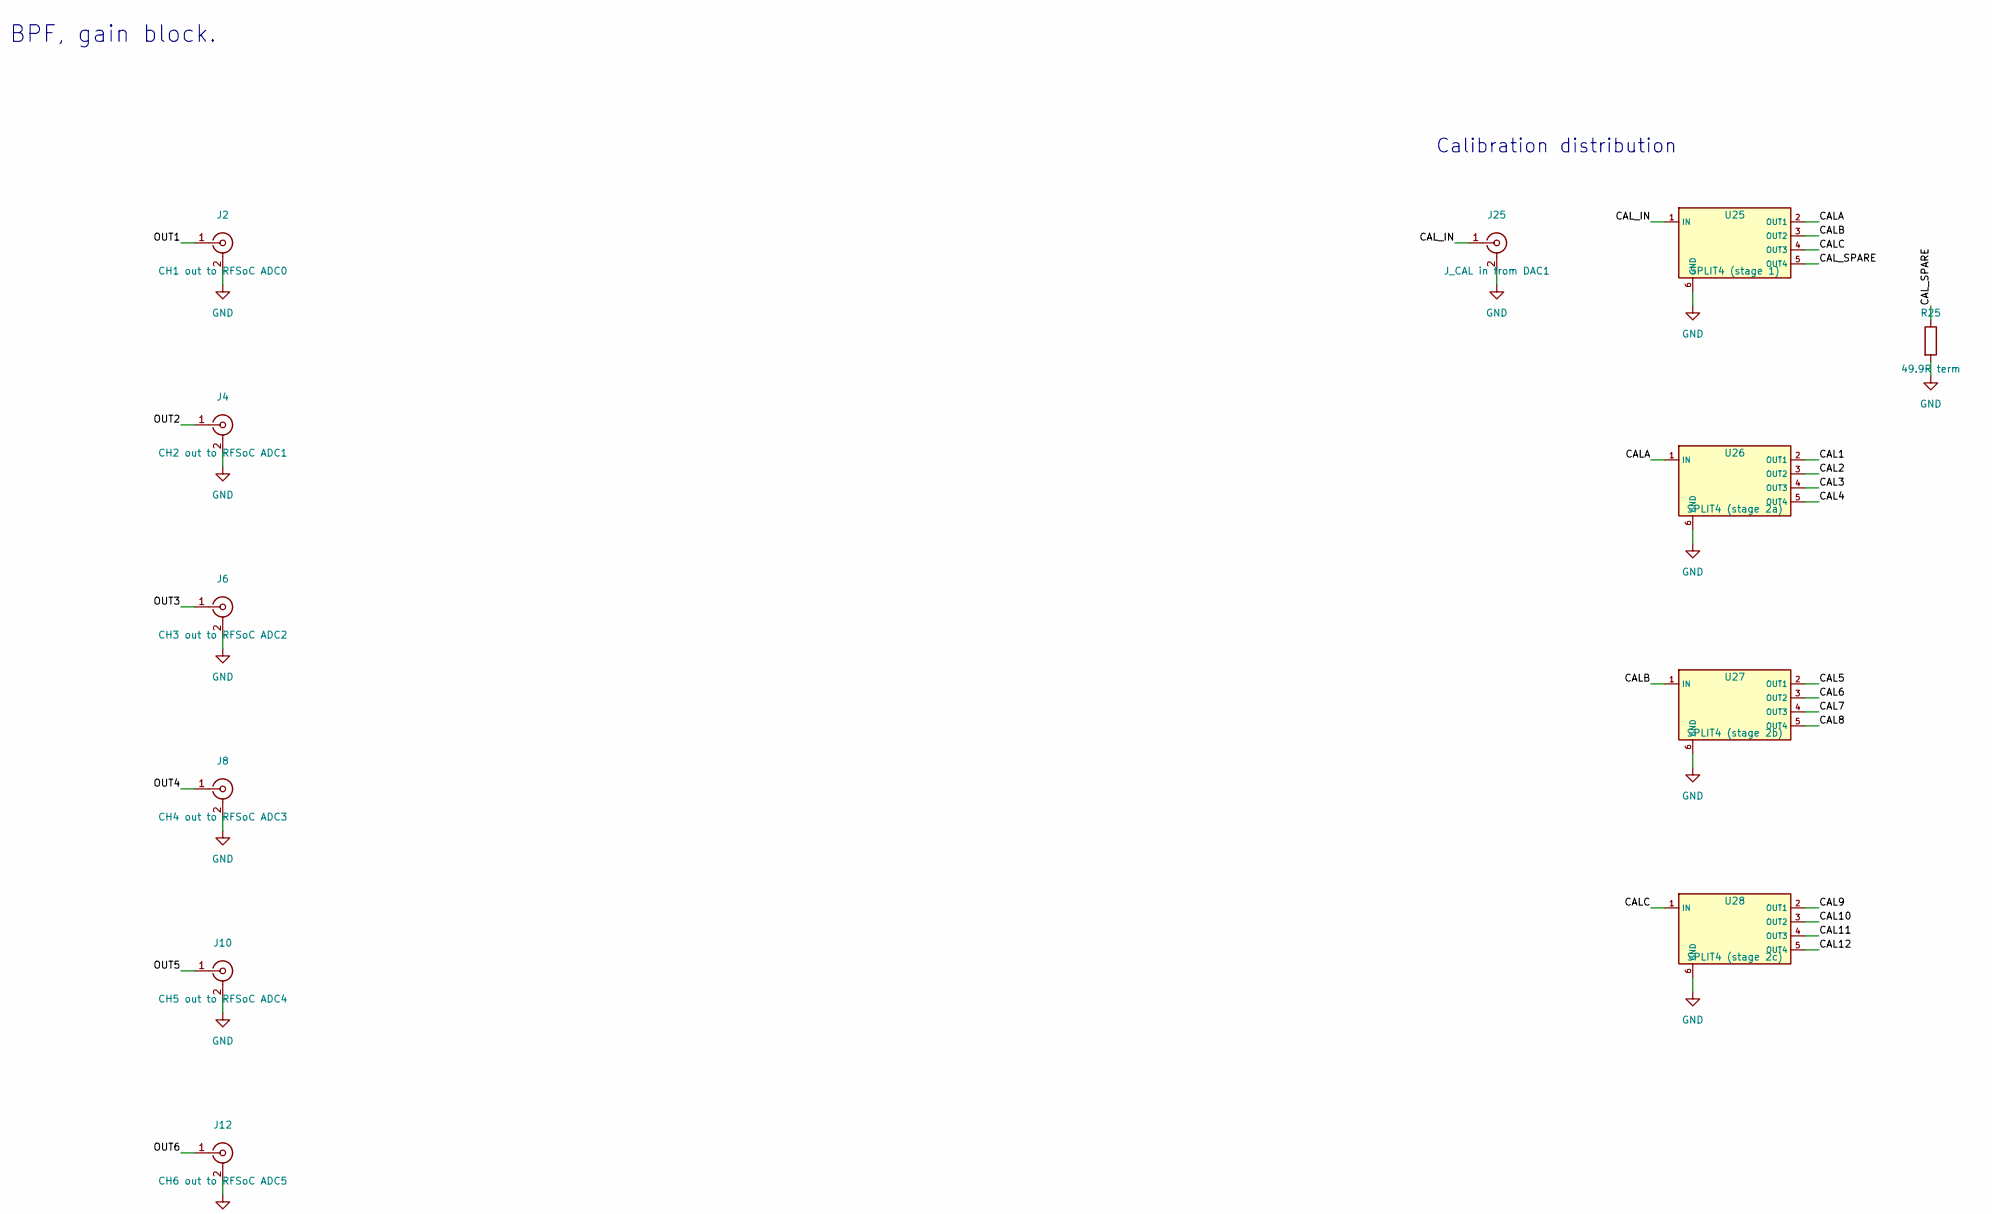
[picture p62: schematic rf_frontend.kicad_sch, part in row 1, column 2]

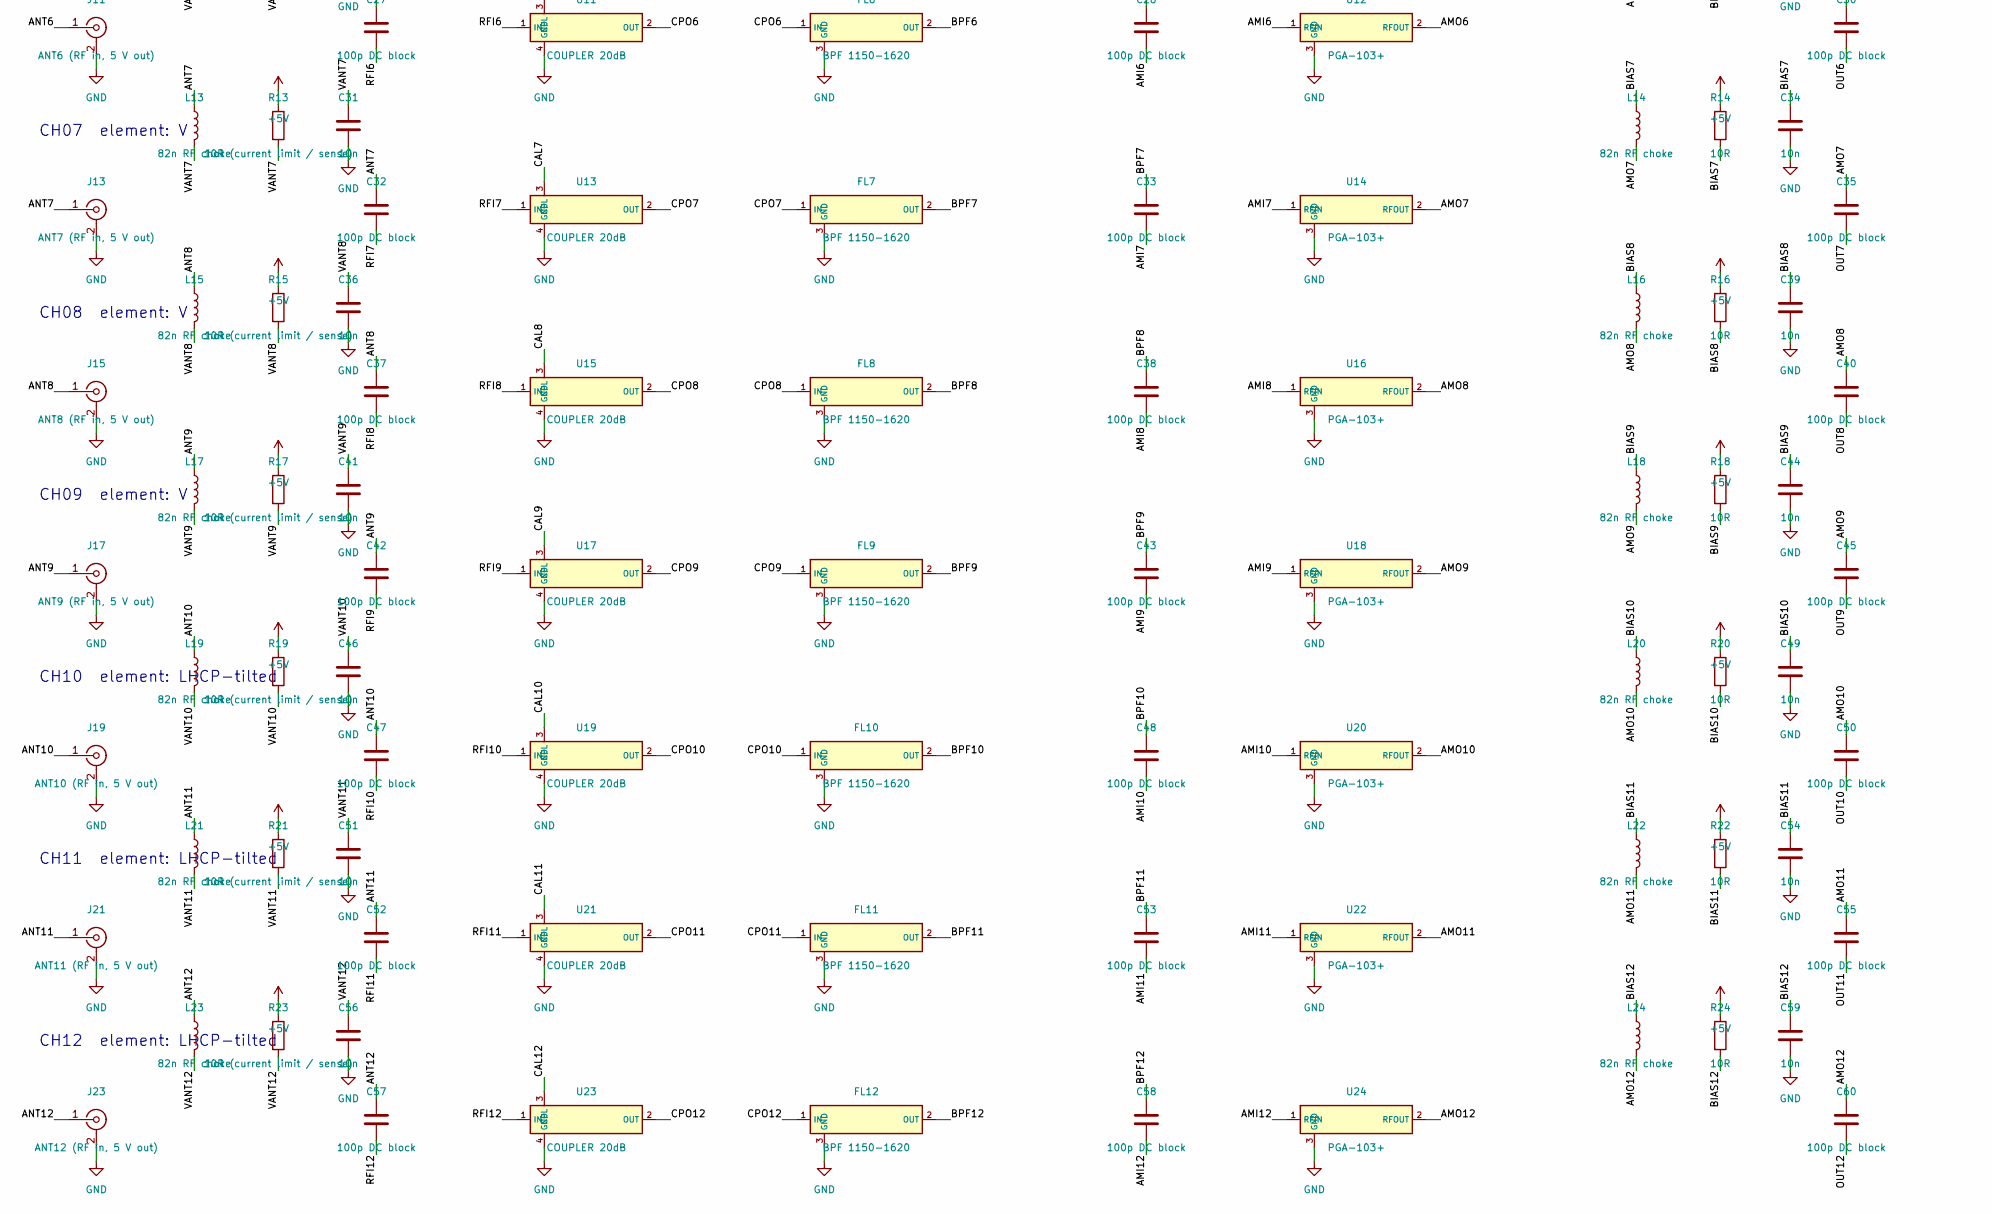
[picture p63: schematic rf_frontend.kicad_sch, part in row 2, column 1]

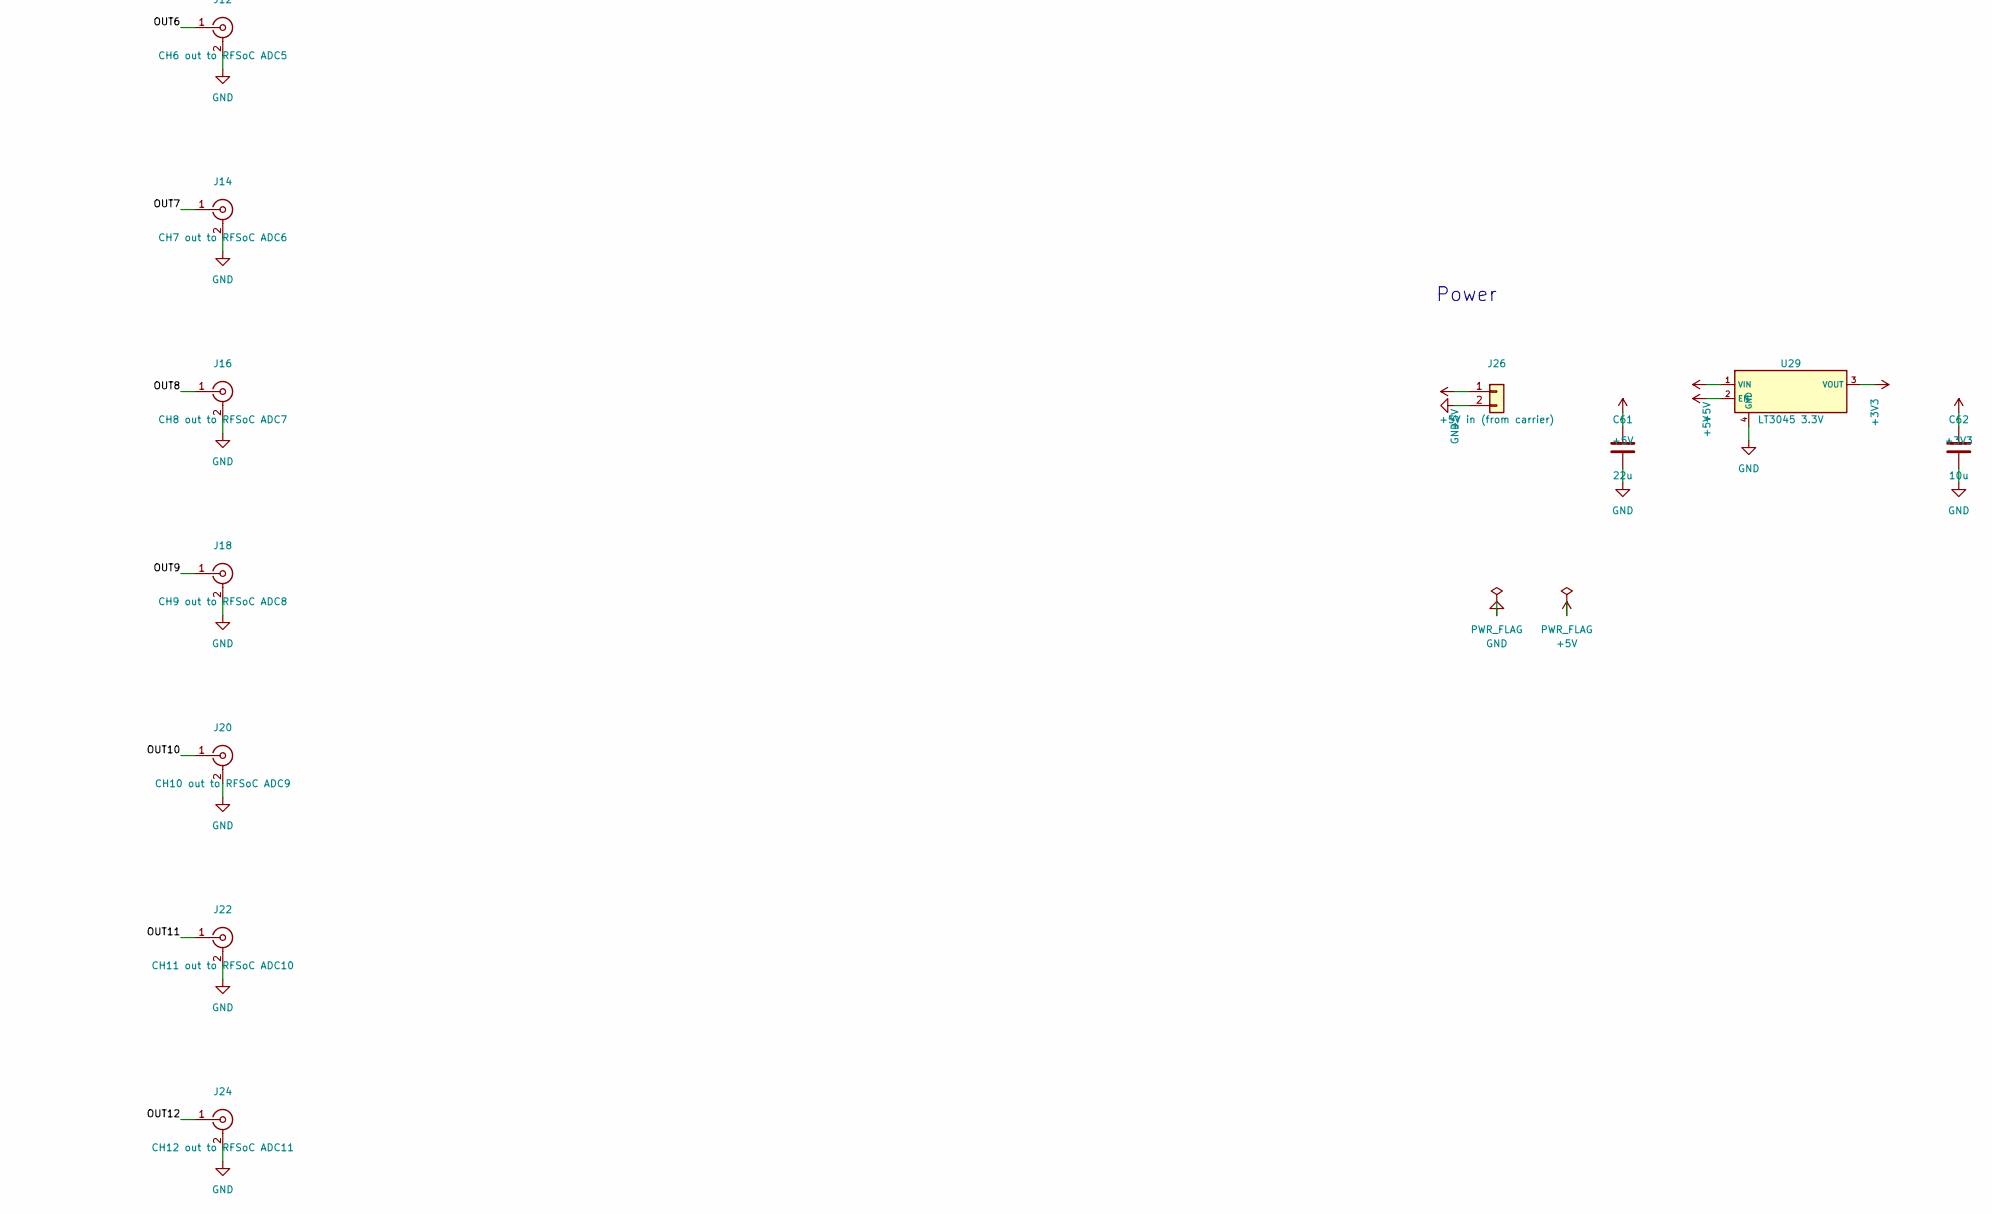
[picture p64: schematic rf_frontend.kicad_sch, part in row 2, column 2]

Parts:
C1, C4, C6, C9, C11, C14, C16, C19, C21, C24, C26, C29, C31, C34, C36, C39, C41, C44, C46, C49, C51, C54, C56, C59: 10n
C2, C3, C5, C7, C8, C10, C12, C13, C15, C17, C18, C20, C22, C23, C25, C27, C28, C30, C32, C33, C35, C37, C38, C40, C42, C43, C45, C47, C48, C50, C52, C53, C55, C57, C58, C60: 100p DC block
C61: 22u
C62: 10u
FL1, FL2, FL3, FL4, FL5, FL6, FL7, FL8, FL9, FL10, FL11, FL12: BPF 1150-1620
J1: ANT1 (RF in, 5 V out)
J2: CH1 out to RFSoC ADC0
J3: ANT2 (RF in, 5 V out)
J4: CH2 out to RFSoC ADC1
J5: ANT3 (RF in, 5 V out)
J6: CH3 out to RFSoC ADC2
J7: ANT4 (RF in, 5 V out)
J8: CH4 out to RFSoC ADC3
J9: ANT5 (RF in, 5 V out)
J10: CH5 out to RFSoC ADC4
J11: ANT6 (RF in, 5 V out)
J12: CH6 out to RFSoC ADC5
J13: ANT7 (RF in, 5 V out)
J14: CH7 out to RFSoC ADC6
J15: ANT8 (RF in, 5 V out)
J16: CH8 out to RFSoC ADC7
J17: ANT9 (RF in, 5 V out)
J18: CH9 out to RFSoC ADC8
J19: ANT10 (RF in, 5 V out)
J20: CH10 out to RFSoC ADC9
J21: ANT11 (RF in, 5 V out)
J22: CH11 out to RFSoC ADC10
J23: ANT12 (RF in, 5 V out)
J24: CH12 out to RFSoC ADC11
J25: J_CAL in from DAC1
J26: +5V in (from carrier)
L1, L2, L3, L4, L5, L6, L7, L8, L9, L10, L11, L12, L13, L14, L15, L16, L17, L18, L19, L20, L21, L22, L23, L24: 82n RF choke
R1, R3, R5, R7, R9, R11, R13, R15, R17, R19, R21, R23: 10R (current limit / sense)
R2, R4, R6, R8, R10, R12, R14, R16, R18, R20, R22, R24: 10R
R25: 49.9R term
U1, U3, U5, U7, U9, U11, U13, U15, U17, U19, U21, U23: COUPLER 20dB
U2, U4, U6, U8, U10, U12, U14, U16, U18, U20, U22, U24: PGA-103+
U25: SPLIT4 (stage 1)
U26: SPLIT4 (stage 2a)
U27: SPLIT4 (stage 2b)
U28: SPLIT4 (stage 2c)
U29: LT3045 3.3V

Connections:
+3V3: C62.1, U29.3 (VOUT)
+5V: C61.1, J26.1, R1.1, R2.1, R3.1, R4.1, R5.1, R6.1, R7.1, R8.1, R9.1, R10.1, R11.1, R12.1, R13.1, R14.1, R15.1, R16.1, R17.1, R18.1, R19.1, R20.1, R21.1, R22.1, R23.1, R24.1, U29.1 (VIN), U29.2 (EN)
AMI1: C3.2, U2.1 (RFIN)
AMI2: C8.2, U4.1 (RFIN)
AMI3: C13.2, U6.1 (RFIN)
AMI4: C18.2, U8.1 (RFIN)
AMI5: C23.2, U10.1 (RFIN)
AMI6: C28.2, U12.1 (RFIN)
AMI7: C33.2, U14.1 (RFIN)
AMI8: C38.2, U16.1 (RFIN)
AMI9: C43.2, U18.1 (RFIN)
AMI10: C48.2, U20.1 (RFIN)
AMI11: C53.2, U22.1 (RFIN)
AMI12: C58.2, U24.1 (RFIN)
AMO1: C5.1, L2.2, U2.2 (RFOUT)
AMO2: C10.1, L4.2, U4.2 (RFOUT)
AMO3: C15.1, L6.2, U6.2 (RFOUT)
AMO4: C20.1, L8.2, U8.2 (RFOUT)
AMO5: C25.1, L10.2, U10.2 (RFOUT)
AMO6: C30.1, L12.2, U12.2 (RFOUT)
AMO7: C35.1, L14.2, U14.2 (RFOUT)
AMO8: C40.1, L16.2, U16.2 (RFOUT)
AMO9: C45.1, L18.2, U18.2 (RFOUT)
AMO10: C50.1, L20.2, U20.2 (RFOUT)
AMO11: C55.1, L22.2, U22.2 (RFOUT)
AMO12: C60.1, L24.2, U24.2 (RFOUT)
ANT1: C2.1, J1.1 (In), L1.1
ANT2: C7.1, J3.1 (In), L3.1
ANT3: C12.1, J5.1 (In), L5.1
ANT4: C17.1, J7.1 (In), L7.1
ANT5: C22.1, J9.1 (In), L9.1
ANT6: C27.1, J11.1 (In), L11.1
ANT7: C32.1, J13.1 (In), L13.1
ANT8: C37.1, J15.1 (In), L15.1
ANT9: C42.1, J17.1 (In), L17.1
ANT10: C47.1, J19.1 (In), L19.1
ANT11: C52.1, J21.1 (In), L21.1
ANT12: C57.1, J23.1 (In), L23.1
BIAS1: C4.1, L2.1, R2.2
BIAS2: C9.1, L4.1, R4.2
BIAS3: C14.1, L6.1, R6.2
BIAS4: C19.1, L8.1, R8.2
BIAS5: C24.1, L10.1, R10.2
BIAS6: C29.1, L12.1, R12.2
BIAS7: C34.1, L14.1, R14.2
BIAS8: C39.1, L16.1, R16.2
BIAS9: C44.1, L18.1, R18.2
BIAS10: C49.1, L20.1, R20.2
BIAS11: C54.1, L22.1, R22.2
BIAS12: C59.1, L24.1, R24.2
BPF1: C3.1, FL1.2 (OUT)
BPF2: C8.1, FL2.2 (OUT)
BPF3: C13.1, FL3.2 (OUT)
BPF4: C18.1, FL4.2 (OUT)
BPF5: C23.1, FL5.2 (OUT)
BPF6: C28.1, FL6.2 (OUT)
BPF7: C33.1, FL7.2 (OUT)
BPF8: C38.1, FL8.2 (OUT)
BPF9: C43.1, FL9.2 (OUT)
BPF10: C48.1, FL10.2 (OUT)
BPF11: C53.1, FL11.2 (OUT)
BPF12: C58.1, FL12.2 (OUT)
CAL1: U1.3 (CPL), U26.2 (OUT1)
CAL2: U3.3 (CPL), U26.3 (OUT2)
CAL3: U5.3 (CPL), U26.4 (OUT3)
CAL4: U7.3 (CPL), U26.5 (OUT4)
CAL5: U9.3 (CPL), U27.2 (OUT1)
CAL6: U11.3 (CPL), U27.3 (OUT2)
CAL7: U13.3 (CPL), U27.4 (OUT3)
CAL8: U15.3 (CPL), U27.5 (OUT4)
CAL9: U17.3 (CPL), U28.2 (OUT1)
CAL10: U19.3 (CPL), U28.3 (OUT2)
CAL11: U21.3 (CPL), U28.4 (OUT3)
CAL12: U23.3 (CPL), U28.5 (OUT4)
CALA: U25.2 (OUT1), U26.1 (IN)
CALB: U25.3 (OUT2), U27.1 (IN)
CALC: U25.4 (OUT3), U28.1 (IN)
CAL_IN: J25.1 (In), U25.1 (IN)
CAL_SPARE: R25.1, U25.5 (OUT4)
CPO1: FL1.1 (IN), U1.2 (OUT)
CPO2: FL2.1 (IN), U3.2 (OUT)
CPO3: FL3.1 (IN), U5.2 (OUT)
CPO4: FL4.1 (IN), U7.2 (OUT)
CPO5: FL5.1 (IN), U9.2 (OUT)
CPO6: FL6.1 (IN), U11.2 (OUT)
CPO7: FL7.1 (IN), U13.2 (OUT)
CPO8: FL8.1 (IN), U15.2 (OUT)
CPO9: FL9.1 (IN), U17.2 (OUT)
CPO10: FL10.1 (IN), U19.2 (OUT)
CPO11: FL11.1 (IN), U21.2 (OUT)
CPO12: FL12.1 (IN), U23.2 (OUT)
GND: C1.2, C4.2, C6.2, C9.2, C11.2, C14.2, C16.2, C19.2, C21.2, C24.2, C26.2, C29.2, C31.2, C34.2, C36.2, C39.2, C41.2, C44.2, C46.2, C49.2, C51.2, C54.2, C56.2, C59.2, C61.2, C62.2, FL1.3 (GND), FL2.3 (GND), FL3.3 (GND), FL4.3 (GND), FL5.3 (GND), FL6.3 (GND), FL7.3 (GND), FL8.3 (GND), FL9.3 (GND), FL10.3 (GND), FL11.3 (GND), FL12.3 (GND), J1.2 (Ext), J2.2 (Ext), J3.2 (Ext), J4.2 (Ext), J5.2 (Ext), J6.2 (Ext), J7.2 (Ext), J8.2 (Ext), J9.2 (Ext), J10.2 (Ext), J11.2 (Ext), J12.2 (Ext), J13.2 (Ext), J14.2 (Ext), J15.2 (Ext), J16.2 (Ext), J17.2 (Ext), J18.2 (Ext), J19.2 (Ext), J20.2 (Ext), J21.2 (Ext), J22.2 (Ext), J23.2 (Ext), J24.2 (Ext), J25.2 (Ext), J26.2, R25.2, U1.4 (GND), U2.3 (GND), U3.4 (GND), U4.3 (GND), U5.4 (GND), U6.3 (GND), U7.4 (GND), U8.3 (GND), U9.4 (GND), U10.3 (GND), U11.4 (GND), U12.3 (GND), U13.4 (GND), U14.3 (GND), U15.4 (GND), U16.3 (GND), U17.4 (GND), U18.3 (GND), U19.4 (GND), U20.3 (GND), U21.4 (GND), U22.3 (GND), U23.4 (GND), U24.3 (GND), U25.6 (GND), U26.6 (GND), U27.6 (GND), U28.6 (GND), U29.4 (GND)
OUT1: C5.2, J2.1 (In)
OUT2: C10.2, J4.1 (In)
OUT3: C15.2, J6.1 (In)
OUT4: C20.2, J8.1 (In)
OUT5: C25.2, J10.1 (In)
OUT6: C30.2, J12.1 (In)
OUT7: C35.2, J14.1 (In)
OUT8: C40.2, J16.1 (In)
OUT9: C45.2, J18.1 (In)
OUT10: C50.2, J20.1 (In)
OUT11: C55.2, J22.1 (In)
OUT12: C60.2, J24.1 (In)
RFI1: C2.2, U1.1 (IN)
RFI2: C7.2, U3.1 (IN)
RFI3: C12.2, U5.1 (IN)
RFI4: C17.2, U7.1 (IN)
RFI5: C22.2, U9.1 (IN)
RFI6: C27.2, U11.1 (IN)
RFI7: C32.2, U13.1 (IN)
RFI8: C37.2, U15.1 (IN)
RFI9: C42.2, U17.1 (IN)
RFI10: C47.2, U19.1 (IN)
RFI11: C52.2, U21.1 (IN)
RFI12: C57.2, U23.1 (IN)
VANT1: C1.1, L1.2, R1.2
VANT2: C6.1, L3.2, R3.2
VANT3: C11.1, L5.2, R5.2
VANT4: C16.1, L7.2, R7.2
VANT5: C21.1, L9.2, R9.2
VANT6: C26.1, L11.2, R11.2
VANT7: C31.1, L13.2, R13.2
VANT8: C36.1, L15.2, R15.2
VANT9: C41.1, L17.2, R17.2
VANT10: C46.1, L19.2, R19.2
VANT11: C51.1, L21.2, R21.2
VANT12: C56.1, L23.2, R23.2

Notes on the sheet:
CRPA 12-channel RF front-end - one row per antenna element. Rev C: active elements (LNA at the antenna); this board: bias-tee, cal coupler, BPF, gain block.
Cal injection: DAC1 tone/noise -> J_CAL -> 1:12 split -> 20 dB couplers (after the element LNAs; element part characterised at the factory).
CH01 element: RHCP
CH02 element: RHCP
CH03 element: RHCP
CH04 element: H
CH05 element: H
CH06 element: H
CH07 element: V
CH08 element: V
CH09 element: V
CH10 element: LHCP-tilted
CH11 element: LHCP-tilted
CH12 element: LHCP-tilted
Calibration distribution
Power
